bens-unit01/switchbot-complete-prj/documents/boards-shematics/pin-j20-j12.jpg

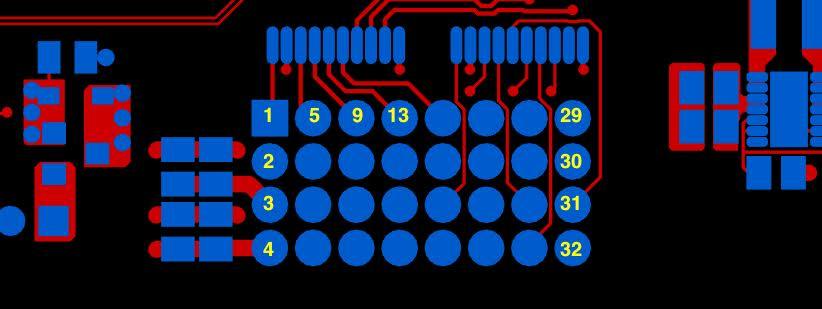
documents/boards-shematics/pin-j20-j12.jpg
