bens-unit01/switchbot-complete-prj/documents/new-features-and-suggestions.md

## New features 
```
    - Power button 
    - Microphone button
    - Pairing button
    - Support for 5-Ghz wifi 
```
## Possible network technologies 
```
 - DLNA
 - Bonjour
 - NSD (https://developer.android.com/training/connect-devices-wirelessly/nsd.html)
 - Alljoyn (https://allseenalliance.org/framework)
 - UPnP 
```
