bens-unit01/switchbot-complete-prj/microcontrollers/notes.txt

Arduino lib for NeoPixels : https://github.com/adafruit/Adafruit_NeoPixel
Product details : http://www.adafruit.com/product/1312
