bens-unit01/switchbot-complete-prj/documents/Audio/stm32_mic_interfacing_for_wowwee_13june2016.pdf

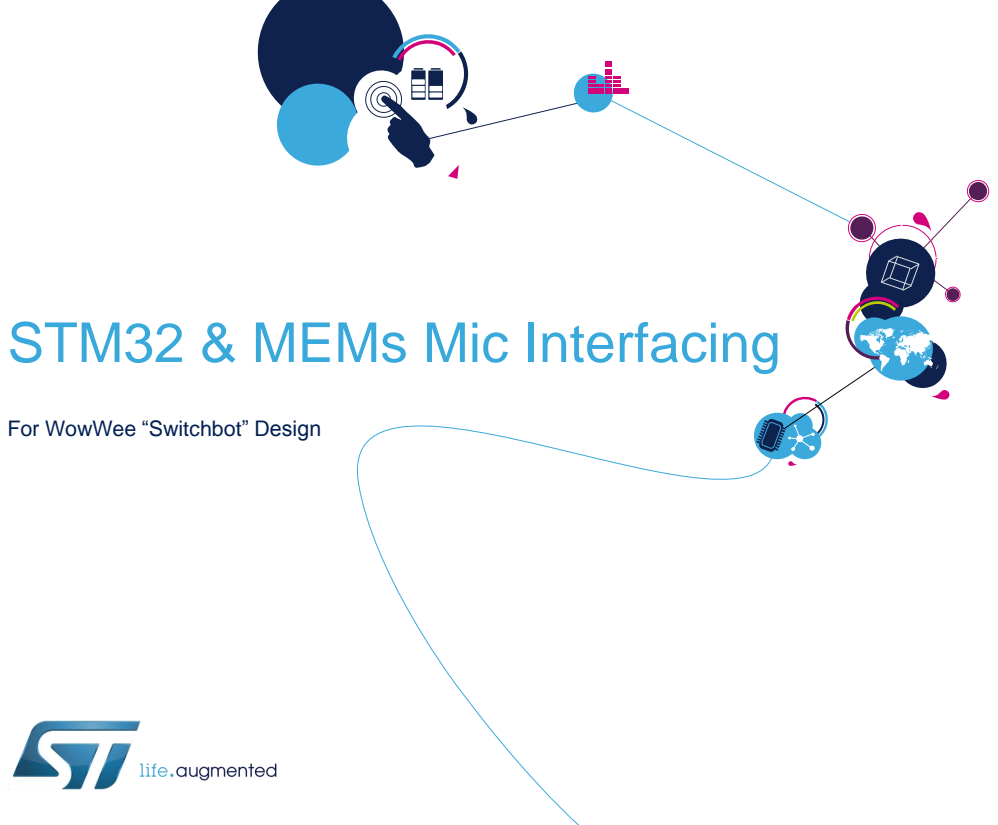
[picture p3: page 1]

STM32 & MEMs Mic Interfacing

For WowWee “Switchbot” Design

# Summary

## - This document presents recommendations for connecting ST digital MEMs microphones to an STM32F417 on WowWee’s “Switchbot” design, for the purposes of evaluating beamforming and other audio signal processing applications

## - Summary of options:

## - Option A: Single serial I2S receiver connected to 2 digital mics. Microphone PDM streams are interleaved

- Minimizes # of I2S receivers and hence required DMA channels
- Requires more board re-work + specific timers

## - Option B: Dual serial I2S receivers connected to 2 digital mics. Microphone PDM streams are separate

- Minimizes board re-work and no extra timer usage needed
- Requires additional DMA channel vs. Option A

## - Option C: Combination of option A & B to support 4 digital mics (2 serial data streams, each with 2 PDM streams interleaved)

- Requires combination of resources from Options A & B

2

# Signal/Pin Mappings

## - WowWee board -> STM32F417 I2S pin mappings

## - Choice of which I2S to use for mic vs. SOM interfacing doesn’t really matter

- For the purposes of this document we chose I2S3 (from STM32 perspective) for microphone interfacing
- May also require a timer with in/out to generate I2S clock divided by 2 (see next slides for proposed configs)
a) These signals appear to have resistor pop/no-pop options for usage as I2S or SPI. Assumed I2S usage only here.
b) Signal is routed to multiple pins via resistor options – only primary I2S usage is noted

3

WowWee | STM32F417
I2S1_CLK I2S1_DATA0 I2S1_DATA1 I2S1_WS | I2S2_CLK – PB12a Grounded I2S2_SD – PC3a I2S2_WS – PB13a
I2S2_CLK I2S2_DATA I2S2_WS | I2S3_CLK – PC10b I2S3_SD – PC12b I2S3_WS – PA15

# Timer Config – Option A/C

## - To support two mics on a single I2S, we need to use a timer to generate I2S_CLK/2 for each mic. Normally done with one STM32

timer.

## - This is not fully accounted for in the I2S signals brought out by the design, but we can make use of some of the alternate signals that already have resistor options to simplify the board rework

## - TIM2_CH1 will be used as input (taking the full speed I2S_CLK)

## - TIM3 synchronized to TIM2 through internal trigger/synchronization

## - TIM3_CH4 used to generate I2S_CLK/2 for microphones

4

# Option A - Recommended Connections 5

## STM32F417VGT6

I2S2_CLK – PB12
I2S2_SD – PC3
I2S2_WS – PB13

I2S1_CLK
I2S1_DATA1
I2S1_WS

To apps processor SOM via
level translator on schematic. Use as half-duplex channel to transmit processed audio

I2S3_CLK – PC10

I2S3_SD – PC12

I2S2_WS WS not needed,
re-purpose for
timer input

TIM2_CH1 – PA15

TIM3_CH4 – PC9

## MIC1

CLK

DOUT

LR

VDD

VSS

## MIC2

CLK

DOUT

LR

VDD

VSS

3V3

GND

# Option B - Recommended Connections 6

## STM32F417VGT6

I2S2_CLK – PB12
I2S2_SD – PC3
I2S2_WS – PB13

I2S1_CLK
I2S1_DATA1
I2S1_WS

To apps processor SOM via
level translator on schematic. Use as half-duplex channel to transmit processed audio

I2S3_CLK – PC10

I2S3_SD – PC12

I2S3_ext_SD – PC11

## MIC1

CLK

DOUT

LR

VDD

VSS

## MIC2

CLK

DOUT

LR

VDD

VSS

3V3

GND

# Option C - Recommended Connections 7

## STM32F417VGT6

I2S2_CLK – PB12
I2S2_SD – PC3
I2S2_WS – PB13

I2S1_CLK
I2S1_DATA1
I2S1_WS

To apps processor SOM via
level translator on schematic. Use as half-duplex channel to transmit processed audio

I2S3_CLK – PC10

I2S3_SD – PC12

I2S2_WS WS not needed,
re-purpose for
timer input

TIM2_CH1 – PA15

TIM3_CH4 – PC9

MIC1

CLK

DOUT

LR

VDD

VSS

3V3

GND

MIC2

CLK

DOUT

LR

VDD

VSS

MIC3

CLK

DOUT

LR

VDD

VSS

MIC4

CLK

DOUT

LR

VDD

VSS

I2S3_ext_SD – PC11

# Microphone Options

## - All of the ST digital microphones are PDM output. The two that are suggested for this application are:

8

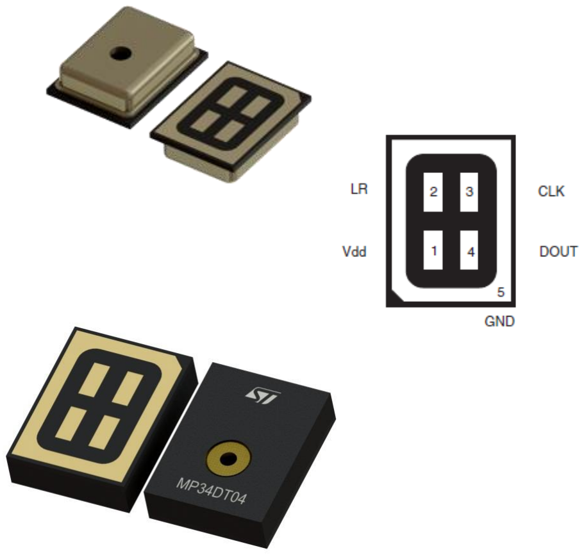
[picture p4: figure]
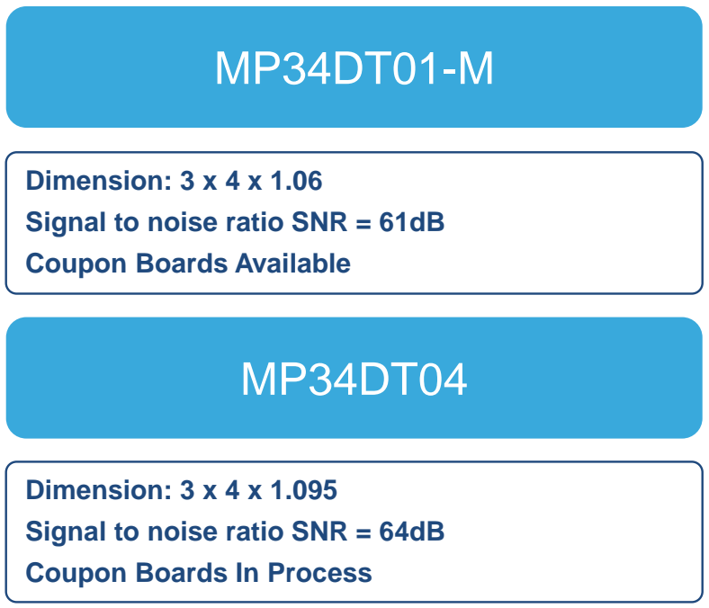
[picture p5: figure]
Dimension: 3 x 4 x 1.06; Signal to noise ratio SNR = 61dB; Coupon Boards Available; Dimension: 3 x 4 x 1.095; Signal to noise ratio SNR = 64dB; Coupon Boards In Process

## For prototyping mics – recommend using ST “coupon” boards, e.g.: http://www.st.com/content/st_com/en/products/evaluation-tools/product-

evaluation-tools/audio-ic-eval-boards/steval-mki155v3.html (http://www.st.com/content/st_com/en/products/evaluation-tools/product-evaluation-tools/audio-ic-eval-boards/steval-mki155v3.html)
