bens-unit01/switchbot-complete-prj/addons/Telepresence/TelepresenceUser/src/img/Background_DPad.png

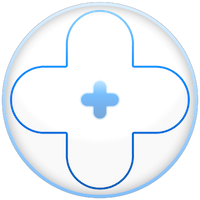
addons/Telepresence/TelepresenceUser/src/img/Background_DPad.png
