bens-unit01/switchbot-complete-prj/android/SwitchBot-class-diagram.png

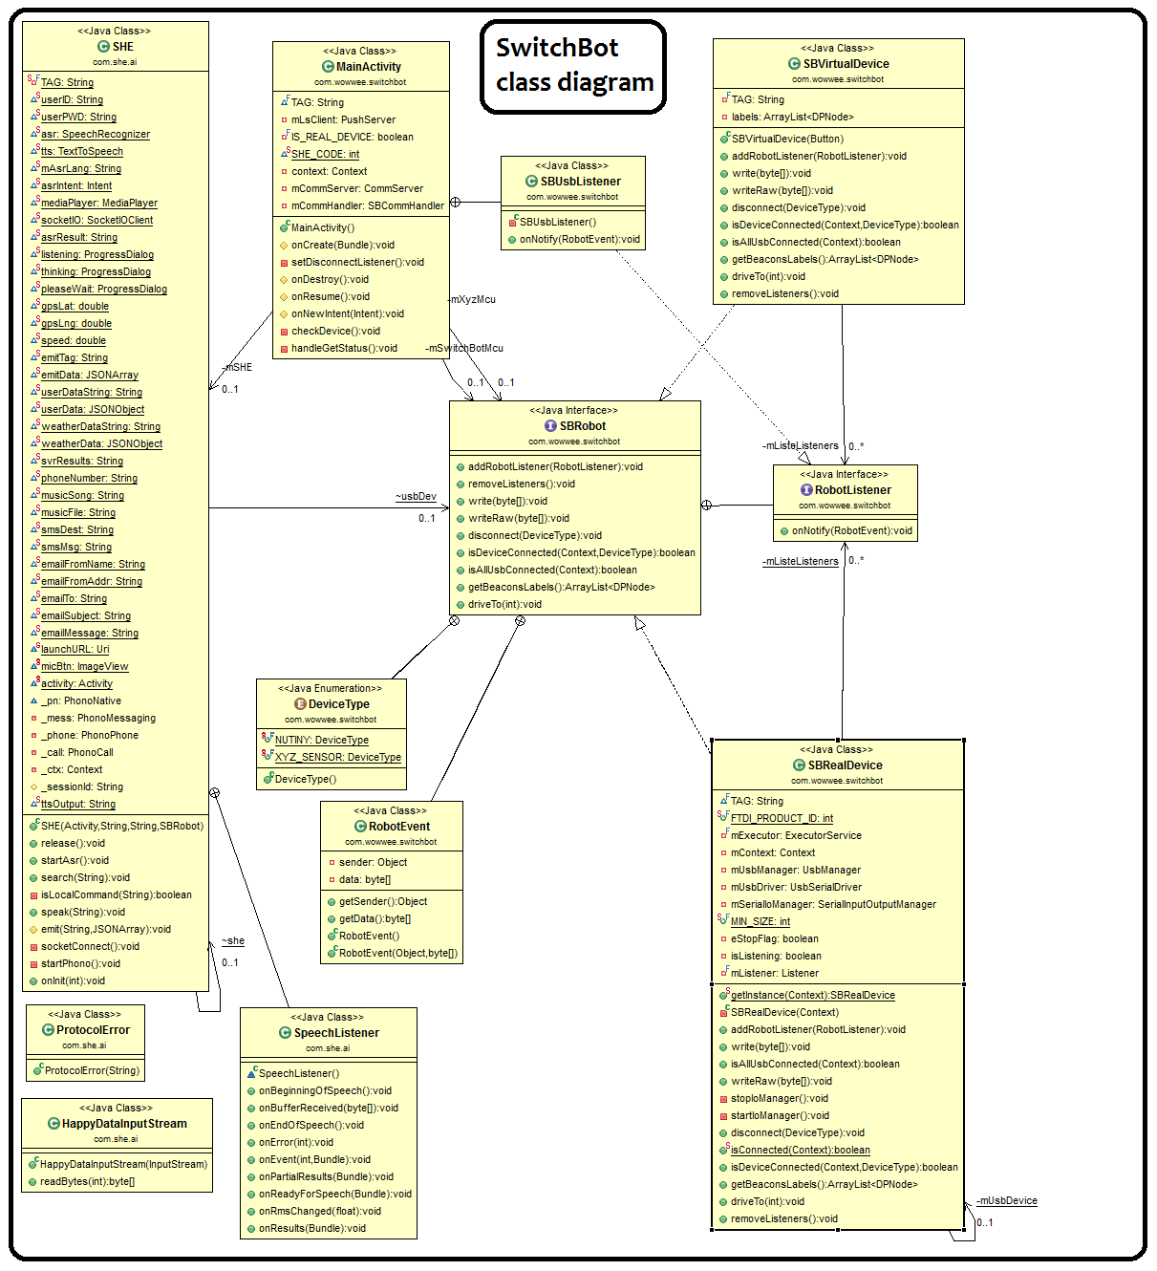
android/SwitchBot-class-diagram.png
