bens-unit01/switchbot-complete-prj/documents/boards-shematics/som-motor-power.png

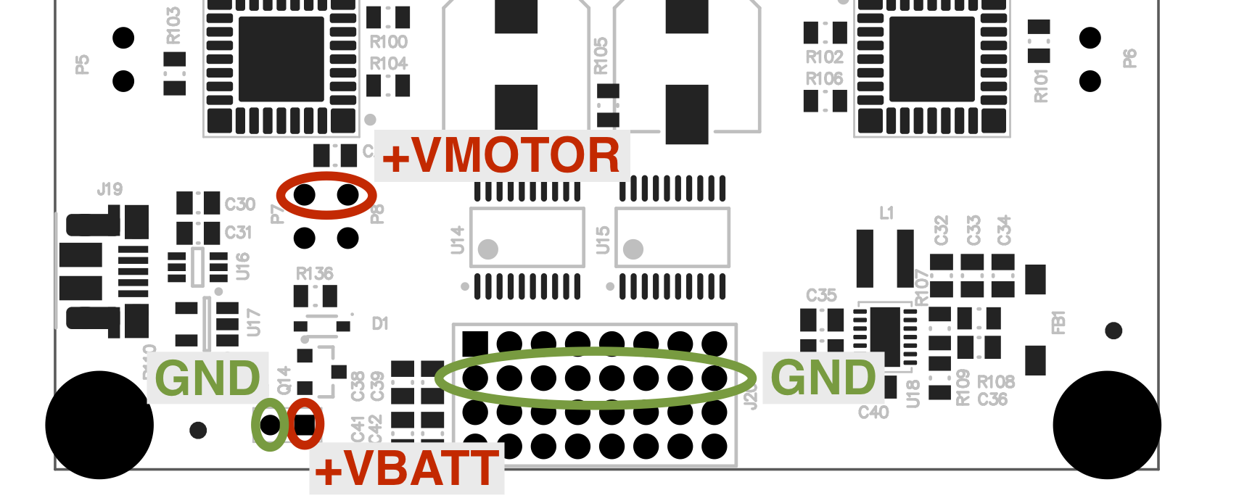
documents/boards-shematics/som-motor-power.png
