bens-unit01/switchbot-complete-prj/documents/boards-shematics/Motor Control/sommotor-BOM.xlsx

Wowwee SOM Motor Board
20160322a | Last Revision
Revision History
20160322a | Initial Release
 | Gray background are parts sourced by Andrew
 | Car-San part numbers are given in approximate order of preference
Quantity | Vendor | Mfg PN | Description | Alternatives | Notes | Digikey Part Number | Car-San Part Number | Designator
14 | Any |  | CAP 1uF 6.3V ±5% 0805 |  |  |  | 1011249LF, 1011464LF, 1011545LF, 1011030LF | C1, C39, C42, C43, C46, C48, C49, C53, C55, C60, C61, C62, C63, C65
32 | Any |  | CAP 100nF 6.3V ±10% 0805 |  |  |  | 1510364, 1010714LF, 1011250LF, 1011819LF, 1011854LF | C2, C5, C6, C7, C9, C11, C12, C13, C17, C18, C22, C24, C25, C31, C34, C38, C40, C41, C44, C45, C50, C51, C52, C54, C56, C57, C58, C59, C64, C66, C67, C69
1 | Any |  | CAP 220nF 6.3V ±20% 0805 |  |  | 490-6981-6-ND (http://www.digikey.ca/product-detail/en/murata-electronics-north-america/NFM21PC224R1C3D/490-6981-6-ND/3847194) |  | C3
2 | Any |  | CAP 2.2uF 6.3V ±20% 0805 |  |  |  | 1011462LF, 1011256LF, 1011495LF, 1011013LF | C4, C8
6 | Any |  | CAP 33nF 50V -20% to +80% 0805 |  |  | 445-2675-6-ND (http://www.digikey.ca/product-detail/en/tdk-corporation/C2012C0G1E333J125AA/445-2675-6-ND/1596682) |  | C10, C16, C19, C23, C26, C29
6 | Wurth | 865080253012 | 470 uF, 10 V, + / - 20%, Aluminum Electrolytic Capacitor |  | low ESR, high ripple | 732-8495-1-ND (http://www.digikey.ca/product-detail/en/wurth-electronics-inc/865080253012/732-8495-1-ND/5728452) |  | C14, C15, C20, C21, C27, C28
4 | Any |  | CAP 10uF 6.3V ±10% 0805 |  |  |  | 1010084LF, 1011252LF, | C30, C35, C37, C68
2 | Any |  | CAP 22uF 16V ±20% 0805 |  |  | 399-11661-6-ND (http://www.digikey.ca/scripts/DkSearch/dksus.dll?Detail&itemSeq=190086075&uq=635912567441065872) |  | C32, C33
1 | Any |  | CAP 4.7pF 10V ±0.25pF 0805 |  |  | 399-8105-6-ND (http://www.digikey.ca/scripts/DkSearch/dksus.dll?Detail&itemSeq=190086122&uq=635912569007175872) |  | C36
1 | Any |  | CAP 4.7uF 6.3V ±20% 0805 |  |  |  | 1010082LF, 1011257LF, 1510352 | C47
1 | Infineon | BAT60AE6327HTSA1 | Silicon Schottky Diode, -55 to 85 degC, SOD323 |  |  | BAT60AE6327HTSA1DKR-ND (http://www.digikey.ca/product-detail/en/infineon-technologies/BAT60AE6327HTSA1/BAT60AE6327HTSA1DKR-ND/1557958) |  | D1
1 | Murata | BLM41PG750SN1L | BLM41 |  |  | 490-4013-6-ND (http://www.digikey.ca/product-detail/en/murata-electronics-north-america/BLM41PG750SN1L/490-4013-6-ND/1826391) |  | FB1
8 | Hirose | DF13-3P-1.25DS(20) (http://www.digikey.ca/product-detail/en/hirose-electric-co-ltd/DF13-3P-1.25DS(20)/H2260-ND/241839) | 1.25mm pitch R/A TH connector, 3 pin (http://www.digikey.ca/product-detail/en/hirose-electric-co-ltd/DF13-3P-1.25DS(20)/H2260-ND/241839) |  |  | H2260-ND (http://www.digikey.ca/product-detail/en/hirose-electric-co-ltd/DF13-3P-1.25DS(20)/H2260-ND/241839) |  | J1, J2, J3, J4, J5, J6, J7, J8
4 | Hirose | DF13-2P-1.25DS(20) (http://www.digikey.ca/product-detail/en/hirose-electric-co-ltd/DF13-2P-1.25DS(20)/H2199-ND/241773) | 1.25mm pitch R/A TH connector, 2 pin (http://www.digikey.ca/product-detail/en/hirose-electric-co-ltd/DF13-3P-1.25DS(20)/H2260-ND/241839) |  |  | H2199-ND (http://www.digikey.ca/product-detail/en/hirose-electric-co-ltd/DF13-2P-1.25DS(20)/H2199-ND/241773) |  | J9, J11, J14, J15
6 | Hirose | DF13-5P-1.25DS(20) (http://www.digikey.ca/product-detail/en/hirose-electric-co-ltd/DF13-5P-1.25DS(20)/H2202-ND/241775) | 1.25mm pitch R/A TH connector, 5 pin (http://www.digikey.ca/product-detail/en/hirose-electric-co-ltd/DF13-3P-1.25DS(20)/H2260-ND/241839) |  |  | H2202-ND (http://www.digikey.ca/product-detail/en/hirose-electric-co-ltd/DF13-5P-1.25DS(20)/H2202-ND/241775) |  | J10, J12, J13, J16, J17, J18
1 | FCI | 10103594 | USB Micro connector |  |  | 609-4050-6-ND (http://www.digikey.ca/scripts/DkSearch/dksus.dll?Detail&itemSeq=190086307&uq=635912571760595872) |  | J19
1 | Samtec | SQT-108-01-F-Q | Cost-Effective Rugged Socket, Through-hole, Vertical, -55 to 125 degC, 2 mm Pitch, 32-Pin, Female, RoHS |  |  |  |  | J20
1 | JST | B2B-PH-K-S(LF)(SN) | 2mm pitch battery connector |  |  | 455-1704-ND (https://www.digikey.ca/product-detail/en/jst-sales-america-inc/B2B-PH-K-S(LF)(SN)/455-1704-ND/926611) |  | K1
1 | TDK | VLS4012ET-1R0N | 1uH 2.5A inductor |  |  | 445-6683-6-ND (http://www.digikey.ca/scripts/DkSearch/dksus.dll?Detail&itemSeq=190086726&uq=635912577969590181) |  | L1
2 | Any |  | LED RED 0402 SMD |  |  |  | 1011048LF, 4010071, 1011625LF | LED1, LED4
2 | Any |  | LED GREEN 0402 SMD |  |  |  | 1011777LF, 4010070, 4010111, 4010087 | LED2, LED3
8 | TE Connectivity | 5-103735-1 (http://www.digikey.ca/product-detail/en/te-connectivity-amp-connectors/5-103735-1/A33921-ND/1122484) | 0.100" pitch vert TH connector, 2 pin |  |  | A33921-ND (http://www.digikey.ca/product-detail/en/te-connectivity-amp-connectors/5-103735-1/A33921-ND/1122484) |  | P1, P2, P3, P4, P5, P6, P7, P8
12 | Any | MMBT3904 | SOT23 NPN Transistor |  |  | MMBT3904LT1GOSDKR-ND (http://www.digikey.ca/product-detail/en/on-semiconductor/MMBT3904LT1G/MMBT3904LT1GOSDKR-ND/1140144) |  | Q1, Q2, Q3, Q4, Q5, Q6, Q7, Q8, Q9, Q10, Q11, Q12
1 | Any | BSS84 | SOT23 P-Channel MOSFET |  |  |  | 1011865LF | Q13
1 | Diodes | DMG2305UX | SOT23 P-Channel MOSFET |  |  | DMG2305UX-7DICT-ND (http://www.digikey.ca/scripts/DkSearch/dksus.dll?Detail&itemSeq=190086903&uq=635912580803995872) |  | Q14
1 | Any |  | 56k2 0.125W 1% 0805 (2012 Metric) SMD |  |  | 541-56.2KCDKR-ND (https://www.digikey.ca/product-detail/en/vishay-dale/CRCW080556K2FKEA/541-56.2KCDKR-ND/1187460) |  | R107
8 | Any |  | 22K 0.125W 1% 0805 (2012 Metric) SMD |  |  | 541-22.0KCCT-ND (http://www.digikey.ca/product-detail/en/vishay-dale/CRCW080522K0FKEA/541-22.0KCCT-ND/1180933) |  | R1, R2, R3, R4, R5, R6, R7, R8
58 | Any |  | 10K 0.125W 1% 0805 (2012 Metric) SMD |  |  |  | 1020744LF, 1011873LF | R9, R10, R31, R32, R33, R40, R43, R44, R47, R48, R54, R55, R58, R67, R68, R75, R76, R79, R80, R83, R84, R85, R86, R87, R88, R89, R90, R91, R92, R93, R94, R95, R96, R97, R98, R99, R100, R101, R102, R103, R104, R106, R109, R110, R111, R112, R123, R124, R125, R126, R127, R128, R129, R130, R131, R132, R133, R134, R135, R136
36 | Any |  | 33R 0805 |  |  |  | 1011227LF, 1020351 | R11, R12, R13, R14, R15, R16, R17, R18, R21, R22, R23, R24, R25, R26, R27, R28, R35, R36, R37, R38, R49, R53, R56, R62, R63, R64, R65, R71, R72, R73, R74, R78, R81, R105
16 | Any |  | 3K3 0.125W 1% 0805 (2012 Metric) SMD |  |  | 541-3.30KCCT-ND (http://www.digikey.ca/product-detail/en/vishay-dale/CRCW08053K30FKEA/541-3.30KCCT-ND/1180840) |  | R19, R20, R30, R34, R39, R42, R45, R46, R51, R52, R57, R60, R61, R70, R77, R82
12 | Any |  | 220R 0.125W 1% 0805 (2012 Metric) SMD |  |  | 541-3.30KCCT-ND (http://www.digikey.ca/product-detail/en/vishay-dale/CRCW08053K30FKEA/541-3.30KCCT-ND/1180840) |  | R29, R41, R50, R59, R66, R69, R113, R116, R118, R120, R121, R122
1 | Any |  | 68K 0.125W 5% 0805 (2012 Metric) SMD |  |  | 541-68.0KCDKR-ND (http://www.digikey.ca/scripts/DkSearch/dksus.dll?Detail&itemSeq=190087162&uq=635912584185081404) |  | R108
4 | Any |  | Jumper 0805 (2012 Metric) |  |  |  | 1011223LF, 1010142LF | R114, R115, R117, R119
1 | CTS | 218-2LPSTR | 2 position SPST DIP Switch |  |  | CT3108DKR-ND (http://www.digikey.ca/product-detail/en/cts-electrocomponents/218-2LPSTR/CT3108DKR-ND/5875778) |  | S1
1 | C&K | KMR211GLFS | SPST pushbutton |  |  | 401-1426-1-ND (http://www.digikey.ca/product-detail/en/c-k-components/KMR211GLFS/401-1426-1-ND/550461) |  | SW1
1 | STMicro | STM32F417VGT6 | Cortex-M4 microcontroller |  |  | 497-11900-ND (http://www.digikey.ca/scripts/DkSearch/dksus.dll?Detail&itemSeq=190087899&uq=635912597111383905) |  | U1
1 | InvenSense | MPU-6000 | GYRO/ACCELEROMETER 6AXIS 24QFN I2C/SPI |  |  | 1428-1005-1-ND |  | U2
1 | Karin | KNRF51822 | BLE / MULTI-PROTOCOL 2.4GHz RF MODULE |  |  |  |  | U3
1 | Any | 74LVC04 | Hex Inverter |  |  | 568-2991-6-ND (http://www.digikey.ca/product-detail/en/nxp-semiconductors/74LVC04ABQ,115/568-2991-6-ND/1857604) |  | U4
3 | Any | 74LVC08 | Quad 2-Input AND Gate |  |  | 568-2993-6-ND (http://www.digikey.ca/product-detail/en/nxp-semiconductors/74LVC08ABQ,115/568-2993-6-ND/1857611) |  | U5, U6, U7
6 | Freescale | MC33926 | dual H bridge |  |  | MC33926PNBR2DKR-ND (http://www.digikey.ca/product-detail/en/freescale-semiconductor-nxp/MC33926PNBR2/MC33926PNBR2DKR-ND/3524155) |  | U8, U9, U10, U11, U12, U13
2 | Analog | ADG3300 | 8 channel level translator |  |  | ADG3300BRUZ-REEL7DKR-ND (http://www.digikey.ca/product-detail/en/analog-devices-inc/ADG3300BRUZ-REEL7/ADG3300BRUZ-REEL7DKR-ND/2091920) |  | U14, U15
1 | TI | TPD4E001DCKR | ESD protection |  |  | 296-28779-6-ND (http://www.digikey.ca/scripts/DkSearch/dksus.dll?Detail&itemSeq=190087577&uq=635912592903913200) |  | U16
1 | Microchip | MCP73811T-420I/OT | Li-Poly charge controller |  |  | MCP73811T-420I/OTDKR-ND (http://www.digikey.ca/scripts/DkSearch/dksus.dll?Detail&itemSeq=190087328&uq=635912587722095070) |  | U17
1 | TI | TPS63020 | buck/boost regulator |  |  | 296-36491-6-ND (http://www.digikey.ca/scripts/DkSearch/dksus.dll?Detail&itemSeq=190087850&uq=635912596349665872) |  | U18
1 | SiLabs | 501ABA8M00000DAG | OSC CMEMS 8.000MHZ LVCMOS SMD |  |  | 336-2873-ND (http://www.digikey.ca/product-detail/en/silicon-labs/501ABA8M00000DAG/336-2873-ND/4581983) |  | Y1
DO NOT POPULATE DESIGNATORS
J1-J18 |  |  | Hirose connectors, TH
J20 |  |  | Samtec connector, TH
K1 |  |  | JST connector, TH
P1-P8 |  |  | TE Connectivity connectors, TH
R11, R12, R13, R14, R15, R16, R17, R18 |  |  | Steers detectors to BLE
R19, R42, R51, R60 |  |  | steers emitters to BLE
R115, R117 |  |  | for alternate CPU
R62, R64, R71, R74 |  |  | connects SOM I2S1 interface to STM32
R35, R36, R37, R38, R56 |  |  | connects SOM I2S2 interface to STM32
