bens-unit01/switchbot-complete-prj/documents/boards-shematics/SOM/sombreakout-bom.xlsx

Quantity | Digikey | Price | Extended | Ten |  | Designator | Comment | Footprint | LibRef
16 | 587-2396-1-ND | 0.4 | 6.4 | 64 |  | C1, C2, C3, C4, C7, C8, C15, C25, C35, C38, C39, C50, C52, C53, C75, C81 | CAP 10uF 6.3V 0805(2012) | CAPC0805(2012)100_L | CMP-1036-04917-1, CMP-1036-04917-1, CMP-1036-04917-1, CMP-1036-04917-1, CMP-1036-04917-1, CMP-1036-04917-1, CMP-1036-04917-1, CMP-1036-04917-1, CMP-1036-04917-1, CMP-1036-04920-1, CMP-1036-04920-1, CMP-1036-04917-1, CMP-1036-04920-1, CMP-1036-04920-1, CMP-1036-04917-1, CMP-1036-04920-1
4 | 445-8203-1-ND | 0.78 | 3.12 | 31.2 |  | C5, C59, C60, C63 | CAP 1uF 6.3V 0805(2012) | CAPC0805(2012)100_L | CMP-1036-04730-1
1 | 399-1170-1-ND | 0.15 | 0.15 | 1.5 |  | C6 | CAP 100nF 6.3V 0805(2012) | CAPC0805(2012)100_N | CMP-1036-04391-1
12 | 445-8199-1-ND | 0.55 | 6.6 | 66 |  | C9, C11, C17, C20, C22, C24, C28, C34, C44, C49, C69, C72 |  | CAPC0805(2012)100_L | CMP-1036-04520-1, CMP-1036-04520-1, CMP-1036-04411-1, CMP-1036-04411-1, CMP-1036-04411-1, CMP-1036-04411-1, CMP-1036-04391-1, CMP-1036-04917-1, CMP-1036-04391-1, CMP-1036-04917-1, CMP-1036-04411-1, CMP-1036-04411-1
1 | 1276-2974-1-ND | 0.3 | 0.3 | 3 |  | C10 | CAP 4.7uF 6.3V 0805(2012) | CAPC0805(2012)100_L | CMP-1036-04879-1
10 | 445-6797-1-ND | 1.15 | 11.5 | 115 |  | C12, C21, C26, C30, C41, C42, C43, C48, C54, C66 | CAP 22uF 16V 0805(2012) | CAPC0805(2012)145_L | CMP-1036-04946-1
14 | 490-1673-1-ND | 0.15 | 2.1 | 21 |  | C13, C18, C19, C23, C27, C40, C47, C64, C65, C67, C68, C70, C71, C73 | CAP 100nF 25V 0805(2012) | CAPC0805(2012)100_L | CMP-1036-04411-1
21 | 399-1170-1-ND | 0.15 | 3.15 | 31.5 |  | C14, C16, C29, C33, C36, C37, C45, C51, C55, C57, C58, C61, C62, C74, C76, C77, C78, C79, C80, C82, C83 | CAP 100nF 6.3V 0805(2012) | CAPC0805(2012)100_L | CMP-1036-04391-1
2 | 445-6797-1-ND | 1.15 | 2.3 | 23 |  | C31, C32 | CAP 22uF 4V 0805(2012) | CAPC0805(2012)100_L | CMP-1036-04937-1
2 | 1276-1832-1-ND | 0.15 | 0.3 | 3 |  | C46, C56 | CAP 4.7pF 10V 0805(2012) | CAPC0805(2012)100_L | CMP-1036-00526-1
1 | MMBD914LT1GOSCT-ND | 0.18 | 0.18 | 1.8 |  | D1 | MMBD914LT1G | ONSC-SOT-23-3-318-08_V | CMP-1054-00123-1
2 | 497-3381-1-ND | 0.66 | 1.32 | 13.2 |  | D2, D3 | BAT20 | SOD323 | BAT20-SOD323
3 | 490-4013-1-ND | 0.48 | 1.44 | 14.4 |  | FB1, FB2, FB3 | BLM41PG750SN1L | MURA-BLM41-B35-CHIP-2_V2 | CMP-0686-00749-2
2 | WM9775CT-ND | 4.08 | 8.16 | 81.6 |  | J1, J2 | 5025983393 | J_MOLEX_50259833 | 5025983393
4 | H2199-ND | 0.61 | 2.44 | 24.4 |  | J3, J4, J5, J7 | DF13-2P-1.25DS(20) | HRS_DF13-2P-1.25DS(20) | CON_HRS_DF13-2P-1.25DS(20)
1 | 609-4050-1-ND | 1.08 | 1.08 | 10.8 |  | J6 | MICRO-USB | USB_MICRO_B_SMT | MICRO-USB
4 | H2201-ND | 0.76 | 3.04 | 30.4 |  | J8, J9, J10, J11 | DF13-4P-1.25DS(20) | HRS_DF13-4P-1.25DS(20) | CON_HRS_DF13-4P-1.25DS(20)
1 | SQT-108-01-L-Q | ?? | 0 | 0 | samtec | J12 | SQT-108-01-L-Q | SMTC-SQT-108-01-X-Q | CMP-1021-00092-1
1 | 455-1704-ND | 0.25 | 0.25 | 2.5 |  | K1 | JMPR2-2MM | JMPR2-2MM | JMPR2-2MM
4 | 732-2952-1-ND | 1.37 | 5.48 | 54.8 |  | L1, L2, L3, L4 | 1uH | SMD 0805_A | CMP-1392-00033-1
2 | 732-5396-1-ND | 1.37 | 2.74 | 27.4 |  | L5, L9 | 3.3uH | SMD 0805_A | CMP-1392-00033-1
1 | 445-6683-1-ND | 1.37 | 1.37 | 13.7 |  | L6 | SHIELDED_INDUCTOR | COILCRAFT_XFL4020 | SHIELDED_INDUCTOR
2 | 445-16727-1-ND | 1.49 | 2.98 | 29.8 |  | L7, L8 | XFL4020-TBD | COILCRAFT_XFL4020 | SHIELDED_INDUCTOR
7 | VLMG1500-GS08CT-ND | 0.78 | 5.46 | 54.6 |  | LED1, LED3, LED4, LED5, LED6, LED7, LED8 | VLMG1500-GS08 | LEDC0402(1005)_N-GRN | LED_0402_VLMG1500-GS08
1 | VLMS1500-GS08CT-ND | 0.78 | 0.78 | 7.8 |  | LED2 | VLMS1500-GS08 | LEDC0402(1005)_N-RED | LED_0402_VLMS1500-GS08
2 | NTJD4158CT1GOSCT-ND | 0.63 | 1.26 | 12.6 |  | Q1, Q2 | NTJD4158CT2G | ONSC-SC70-6-419B-02_W_V | CMP-1058-00639-1
1 | BSS84LT1GOSCT-ND | 0.51 | 0.51 | 5.1 |  | Q3 | BSS84LT1G | ONSC-SOT-23-3-318-08_V | CMP-1058-00762-1
7 | MF-MSMF050-2CT-ND | 0.33 | 2.31 | 23.1 |  | R1, R2, R13, R100, R101, R103, R104 | MF-MSMF050 | BOUR-MF-MSMF050-2_V | CMP-0280-00002-2
10 | 541-33.0CCT-ND | 0.142 | 1.42 | 14.2 |  | R3, R6, R7, R8, R9, R10, R11, R12, R48, R65 | 33R 1% 0805(2012) | RESC0805(2012)_L | CMP-1013-00341-1
6 | 541-4.70KCCT-ND | 0.142 | 0.852 | 8.52 |  | R4, R5, R14, R15, R19, R20 | 4K7 1% 0805(2012) | RESC0805(2012)_L | CMP-1013-00586-1
33 | 541-10.0KCCT-ND | 0.142 | 4.686 | 46.86 |  | R16, R17, R18, R21, R22, R23, R24, R25, R26, R27, R31, R32, R38, R41, R43, R49, R50, R54, R58, R60, R70, R73, R74, R79, R82, R87, R91, R92, R93, R94, R95, R96, R99 |  | RESC0805(2012)_L | CMP-1013-00623-1, CMP-1013-00623-1, CMP-1013-00623-1, CMP-1013-00623-1, CMP-1013-00623-1, CMP-1013-00623-1, CMP-1013-00623-1, CMP-1013-00623-1, CMP-1013-00623-1, CMP-1013-00623-1, CMP-1013-00623-1, CMP-1013-00623-1, CMP-1013-00623-1, CMP-1013-00623-1, CMP-1013-00623-1, CMP-1013-00623-1, CMP-1013-00623-1, CMP-1013-00341-1, CMP-1013-00341-1, CMP-1013-00623-1, CMP-1013-00623-1, CMP-1013-00623-1, CMP-1013-00623-1, CMP-1013-00645-1, CMP-1013-00623-1, CMP-1013-00645-1, CMP-1013-00623-1, CMP-1013-00623-1, CMP-1013-00623-1, CMP-1013-00623-1, CMP-1013-00623-1, CMP-1013-00623-1, CMP-1013-00341-1
13 | 541-100KCCT-ND | 0.142 | 1.846 | 18.46 |  | R28, R29, R30, R33, R34, R35, R55, R67, R68, R69, R71, R72, R90 | 100k | RESC0805(2012)_L | CMP-1013-00623-1
20 | 541-10.0KCCT-ND | 0.142 | 2.84 | 28.4 |  | R36, R37, R39, R40, R42, R44, R45, R46, R47, R51, R52, R53, R57, R59, R66, R83, R84, R85, R89, R98 | 10K 1% 0805(2012) | RESC0805(2012)_L | CMP-1013-00623-1
1 | 541-47.0KCCT-ND | 0.142 | 0.142 | 1.42 |  | R56 | 47K 1% 0805(2012) | RESC0805(2012)_L | CMP-1013-00699-1
6 | 541-20.0KCCT-ND | 0.142 | 0.852 | 8.52 |  | R61, R62, R64, R75, R76, R81 | 20K 1% 0805(2012) | RESC0805(2012)_N | CMP-1013-00655-1
2 | 541-68.0KCCT-ND | 0.142 | 0.284 | 2.84 |  | R63, R77 | 68k | RESC0805(2012)_N | CMP-1013-00655-1
2 | 541-16.2KCCT-ND | 0.142 | 0.284 | 2.84 |  | R78, R86 | 16K2 1% 0805(2012) | RESC0805(2012)_L | CMP-1013-00645-1
2 | 541-68.0KCCT-ND | 0.142 | 0.284 | 2.84 |  | R80, R88 | 68K 5% 0805(2012) | RESC0805(2012)_L | CMP-1013-00118-1
1 | 541-10.0KCCT-ND | 0.142 | 0.142 | 1.42 |  | R97 | 10k | RESC0805(2012)_L | CMP-1013-00623-1
1 | 541-12.0KCCT-ND | 0.142 | 0.142 | 1.42 |  | R102 | 12k | RESC0805(2012)_L | CMP-1013-00623-1
2 | CKN10506CT-ND | 0.65 | 1.3 | 13 |  | S1, S2 | ButtonTACT_3x4x2_180 | ButtonTACT_3x4x2_180 | ButtonTACT_3x4x2_180
1 | CT2182LPST-ND | 1.58 | 1.58 | 15.8 |  | S3 | SW-DIP4-SMD | SO4SW | SW-DIP4-SMD
1 | 401-1426-1-ND | 0.81 | 0.81 | 8.1 |  | S4 | KMR211GLFS | KMR2 | SW_KMR211G LFS
1 | A101492CT-ND | 3.1 | 3.1 | 31 |  | SD1 | SD_Card_TF | SD_Card_TF | SD_Card_TF
1 | 296-42064-1-ND | 1.56 | 1.56 | 15.6 |  | U1 | TCA9543A | SO14 | TCA9543A
5 | EMI4182MTTAG | 0.5029 | 2.5145 | 25.145 | verical | U2, U3, U4, U5, U6 | EMI4182MTTAG | ONSC-WDFN-10-511BM-01_V | CMP-1066-00059-1
1 | 568-9919-1-ND | 1.75 | 1.75 | 17.5 |  | U7 | PCA9555A | SSOP24 | PCA9555SSOP24
1 | 497-13902-1-ND | 7.35 | 7.35 | 73.5 |  | U8 | LSM9DS0TR | STM-LGA-24_V | CMP-1273-00002-1
1 | MCP73811T-420I/OTCT-ND | 0.51 | 0.51 | 5.1 |  | U9 | MCP73811T-420I/OT | SOT-23-OT5_M | CMP-0133-00139-1
1 | TDA7491LP13TR | 3.4 | 3.4 | 34 | verical | U10 | TDA7491LP | POWERSSO-36 | TDA7491LP
5 | 296-28779-1-ND | 0.66 | 3.3 | 33 |  | U11, U18, U19, U20, U21 | TPD4E001DCKR | DCK0006A_M | CMP-0326-00066-2
2 | 296-37680-1-ND | 2.46 | 4.92 | 49.2 |  | U12, U16 | TPS61086 | SON50P300X300X100-11T175X250N | TPS61086
1 | USB2514BI-AEZG | 5.97 | 5.97 | 59.7 | verical | U13 | USB2514AEZG | QFN36 | USB2514AEZG
1 | 296-15901-1-ND | 4.29 | 4.29 | 42.9 |  | U14 | TPS62044DRCRG4 | DRC10-2400X1650TP | CMP-0323-00557-1
2 | 296-36491-1-ND | 4.76 | 9.52 | 95.2 |  | U15, U17 | TPS63020 | VSON14 | TPS63020
1 | 336-2873-ND | 1.57 | 1.57 | 15.7 |  | Y1 | 8MHz | OSC_DFN165P250X90-4N | OSC_MEMS_8.000MHZ
 |  |  | 143.9385 | 1439.385
