bens-unit01/switchbot-complete-prj/documents/boards-shematics/Required%20Hardware%20changes%20on%20Wowwee%20Carrier%20Board.xlsx

# | Change | Reason
1 | Remove R40 | Pin-135 of SoM has pre-defined function of Key-pad sensing so during boot-up it should be floating. After Boot-up, this pin can be used as GPIO.
2 | Remove U11 | ESD is creating issue in USB Interface (It may be board specific or chip is damaged or chip is causing issue)
3 | Pull-up resistor of 1k or 10k (with 1.8V) on SD_DETECT# pin (pin-137 of SoM) | If this pin is floating, it gives error in logs. Processor requires this pin to be pull-up to 1.8V
4 | Remove U9 and provide VBATT from J12 | To use Charging IC, It is required to connect Battery on VBATT (we have not validated this chip)
5 | Remove R22 | This pin is used to boot processor from USB. This pin should not be used for other function
6 | Remove R65 | Pin-25 of SoM is used for switching USB Lines to Host port. If this pin is high, USB device will not work
