bens-unit01/switchbot-complete-prj/documents/boards-shematics/Motor Control/sommotor-schematic-20160404.pdf

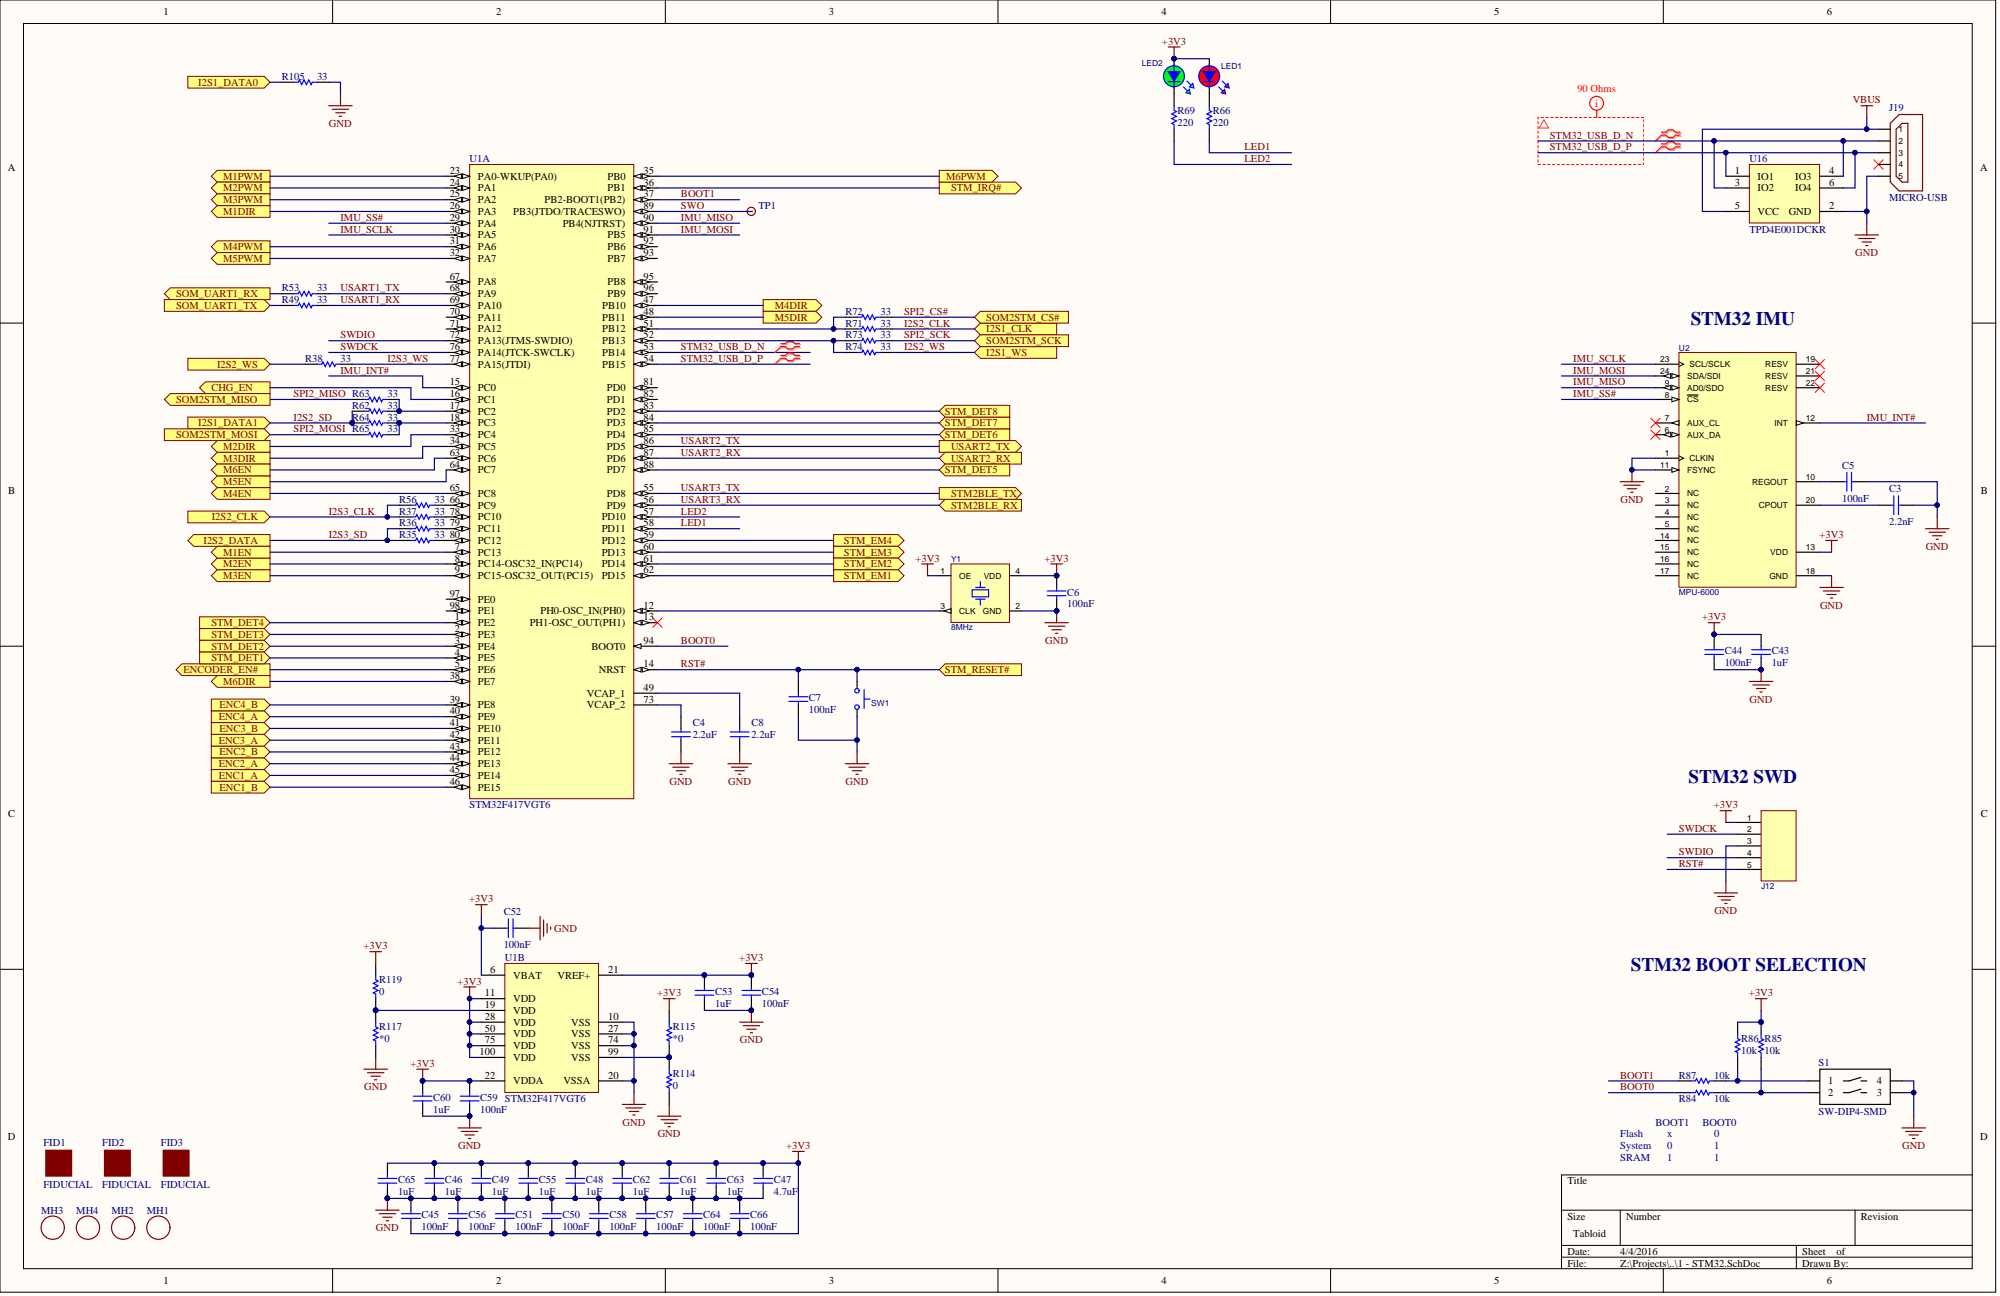
[picture p26: page 1]

PC15-OSC32_OUT(PC15) 9 | OE 1 GND

PE1 98 | 2 CLK 3

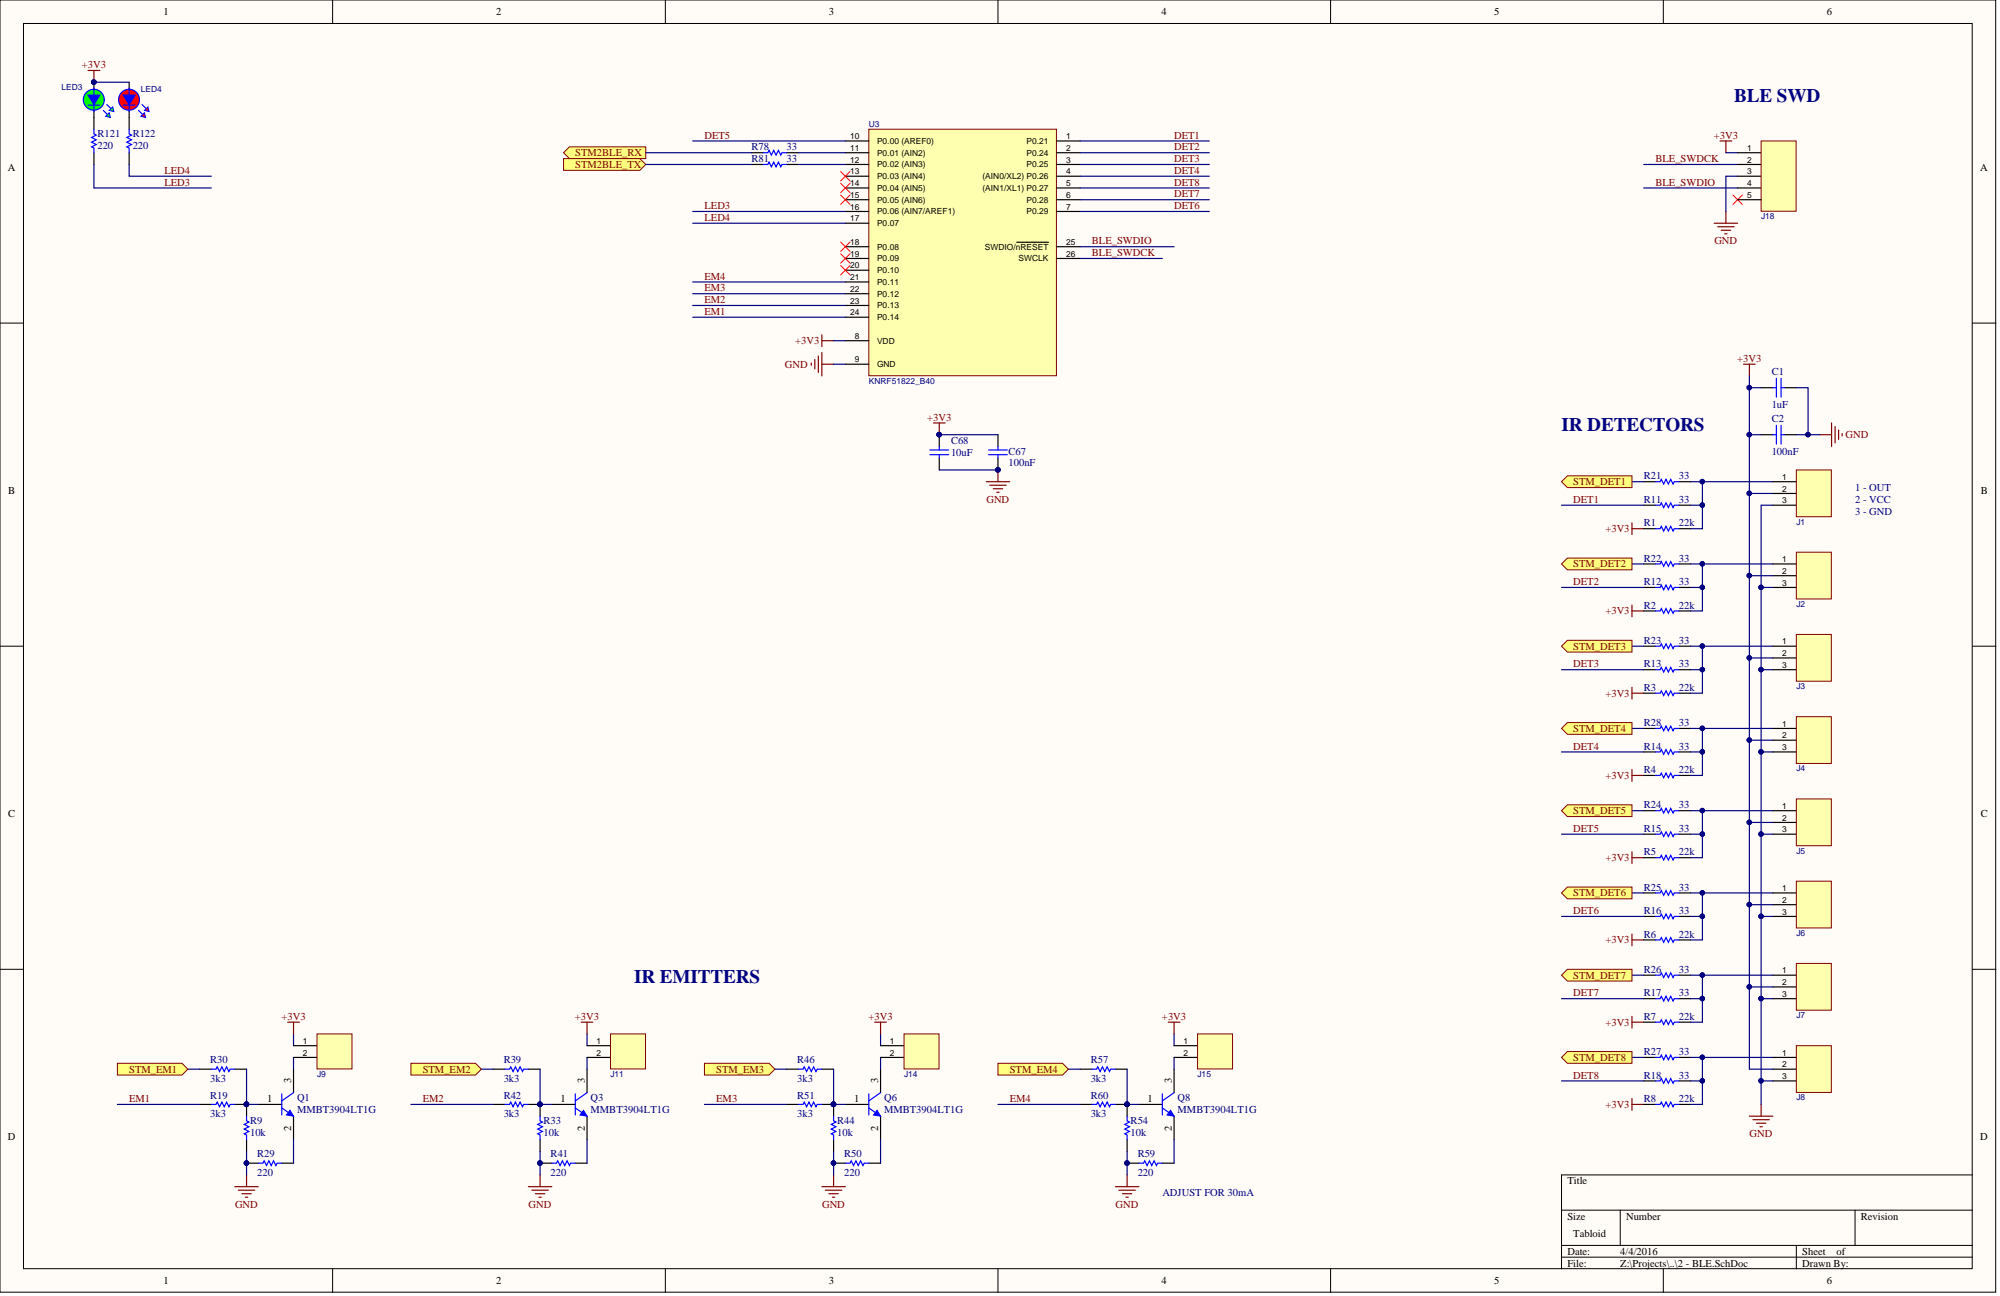
[picture p27: page 2]

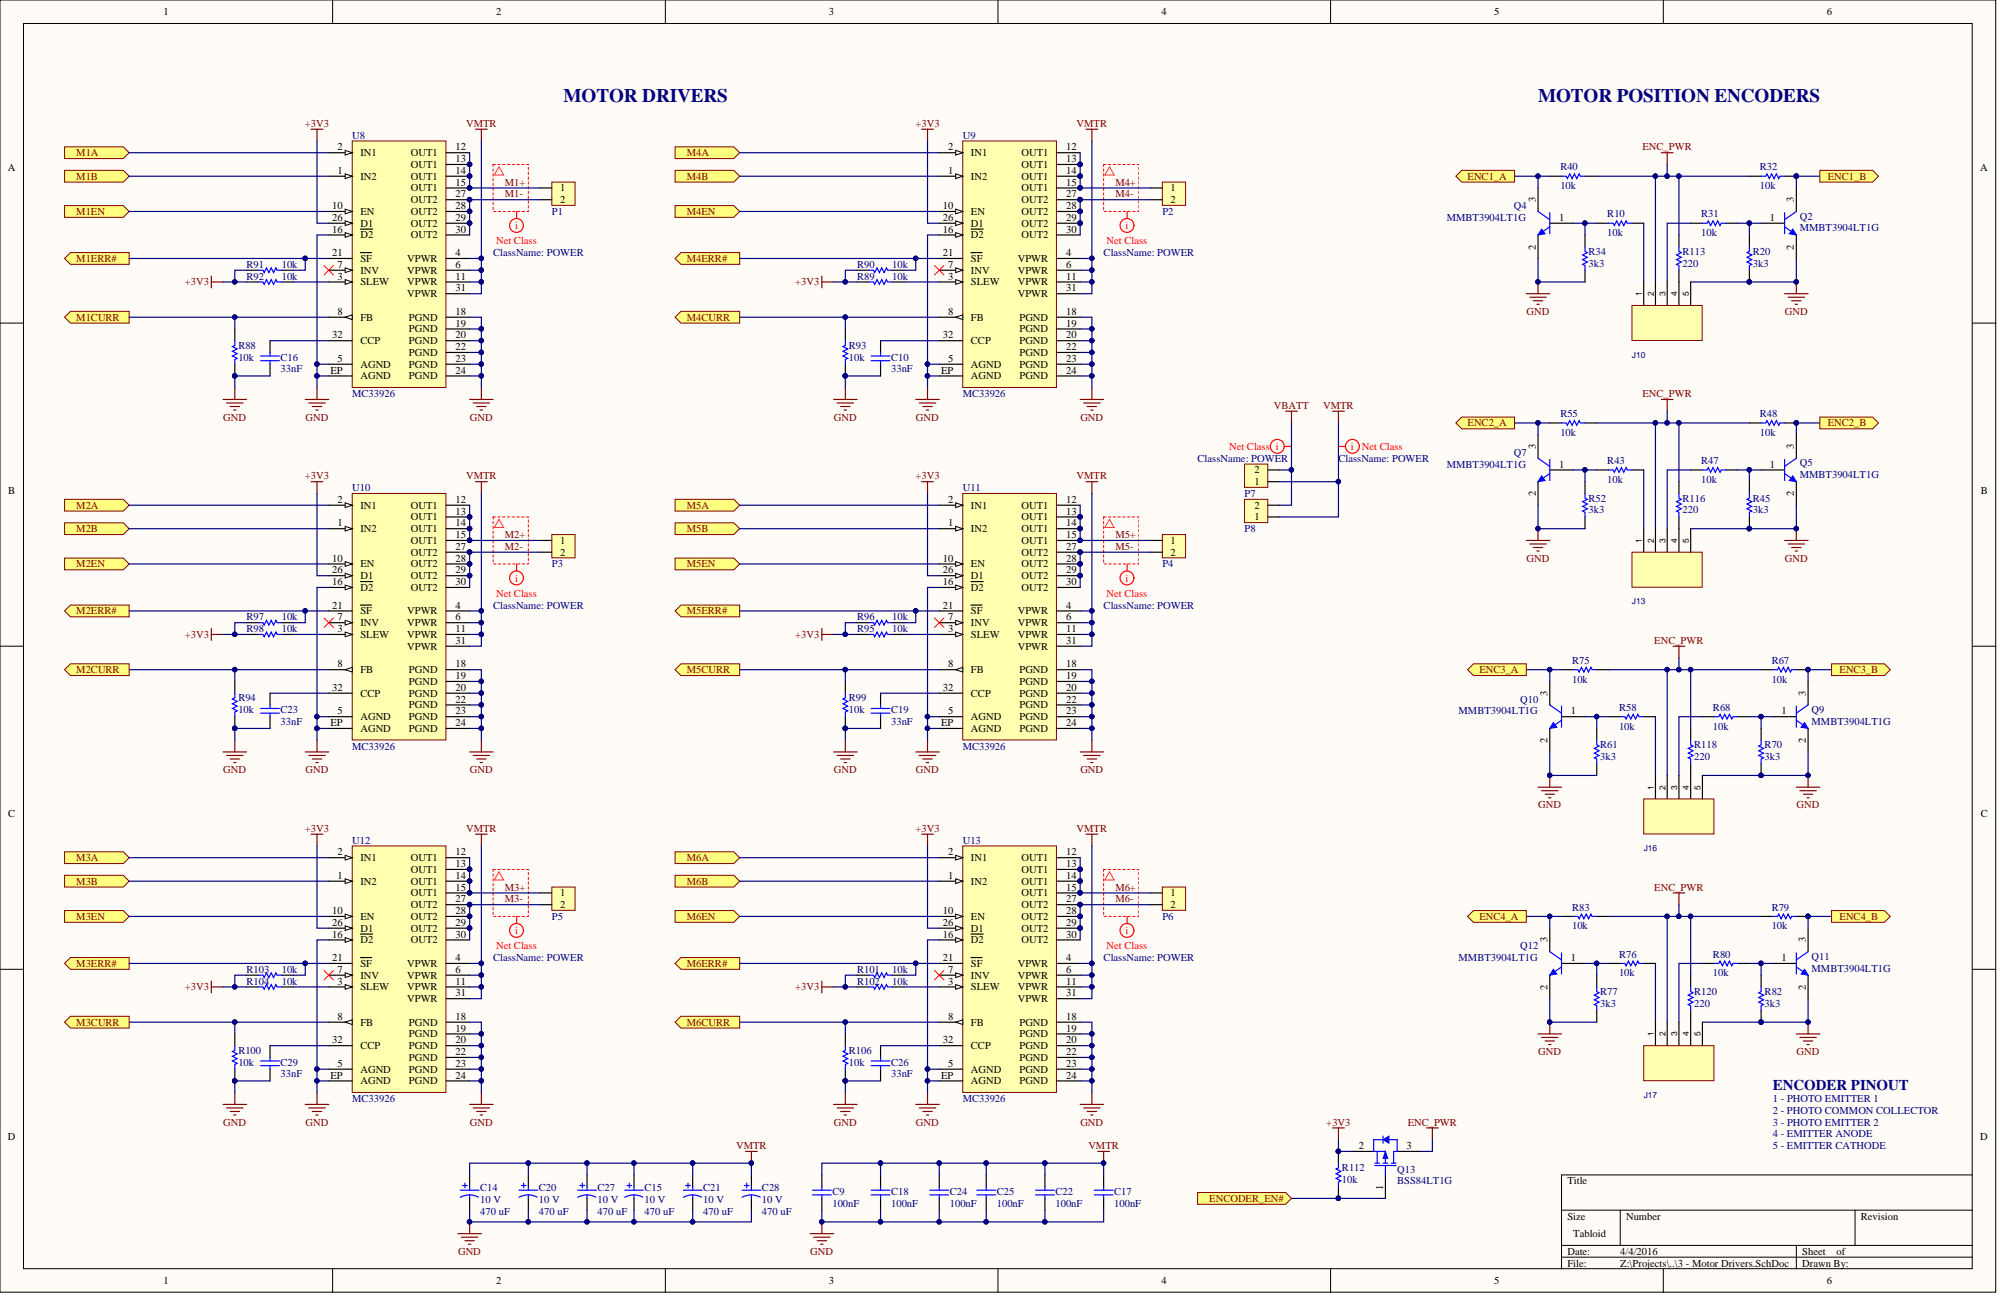
[picture p28: page 3]

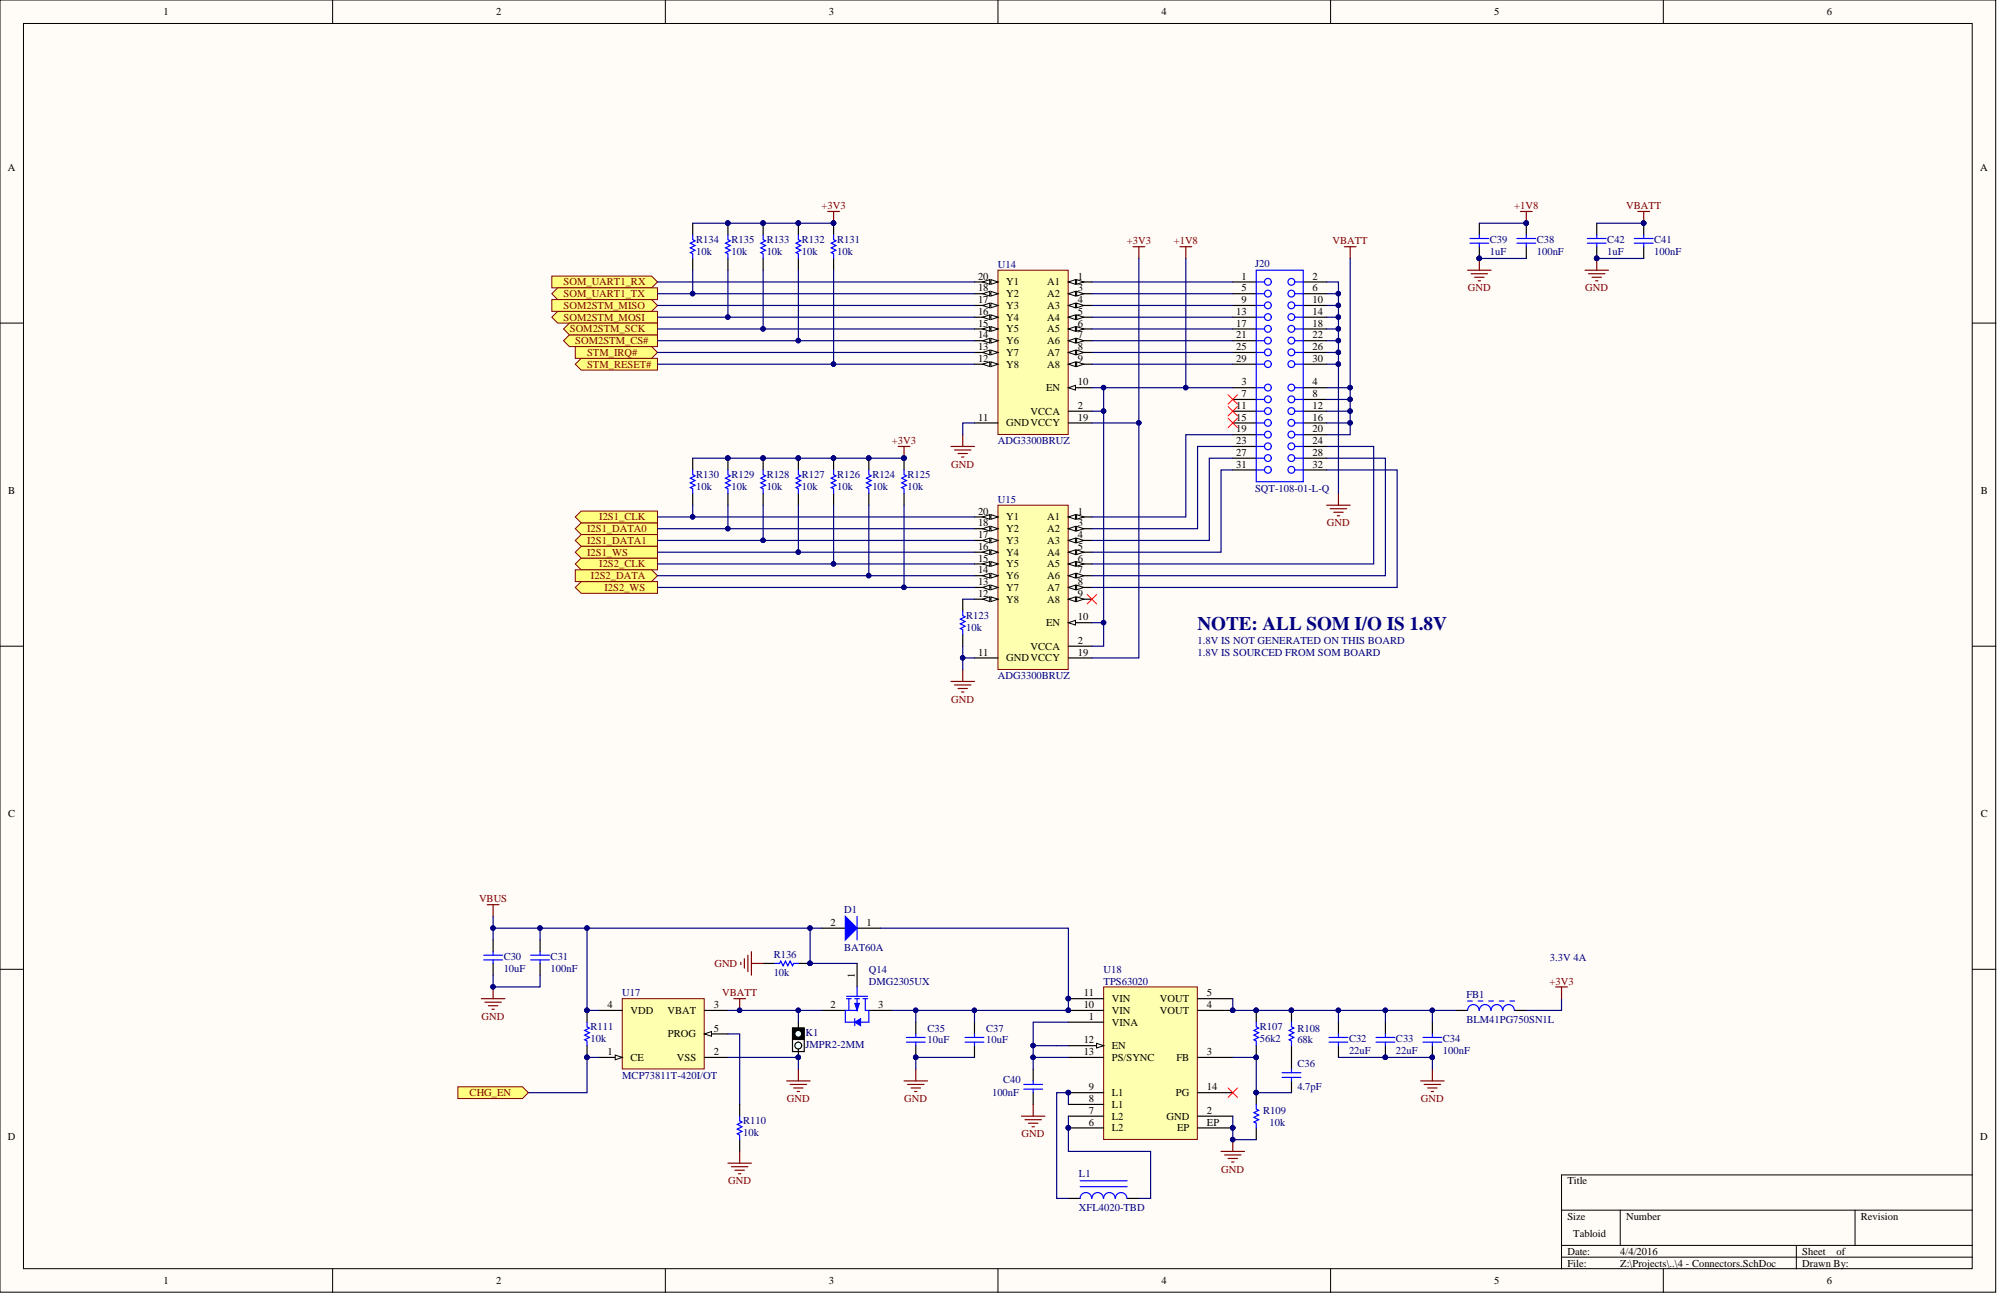
[picture p29: page 4]

23 | 24
27 | 28
31 | 32

NOTE: ALL SOM I/O IS 1.8V

1.8V IS NOT GENERATED ON THIS BOARD
1.8V IS SOURCED FROM SOM BOARD

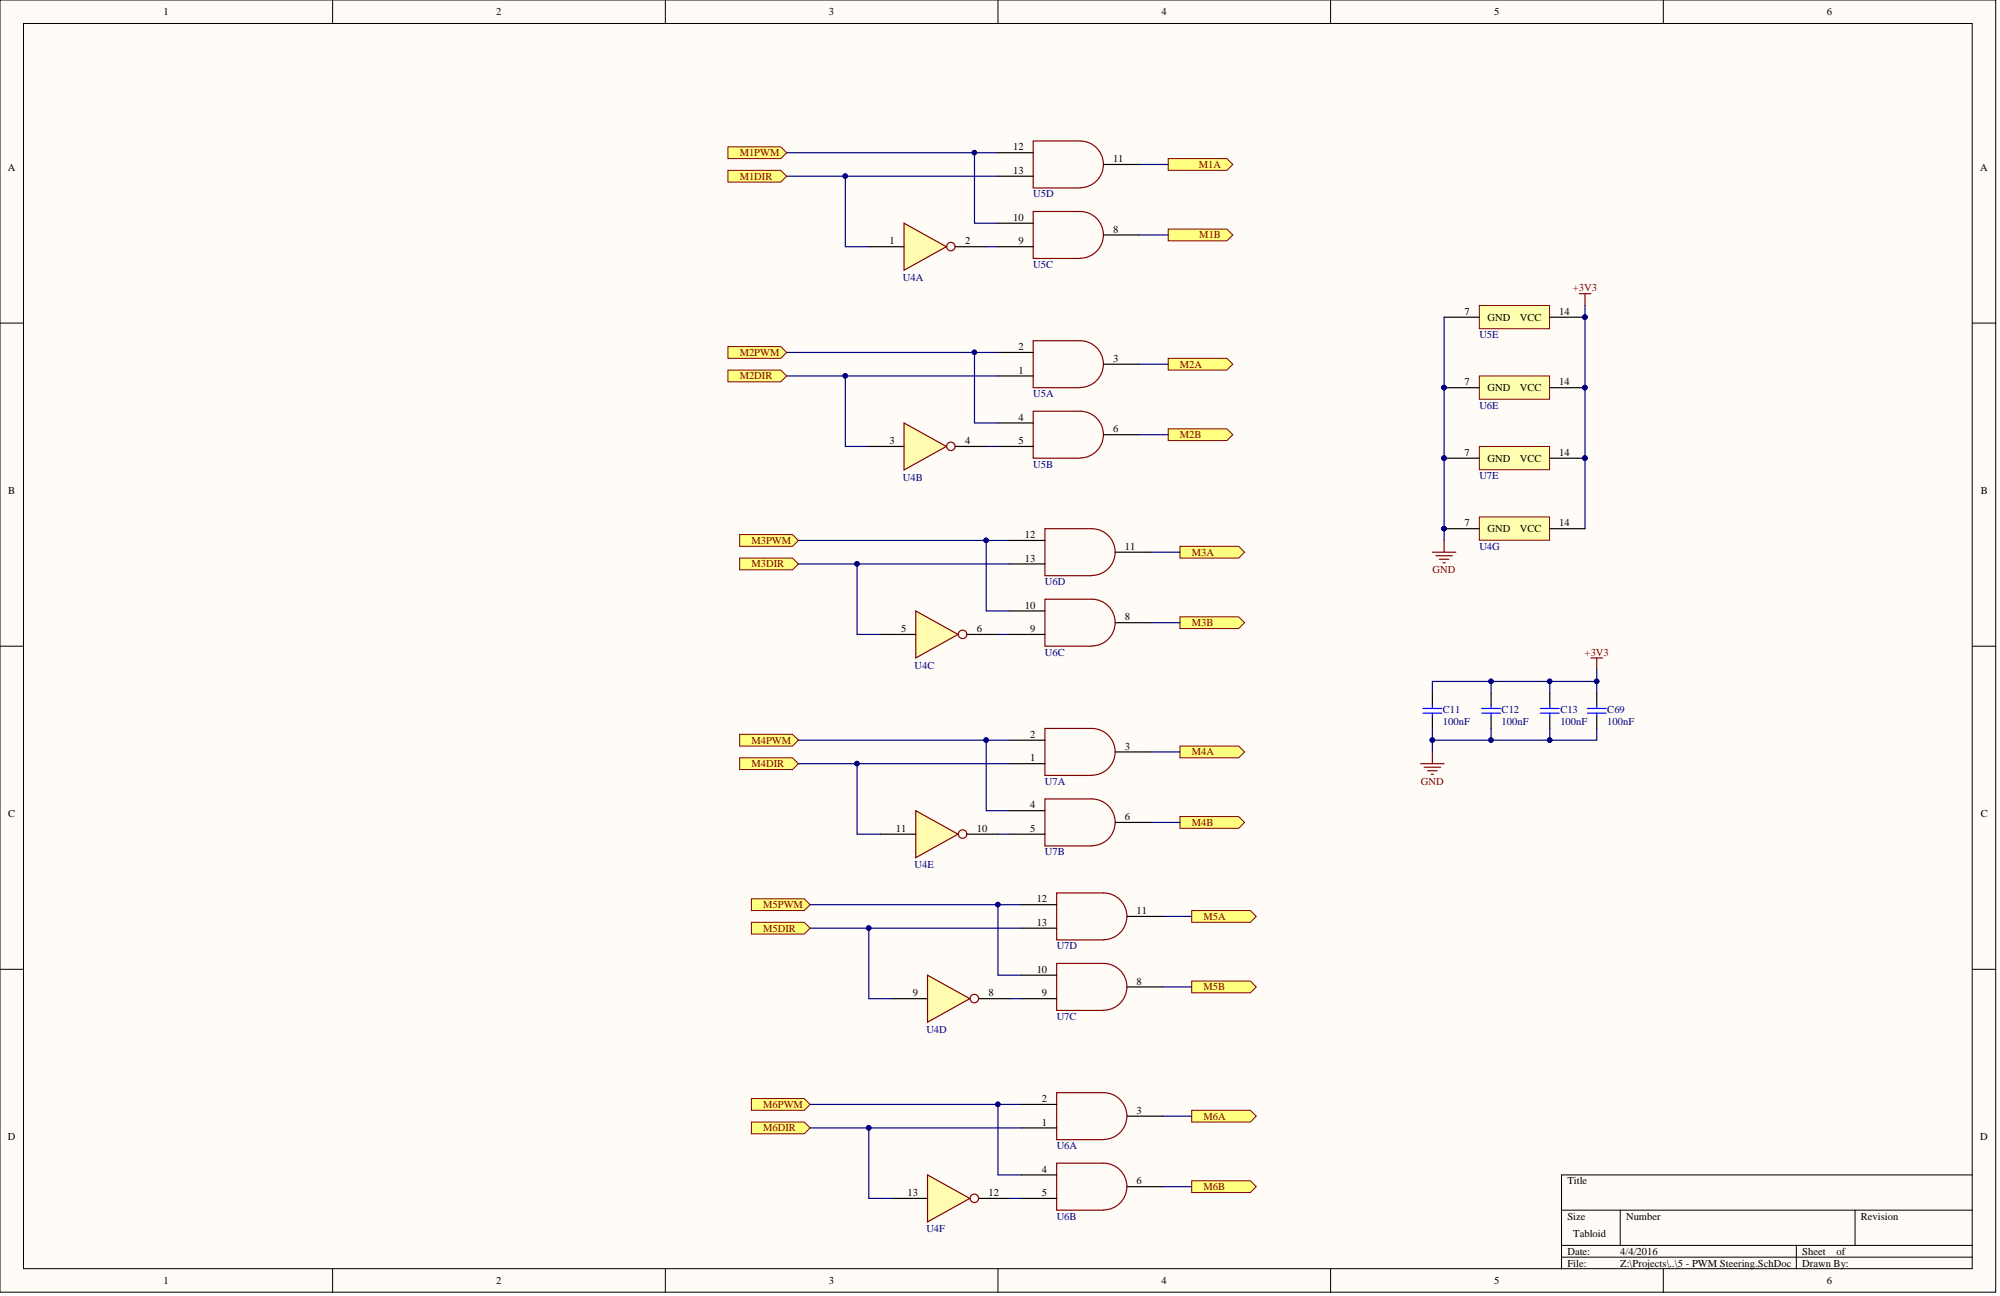
[picture p30: page 5]
