bens-unit01/switchbot-complete-prj/documents/kudo rev2 block diagram 20160921b.pdf

A

B

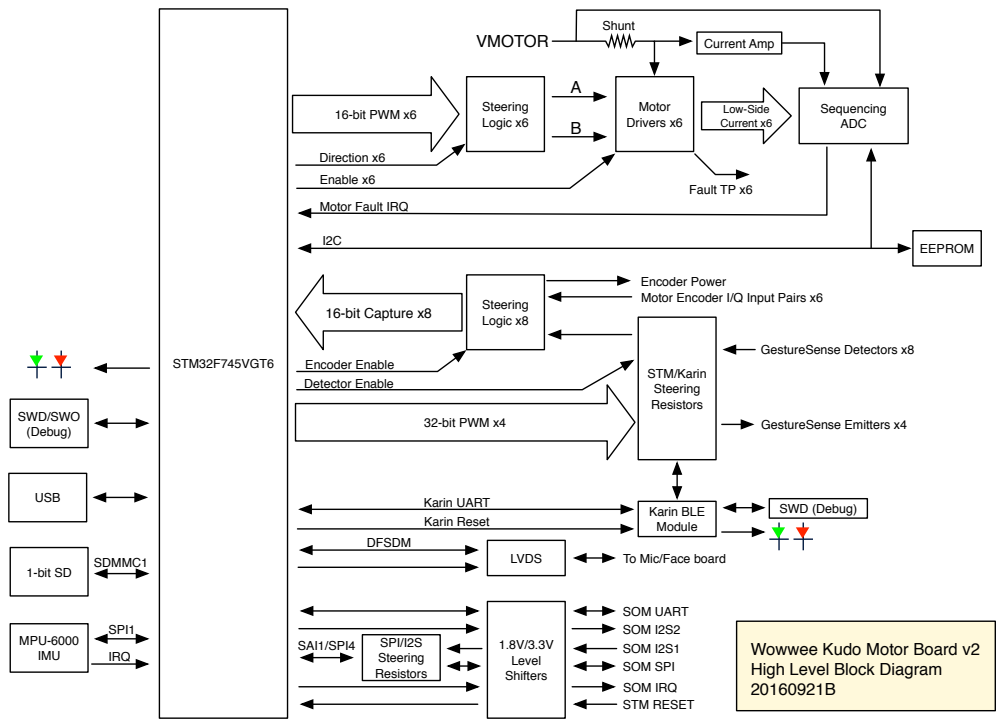
[picture p31: page 1]
STM32F745VGT6; 16-bit PWM x6; Steering; Logic x6; Direction x6; Motor Drivers x6; Enable x6; Fault TP x6; Low-Side Current x6; Sequencing ADC; VMOTOR; Current Amp; Shunt; EEPROM I2C; Encoder Enable; STM/Karin Steering Resistors; GestureSense Detectors x8; 32-bit PWM x4; GestureSense Emitters x4; SPI/I2S Steering; Resistors; SOM SPI; SAI1/SPI4; SOM I2S1; SOM IRQ; SOM I2S2; SOM UART; Detector Enable; MPU-6000 IMU; SPI1; IRQ; STM RESET; 1-bit SD; SDMMC1; USB; SWD/SWO (Debug); Karin UART; LVDS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

Motor Fault IRQ

Encoder Power
Motor Encoder I/Q Input Pairs x6

Logic x8 16-bit Capture x8

To Mic/Face board

Wowwee Kudo Motor Board v2
High Level Block Diagram

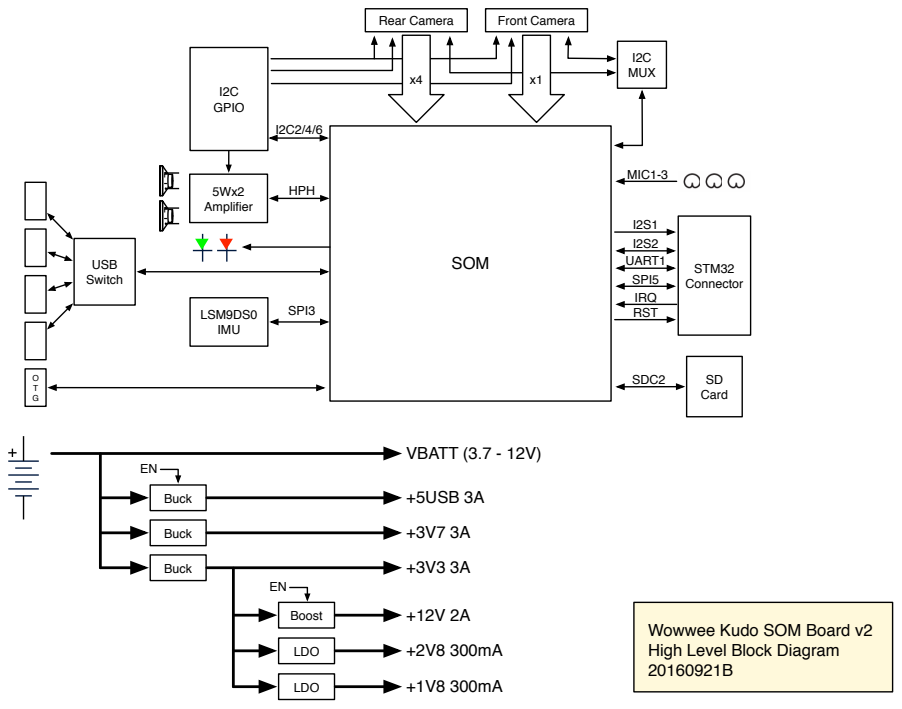
[picture p32: page 2]
Rear Camera; Front Camera; MUX x4; I2C GPIO; USB; SOM; Switch; LSM9DS0 IMU; SPI3; 5Wx2 Amplifier; HPH; I2S2 UART1 SPI5 IRQ RST; STM32 Connector; SD Card; SDC2; MIC1-3; VBATT (3.7 - 12V); Buck; +5USB 3A; Boost; LDO

Wowwee Kudo SOM Board v2
High Level Block Diagram

## VBUS

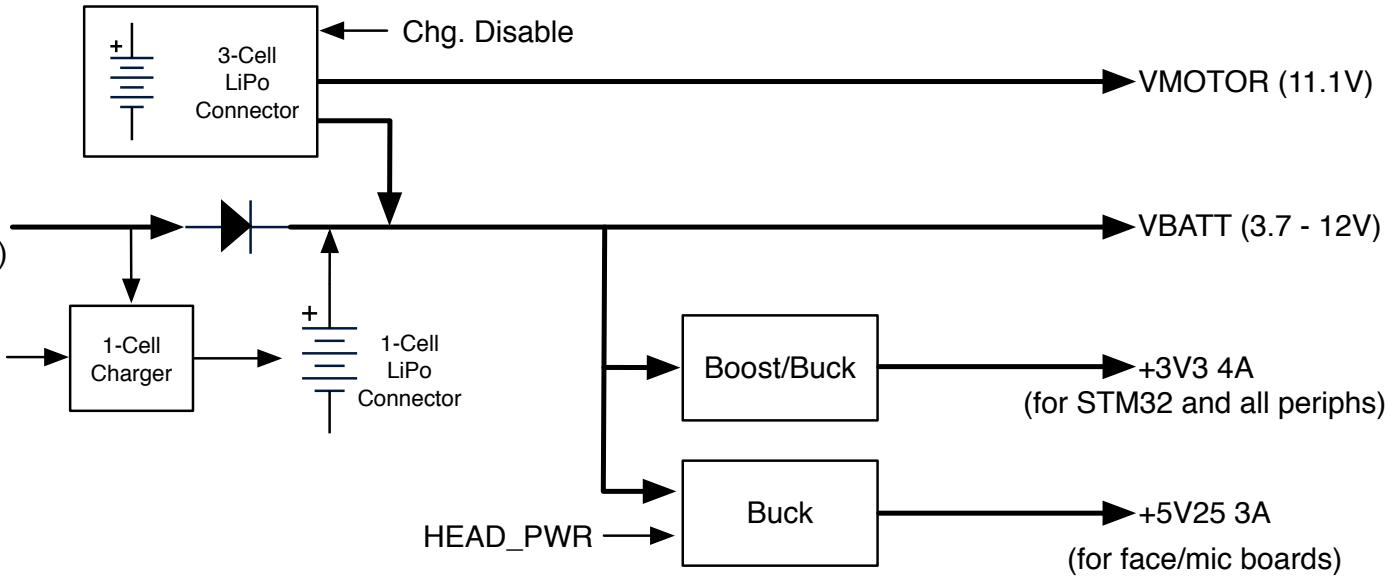
[picture p33: figure]
1-Cell LiPo Connector; 1-Cell Charger; VMOTOR (11.1V); VBATT (3.7 - 12V); Chg. Disable; Buck; Boost/Buck; (for face/mic boards); (for STM32 and all periphs); HEAD_PWR; 3-Cell LiPo Connector

## (from USB)

## Chg. Disable

## Wowwee Kudo Motor Board v2 Power Distribution

20160921A

## 1-cell is for future-proofing/development, not required for Kudo 3-cell is charged with external charge board
