bens-unit01/switchbot-complete-prj/documents/RevAir32_schem_RevA_20151026.pdf

# POWER SUPPLY

# INPUT STAGE

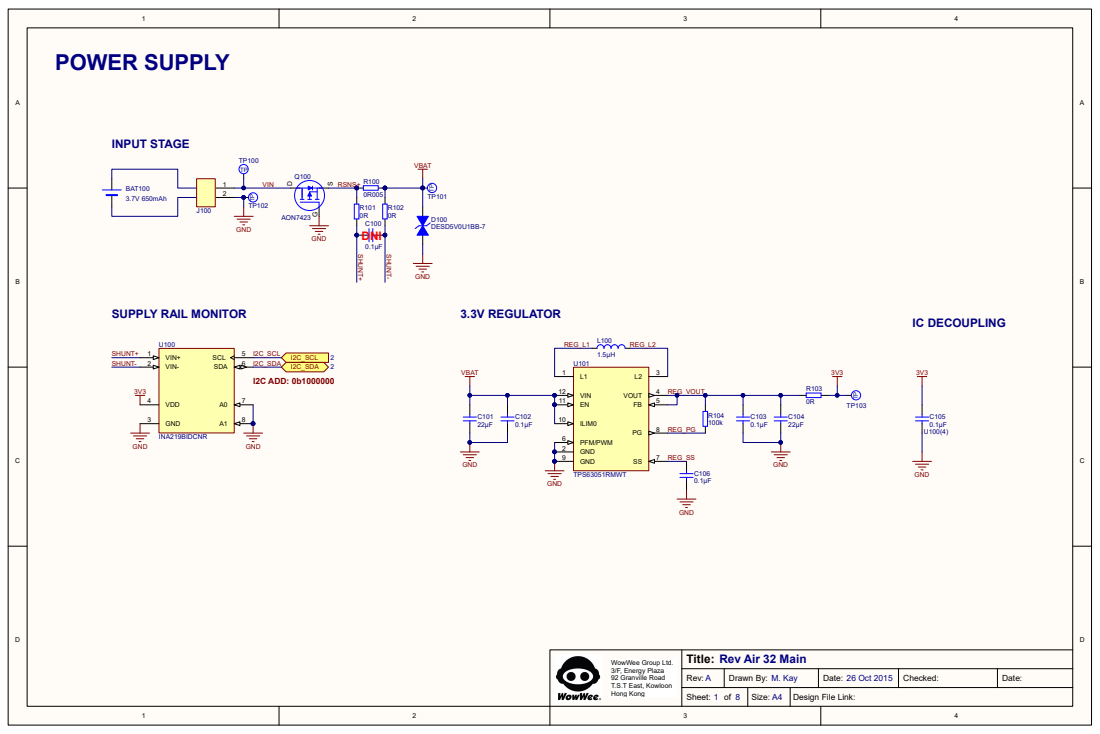
[picture p34: page 1]

# MCU

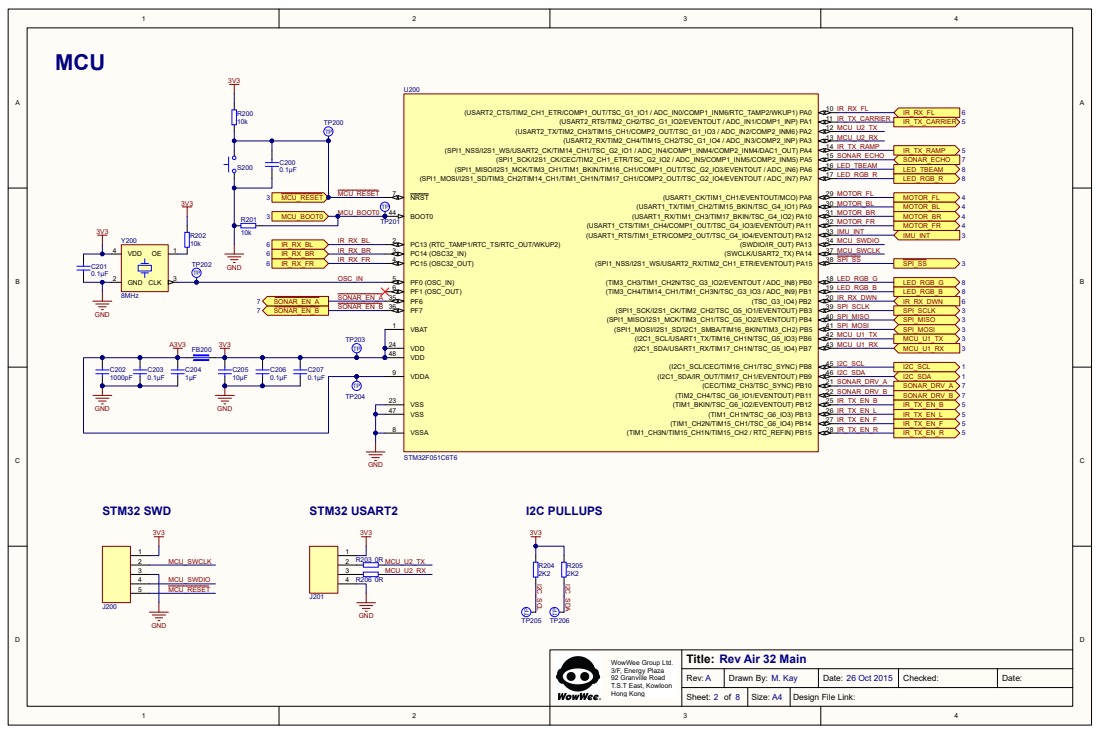
[picture p35: page 2]

BLUETOOTH | INERTIAL MEASUREMENT UNIT

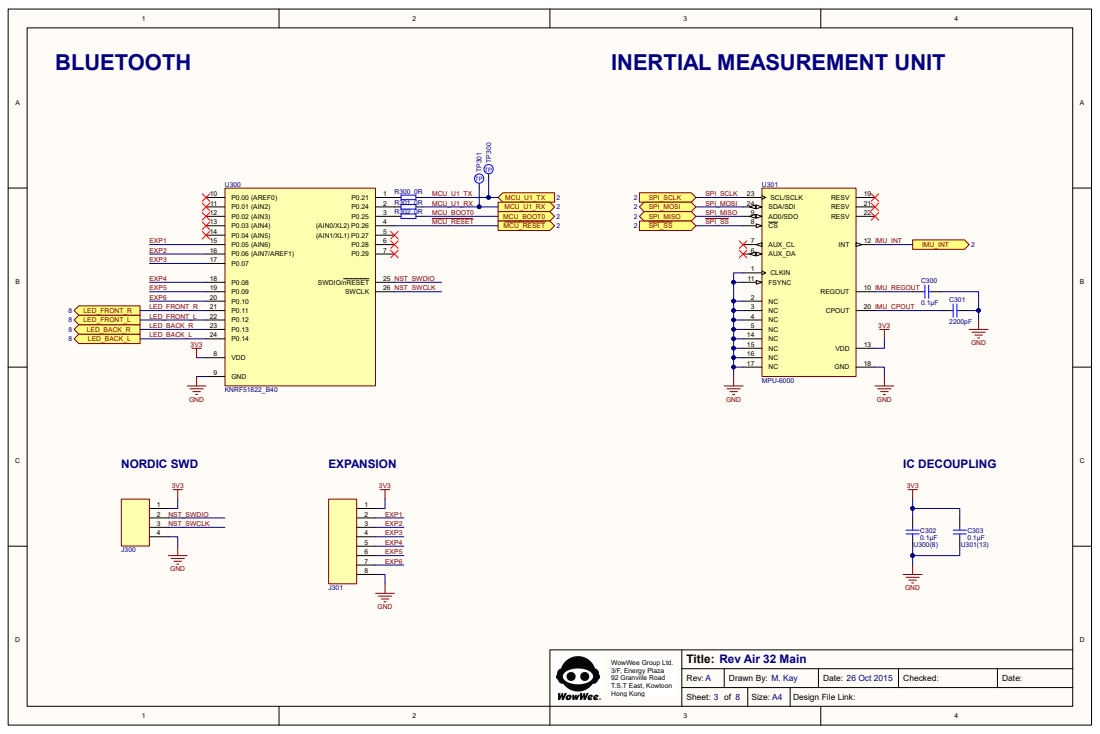
[picture p36: page 3]

# MOTORS

FRONT LEFT | FRONT RIGHT

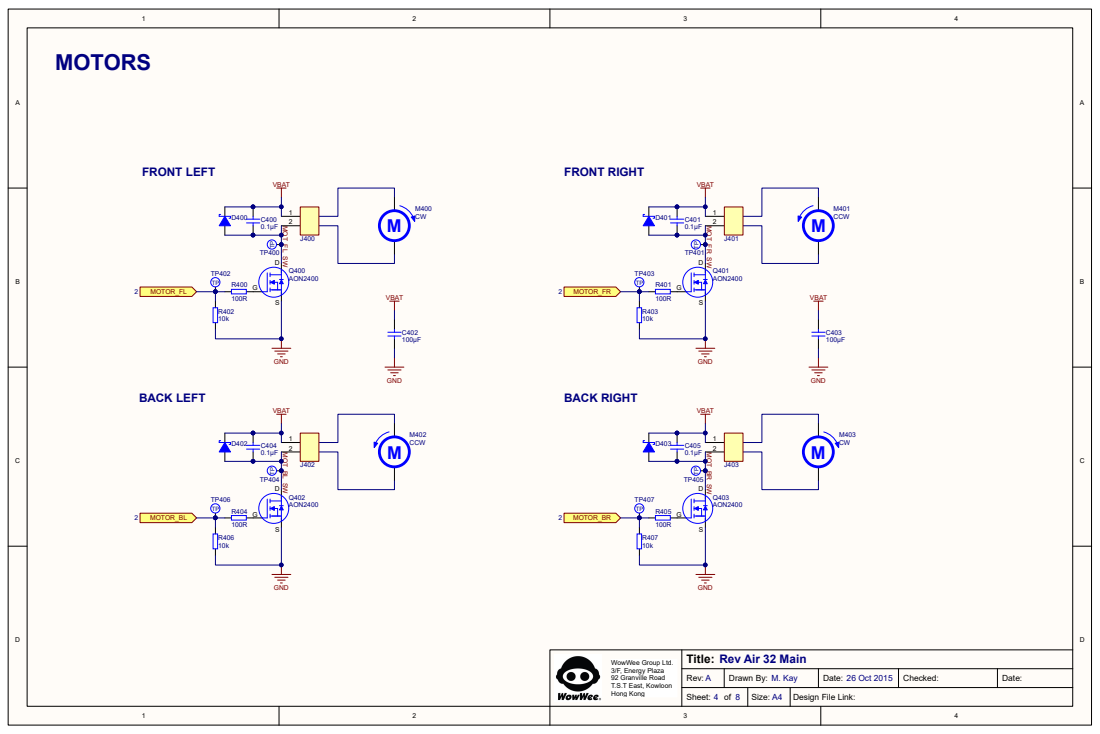
[picture p37: page 4]

# IR TRANSMIT

FRONT TX | LEFT TX

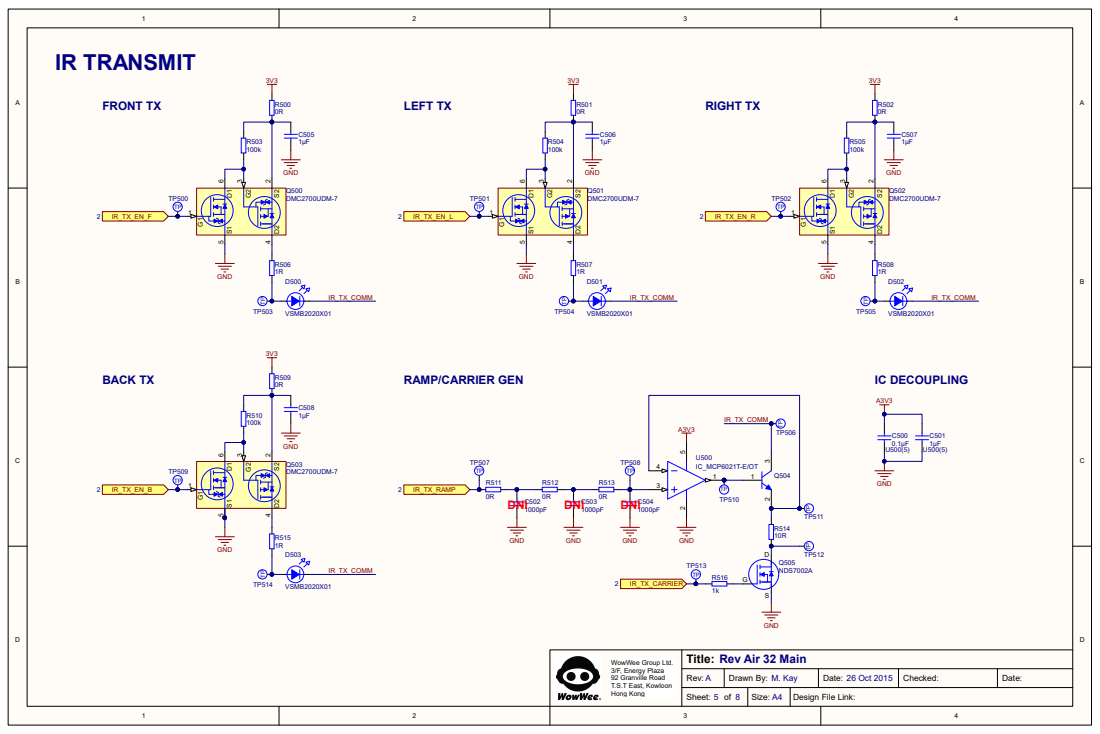
[picture p38: page 5]

# IR RECEIVE

FRONT LEFT | FRONT RIGHT

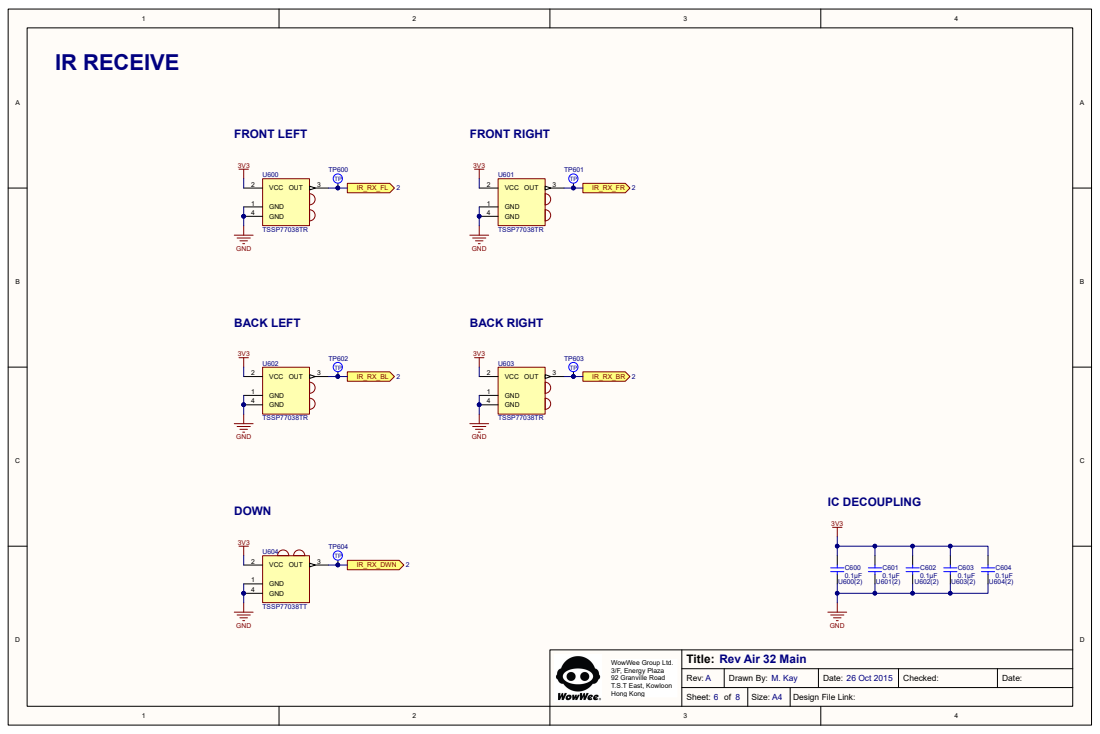
[picture p39: page 6]

# SONAR

# DRIVE STAGE

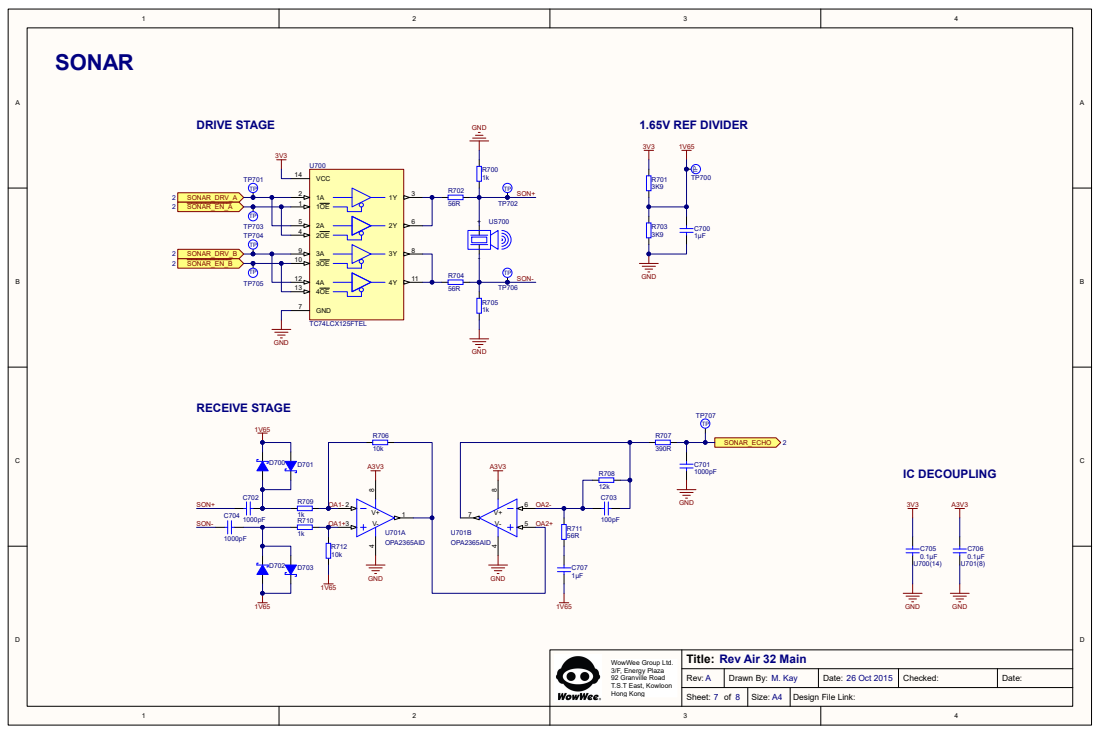
[picture p40: page 7]

# LEDS

# TOP RGB

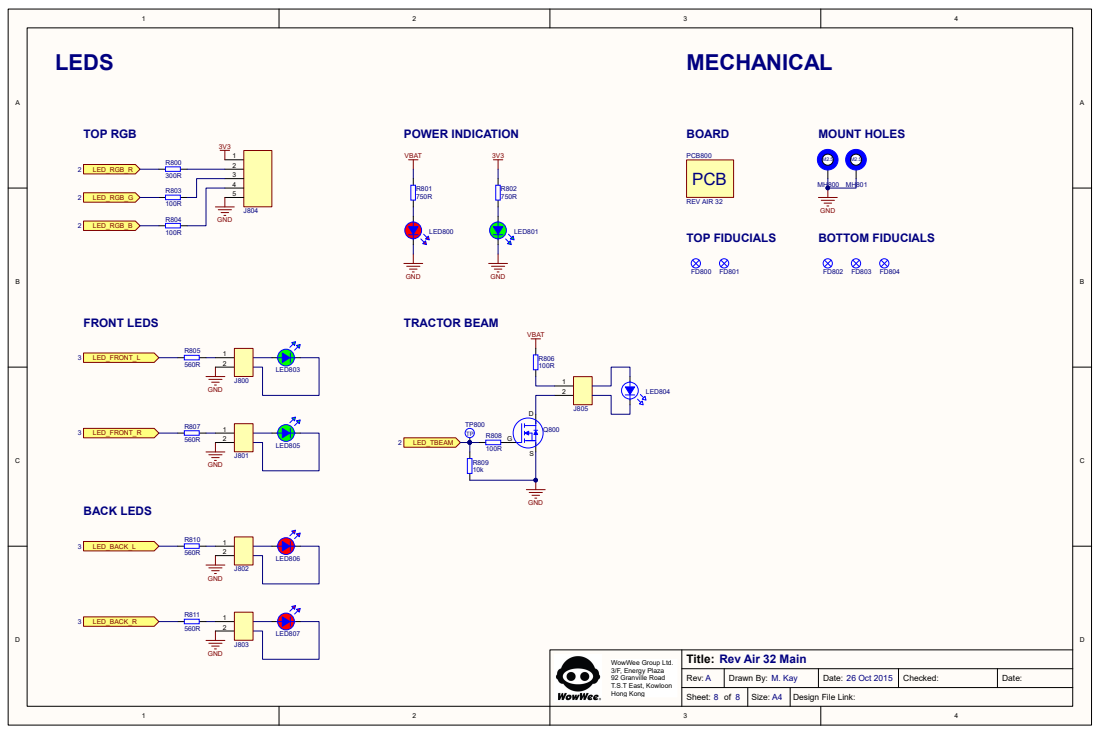
[picture p41: page 8]
