bens-unit01/switchbot-complete-prj/documents/Sch_main.pdf

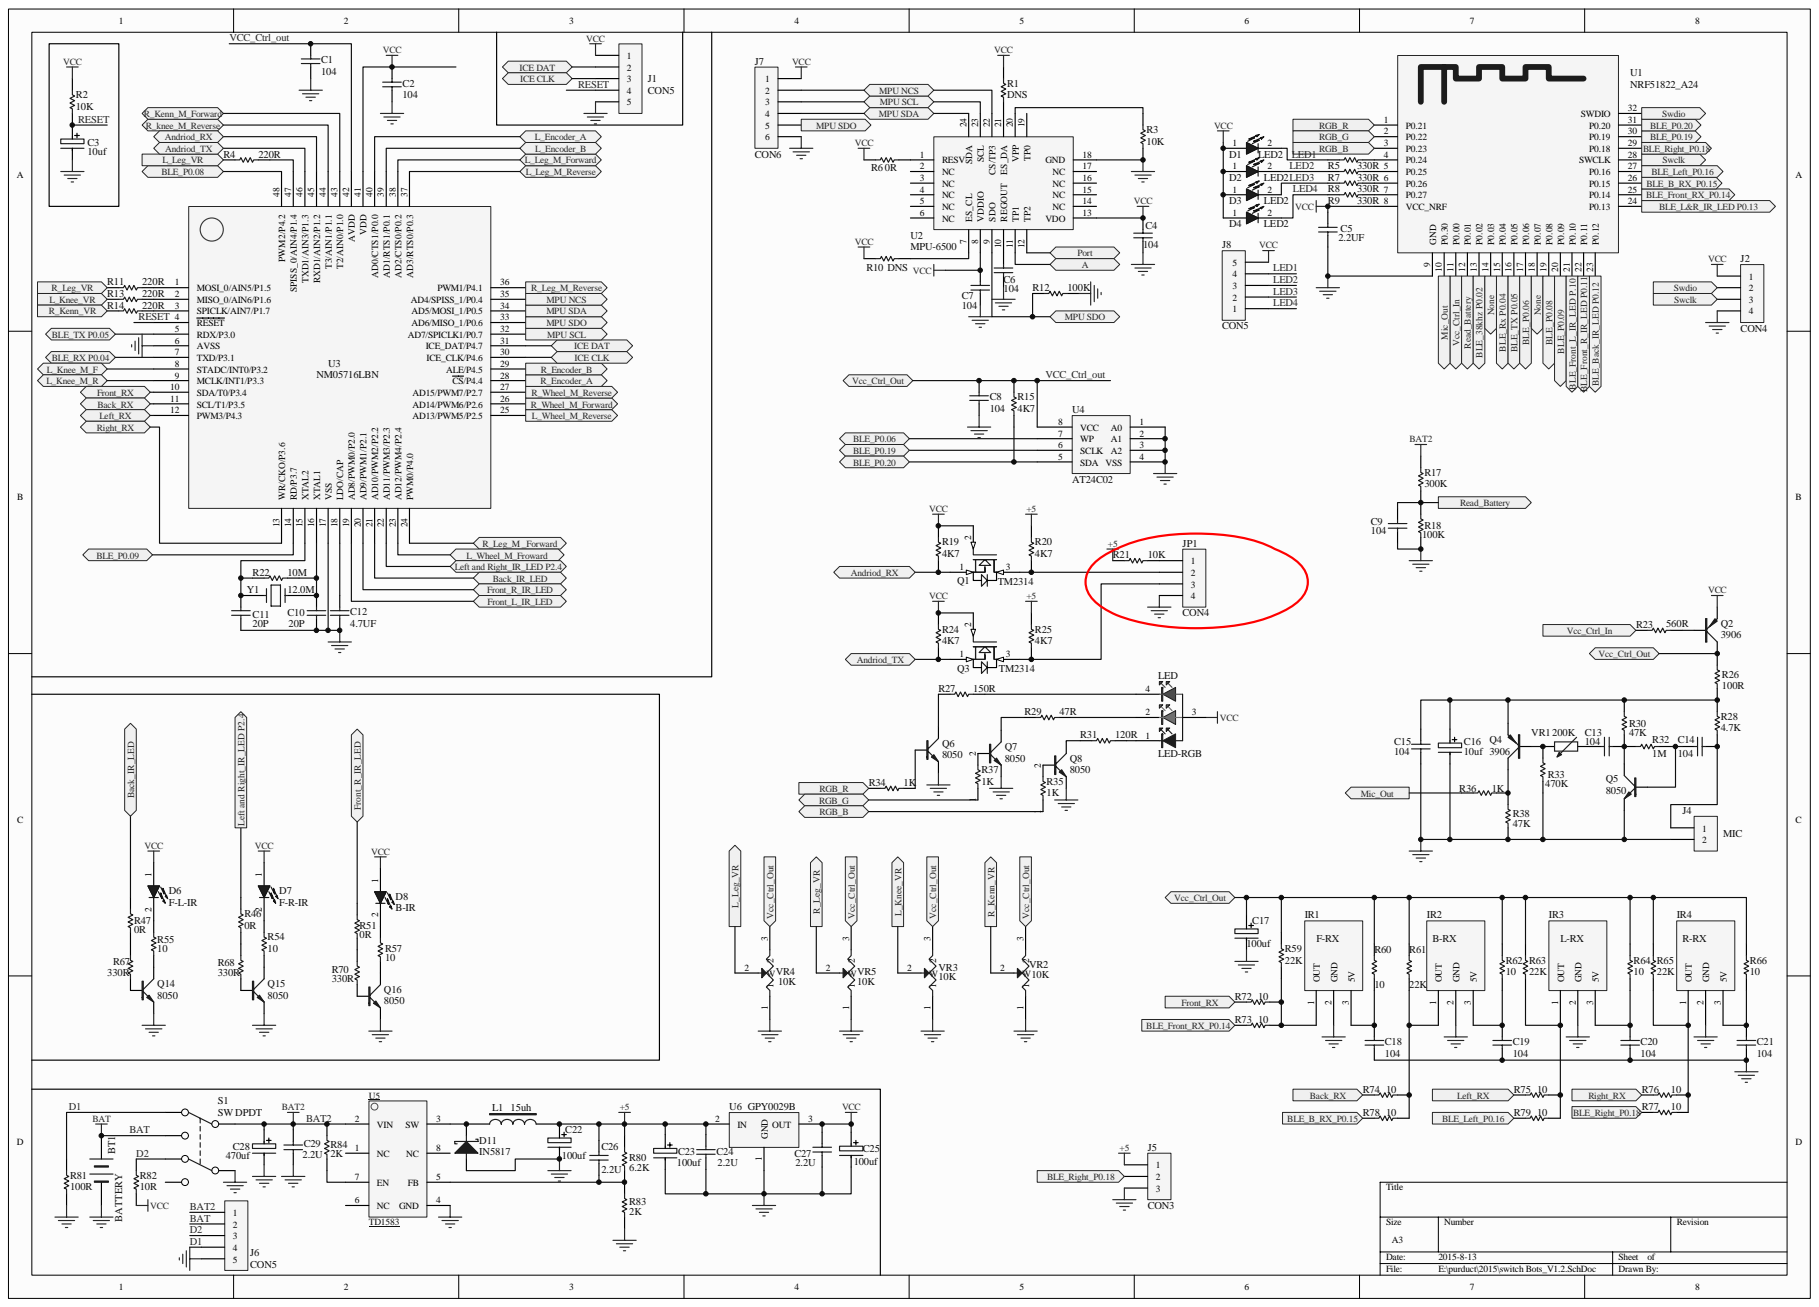
[picture p42: page 1]

TP2 12 VDO 13 NC 14 NC 15 NC 16 NC 17 GND 18 TP0 19 VPP 20 ES_DA 21 CS/TP3 22 SCL 23 SDA 24 U2 MPU-6500

Title

Size A3 | Number | | Revision

Date: 2015-8-13 | | Sheet of
File: E:\purduct\2015\switch Bots_V1.2.SchDoc | | Drawn By:

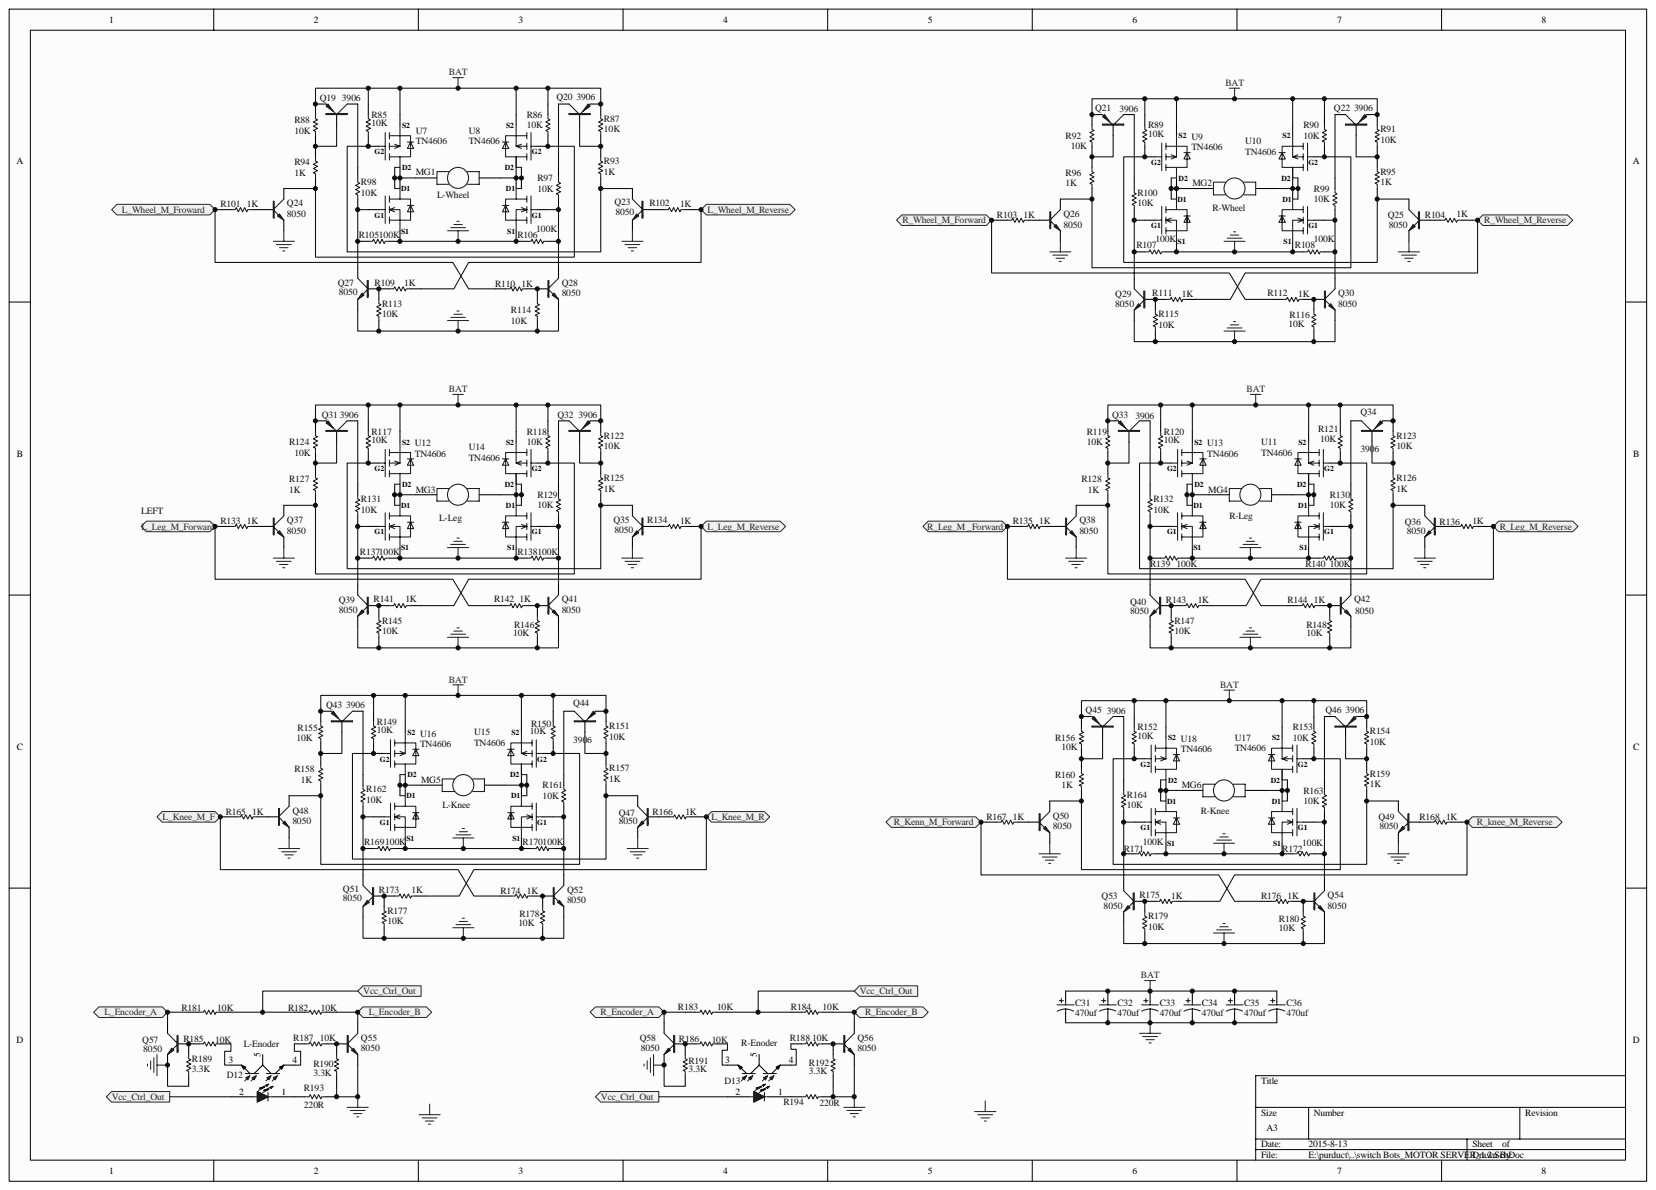
[picture p43: page 2]

Title

Size A3 | Number | | Revision

Date: 2015-8-13 | | Sheet of
File: E:\purduct\..\switch Bots_MOTOR SERVER_1.2.SchDoc Drawn By:
