bens-unit01/switchbot-complete-prj/documents/Switch_Bot_5_07_2015-01.pdf

The Left&Right is robot's L&R.

NM05716

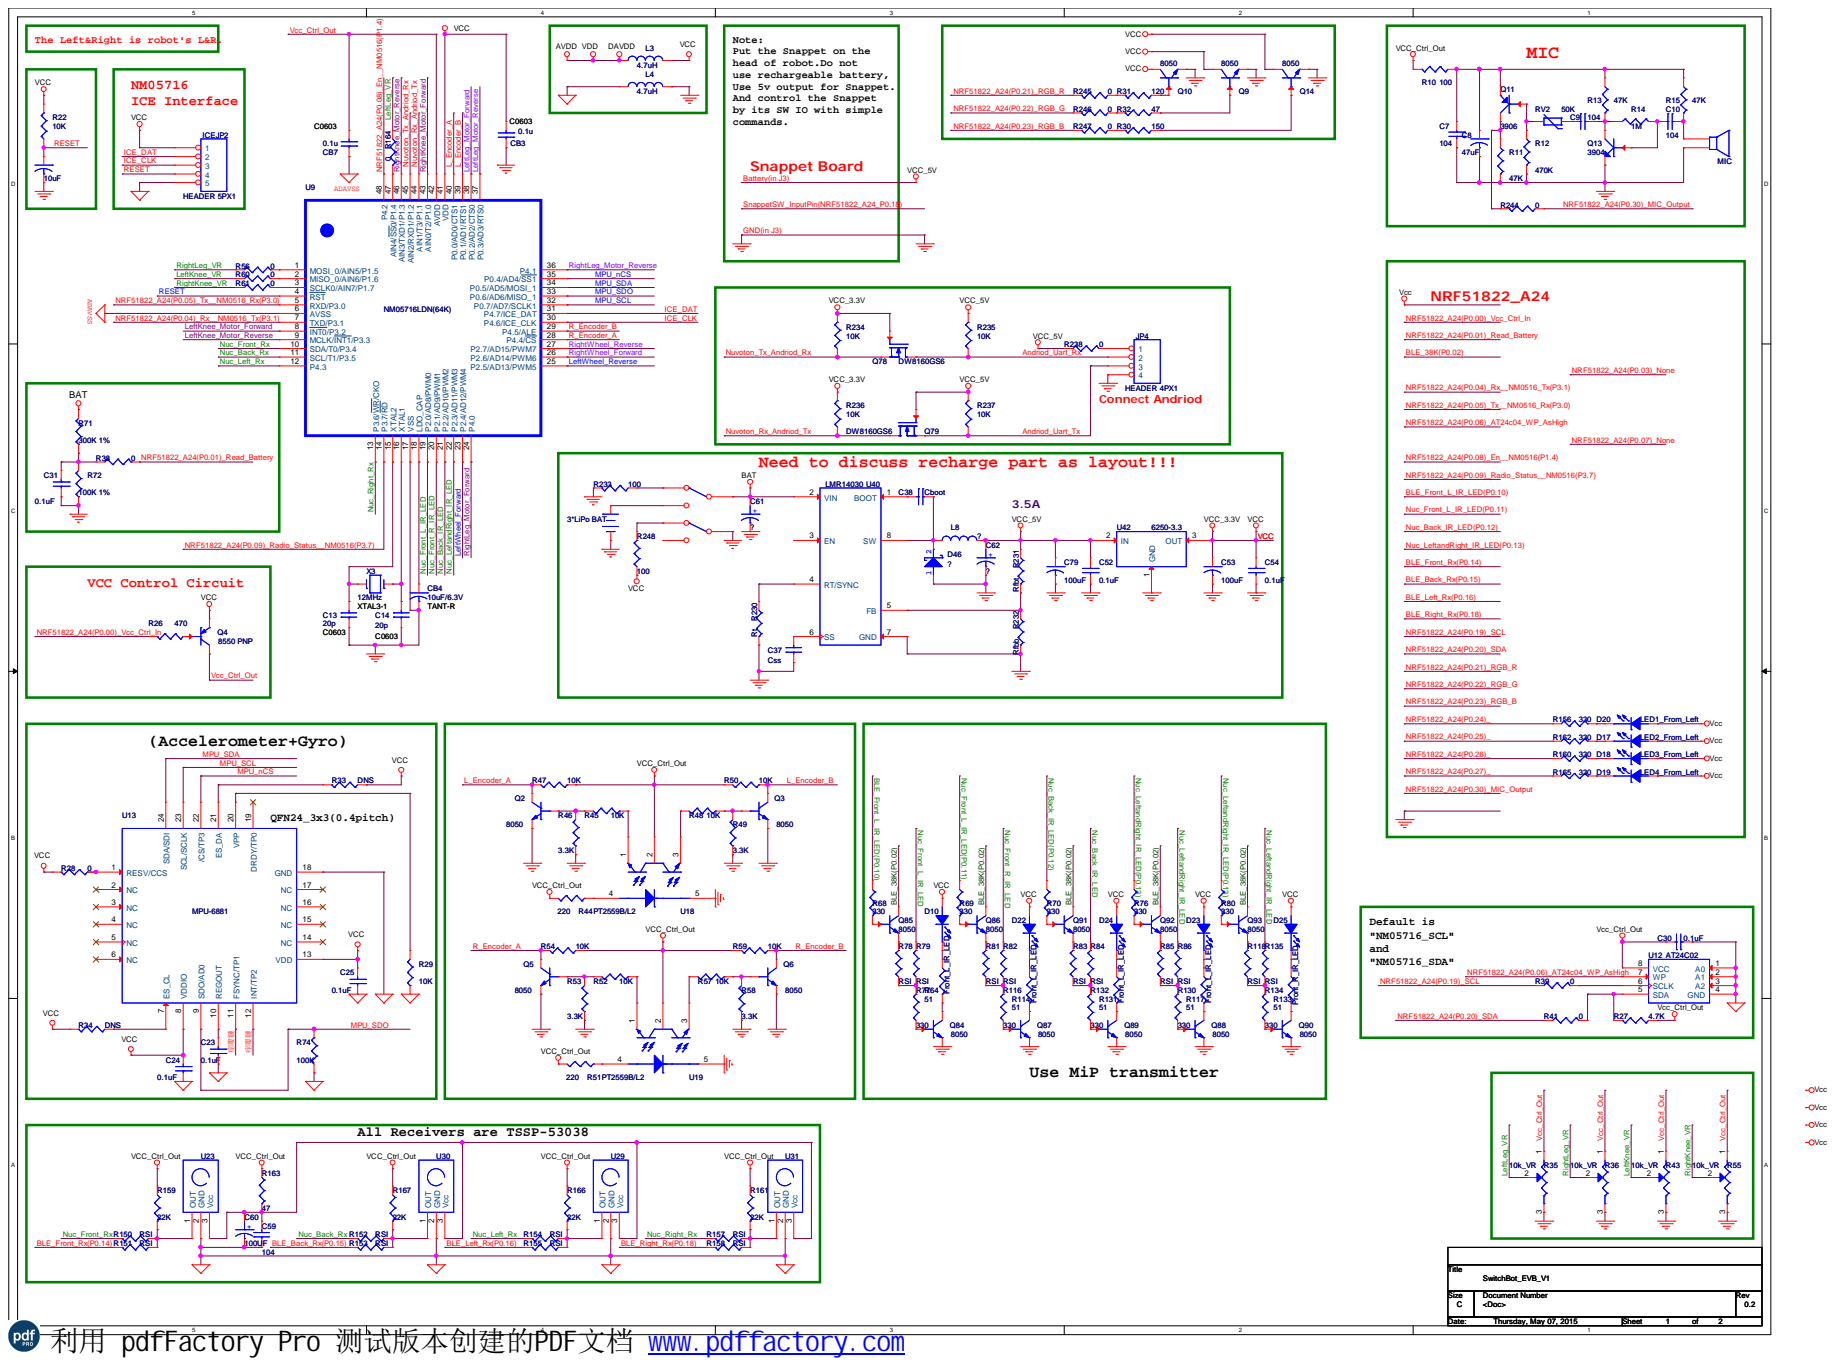
[picture p44: page 1]

Note:
Put the Snappet on the
head of robot.Do not
use rechargeable battery,
Use 5v output for Snappet.
And control the Snappet

by its SW IO with simple
commands.

Nuvoton_Rx_Andriod_Tx
Need to discuss recharge part as layout!!!

All Receivers are TSSP-53038

利用 pdfFactory Pro 测试版本创建的PDF文档 www.pdffactory.com

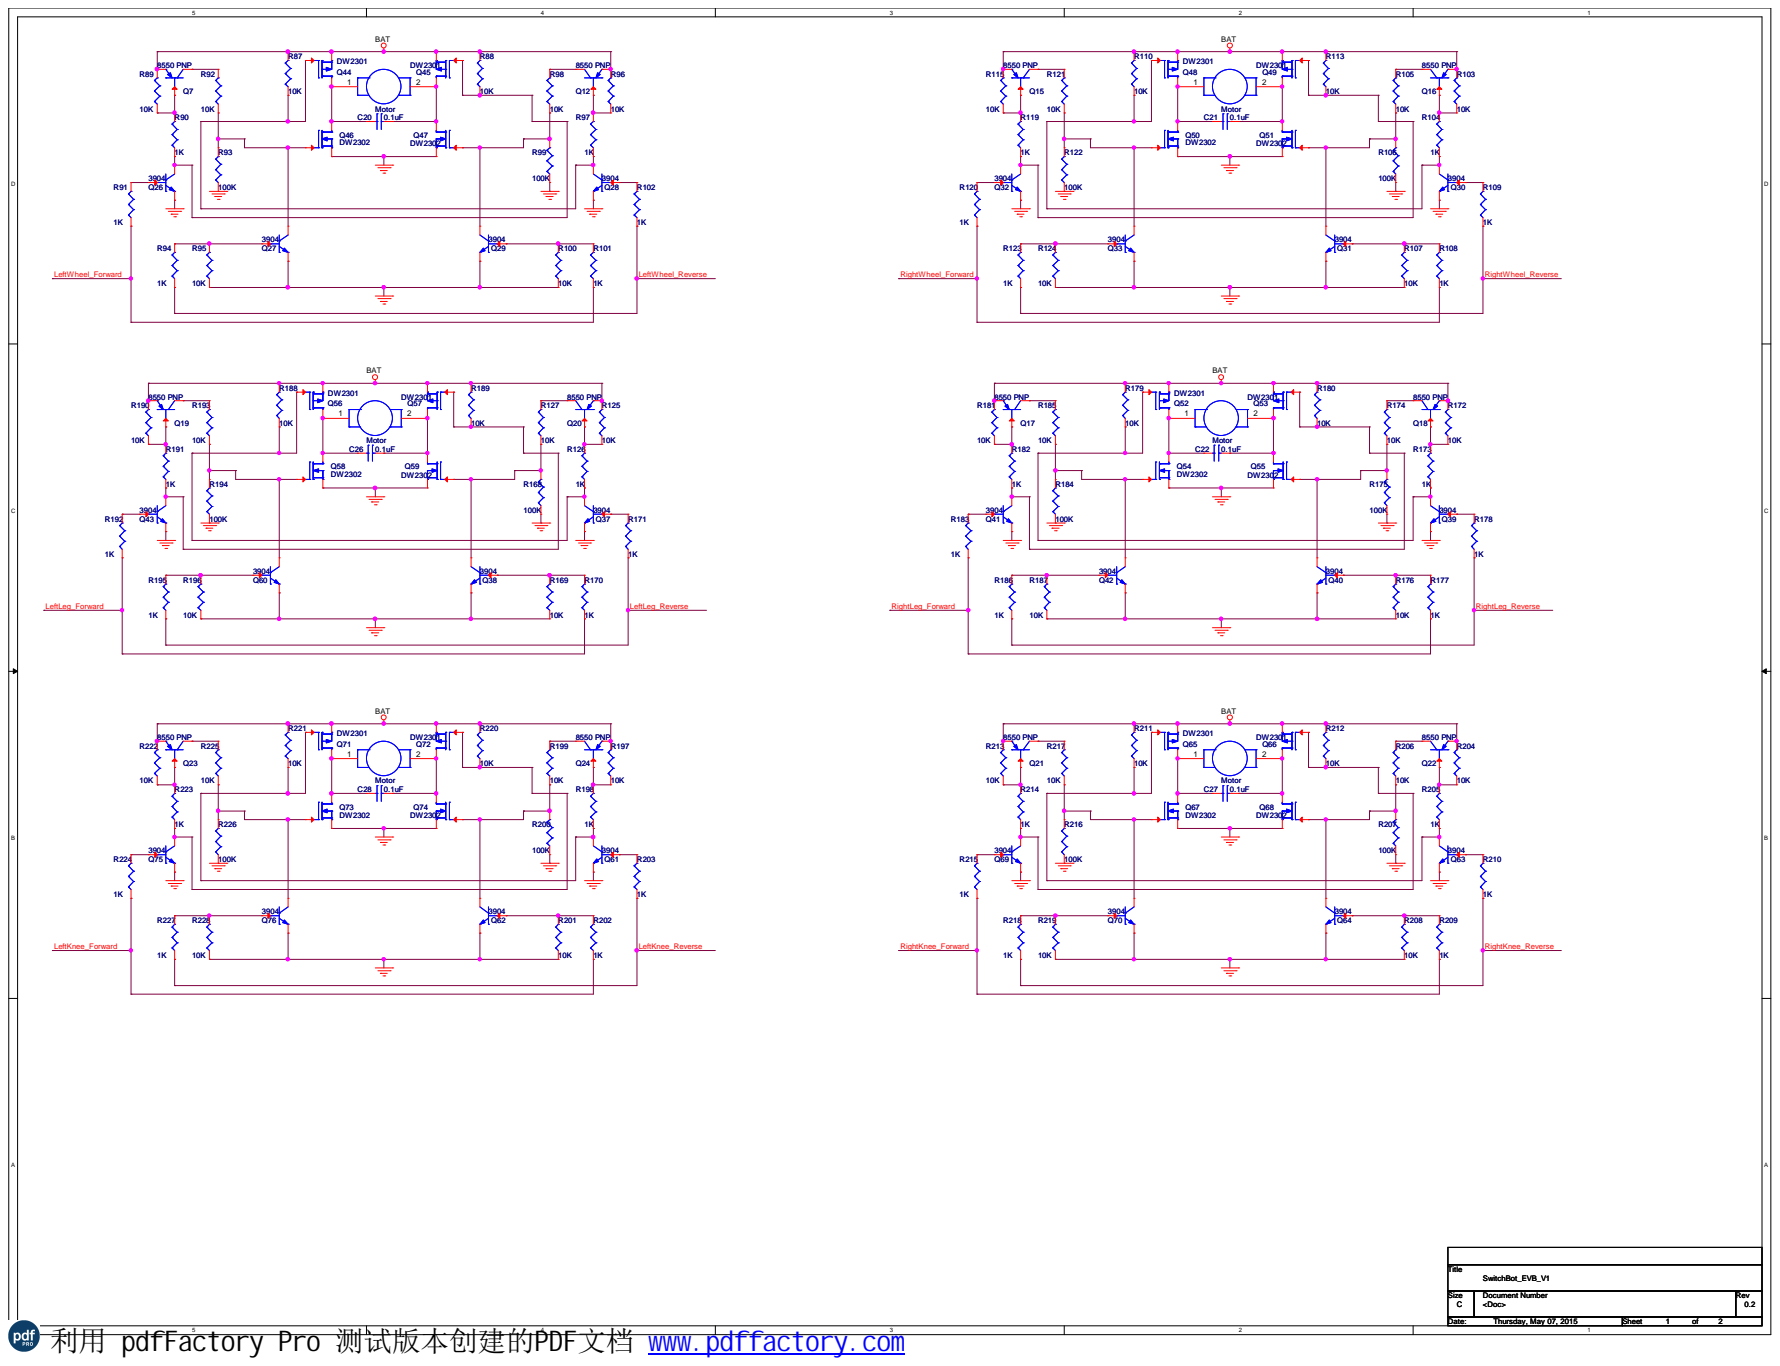
[picture p45: page 2]

利用 pdfFactory Pro 测试版本创建的PDF文档 www.pdffactory.com
