bens-unit01/switchbot-complete-prj/documents/wow06-10611bf-20151118a.pdf

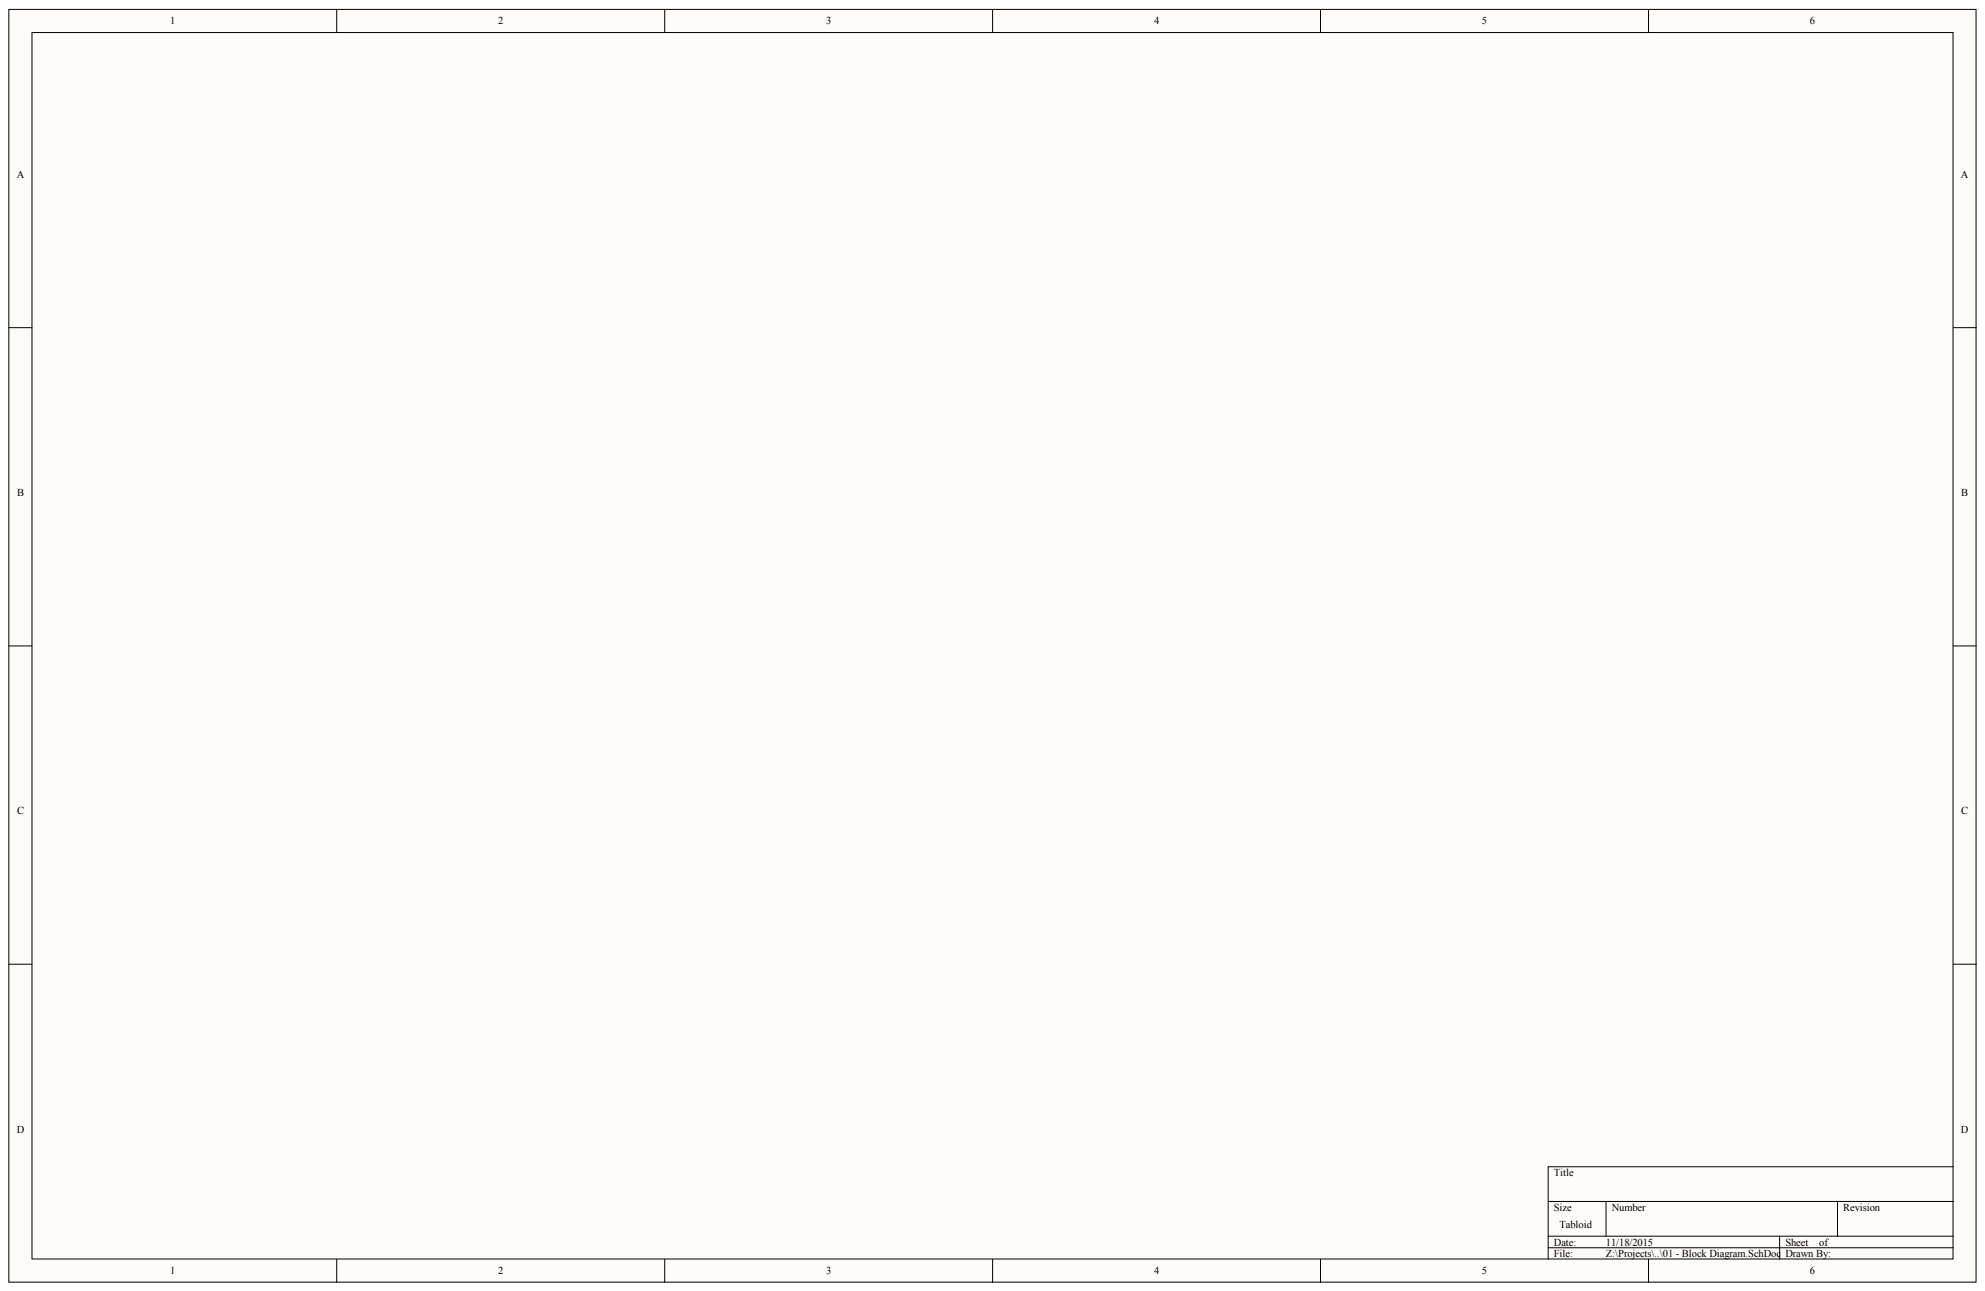
[picture p48: page 1]

Size Tabloid | Number | Revision

Date: 11/18/2015 | Sheet of
File: Z:\Projects\..\01 - Block Diagram.SchDoc | Drawn By:

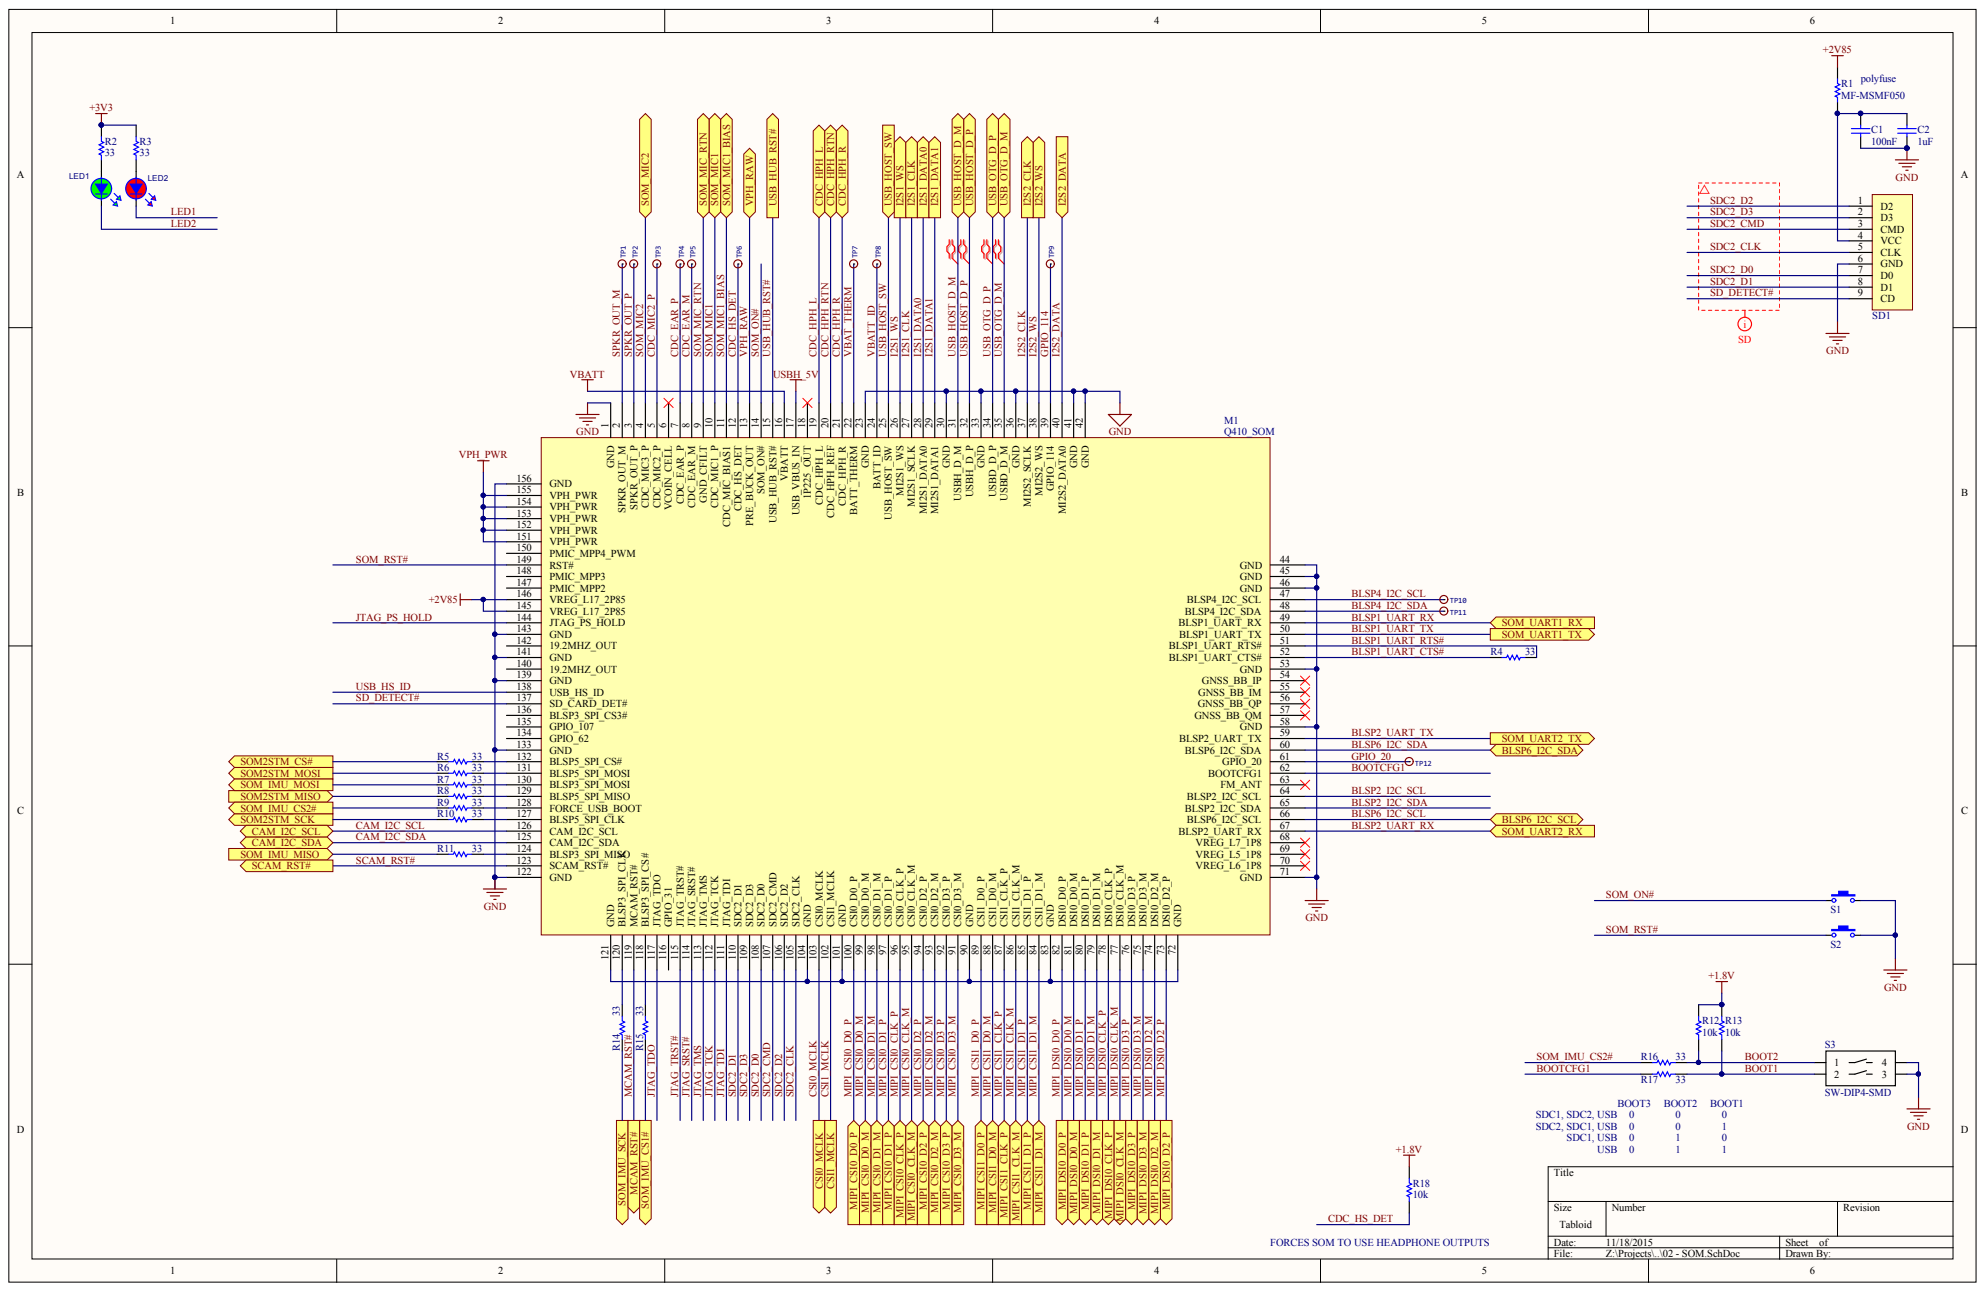
[picture p49: page 2]

BLSP1_UART_CTS# R4 33

BLSP2_UART_TX BLSP6_I2C_SDA

GND 72 DSI0_D2_P 73 DSI0_D2_M 74 DSI0_D3_M 75 DSI0_D3_P 76 DSI0_CLK_M 77 DSI0_CLK_P 78 DSI0_D1_M 79 DSI0_D1_P 80 DSI0_D0_M 81 DSI0_D0_P 82 GND 83 CSI1_D1_M 84 CSI1_D1_P 85 CSI1_CLK_M 86 CSI1_CLK_P 87 CSI1_D0_M 88 CSI1_D0_P 89 GND 90 CSI0_D3_M 91 CSI0_D3_P 92 CSI0_D2_M 93 CSI0_D2_P 94 CSI0_CLK_M 95 CSI0_CLK_P 96 CSI0_D1_P 97 CSI0_D1_M 98 CSI0_D0_M 99 CSI0_D0_P 100 GND 101 CSI1_MCLK 102 CSI0_MCLK 103 GND 104 SDC2_CLK 105 SDC2_D2 106 SDC2_CMD 107 SDC2_D0 108 SDC2_D3 109 SDC2_D1 110 JTAG_TDI 111 JTAG_TCK 112 JTAG_TMS 113 JTAG_SRST# 114 JTAG_TRST# 115 GPIO_31 116 JTAG_TDO 117 BLSP3_SPI_CS# 118 MCAM_RST# 119 BLSP3_SPI_CLK 120 GND 121

Size Tabloid | Number | Revision

FORCES SOM TO USE HEADPHONE OUTPUTS

Date: 11/18/2015 | Sheet of
File: Z:\Projects\..\02 - SOM.SchDoc | Drawn By:

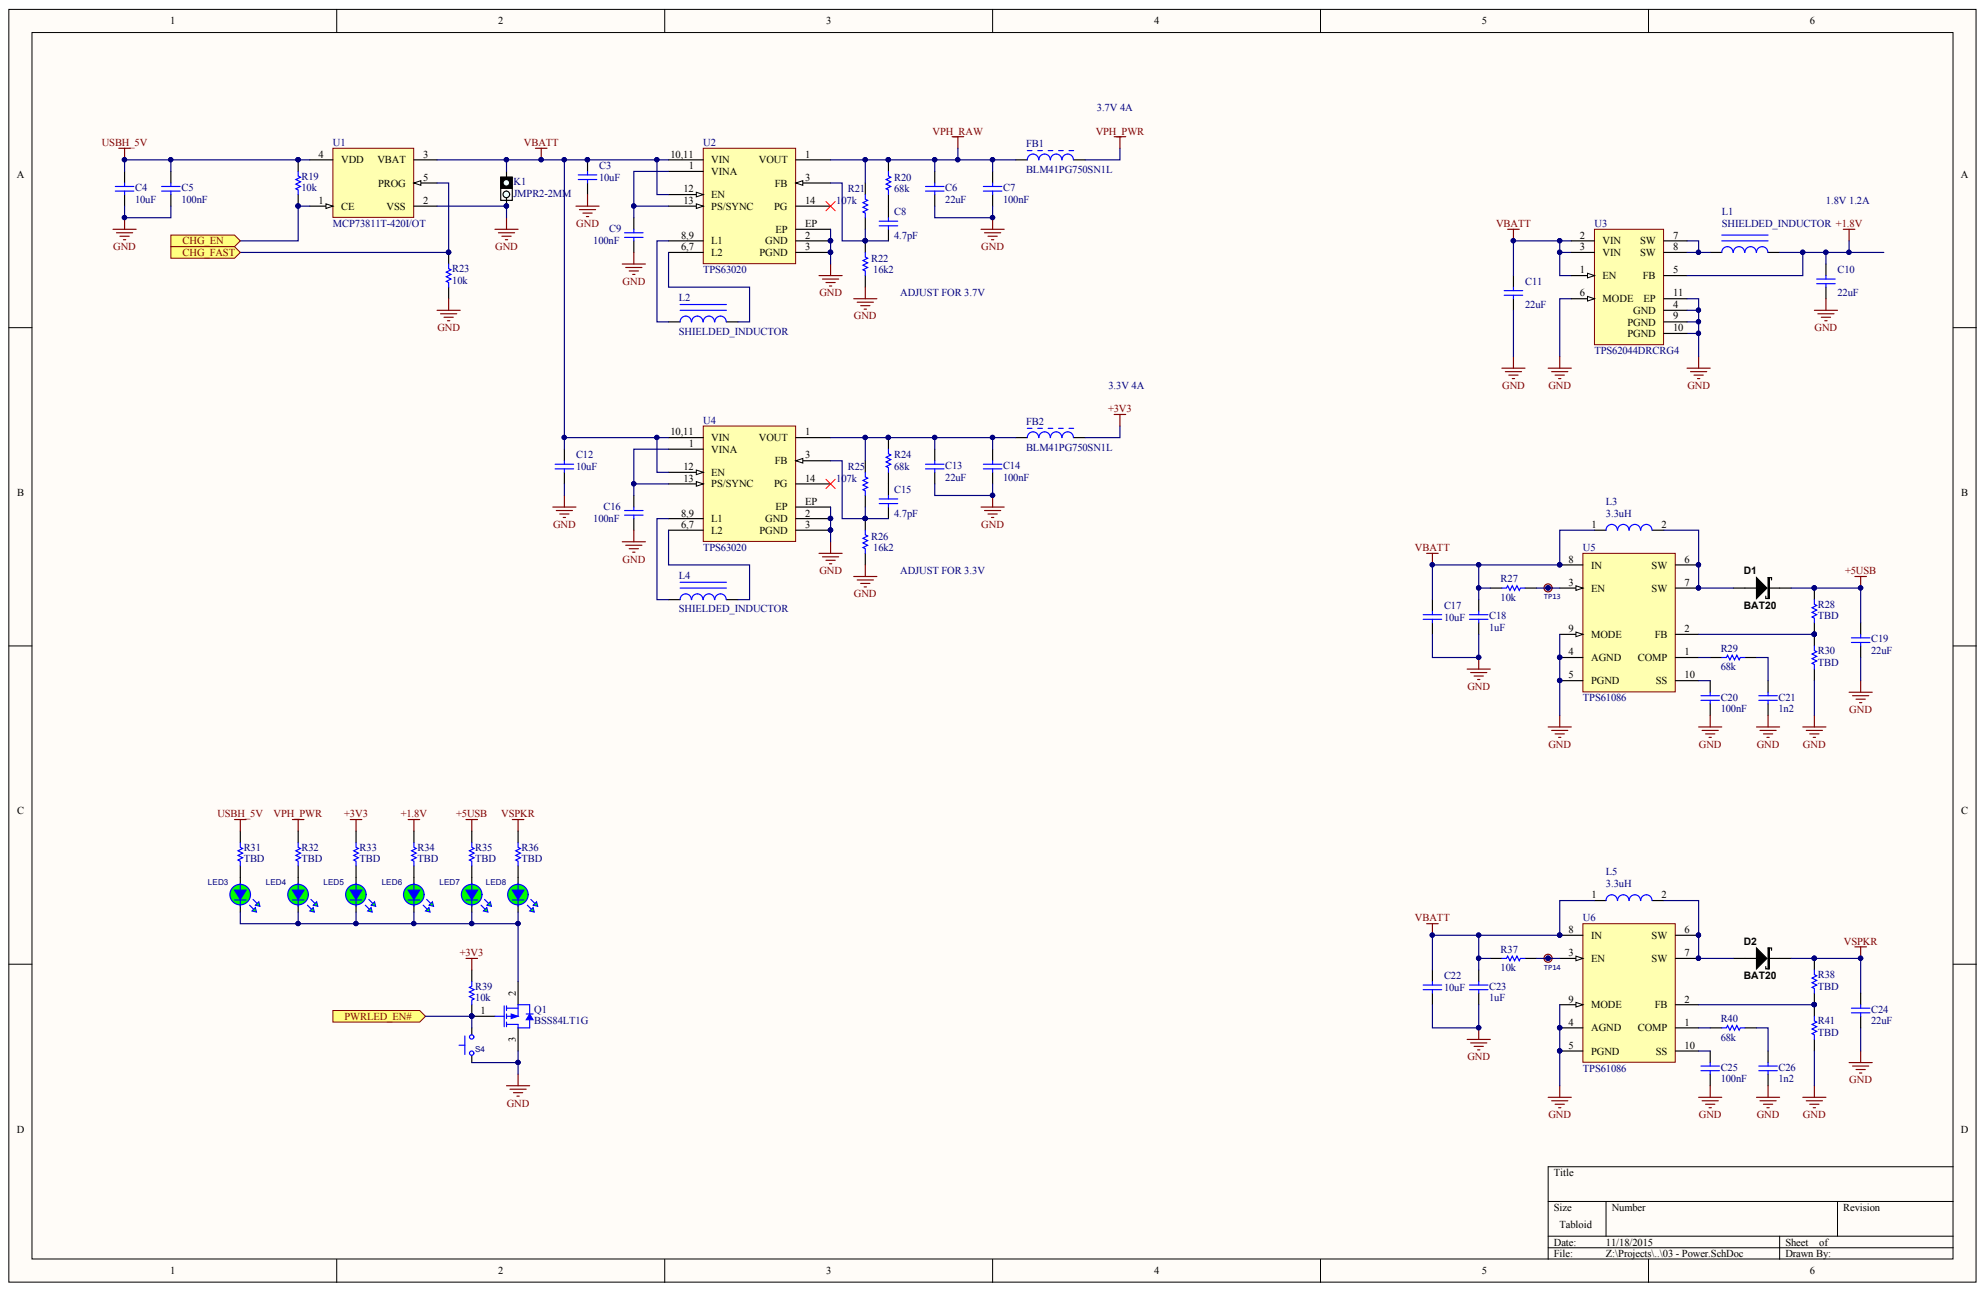
[picture p50: page 3]

1 0

T abloid | e r | Re visio n

Date : 1 1/1 8/2 0 1 5 | S h e et o f
File : Z:\P r oje cts\..\0 3 - P owe r.S c hDo c | Dr awn By :

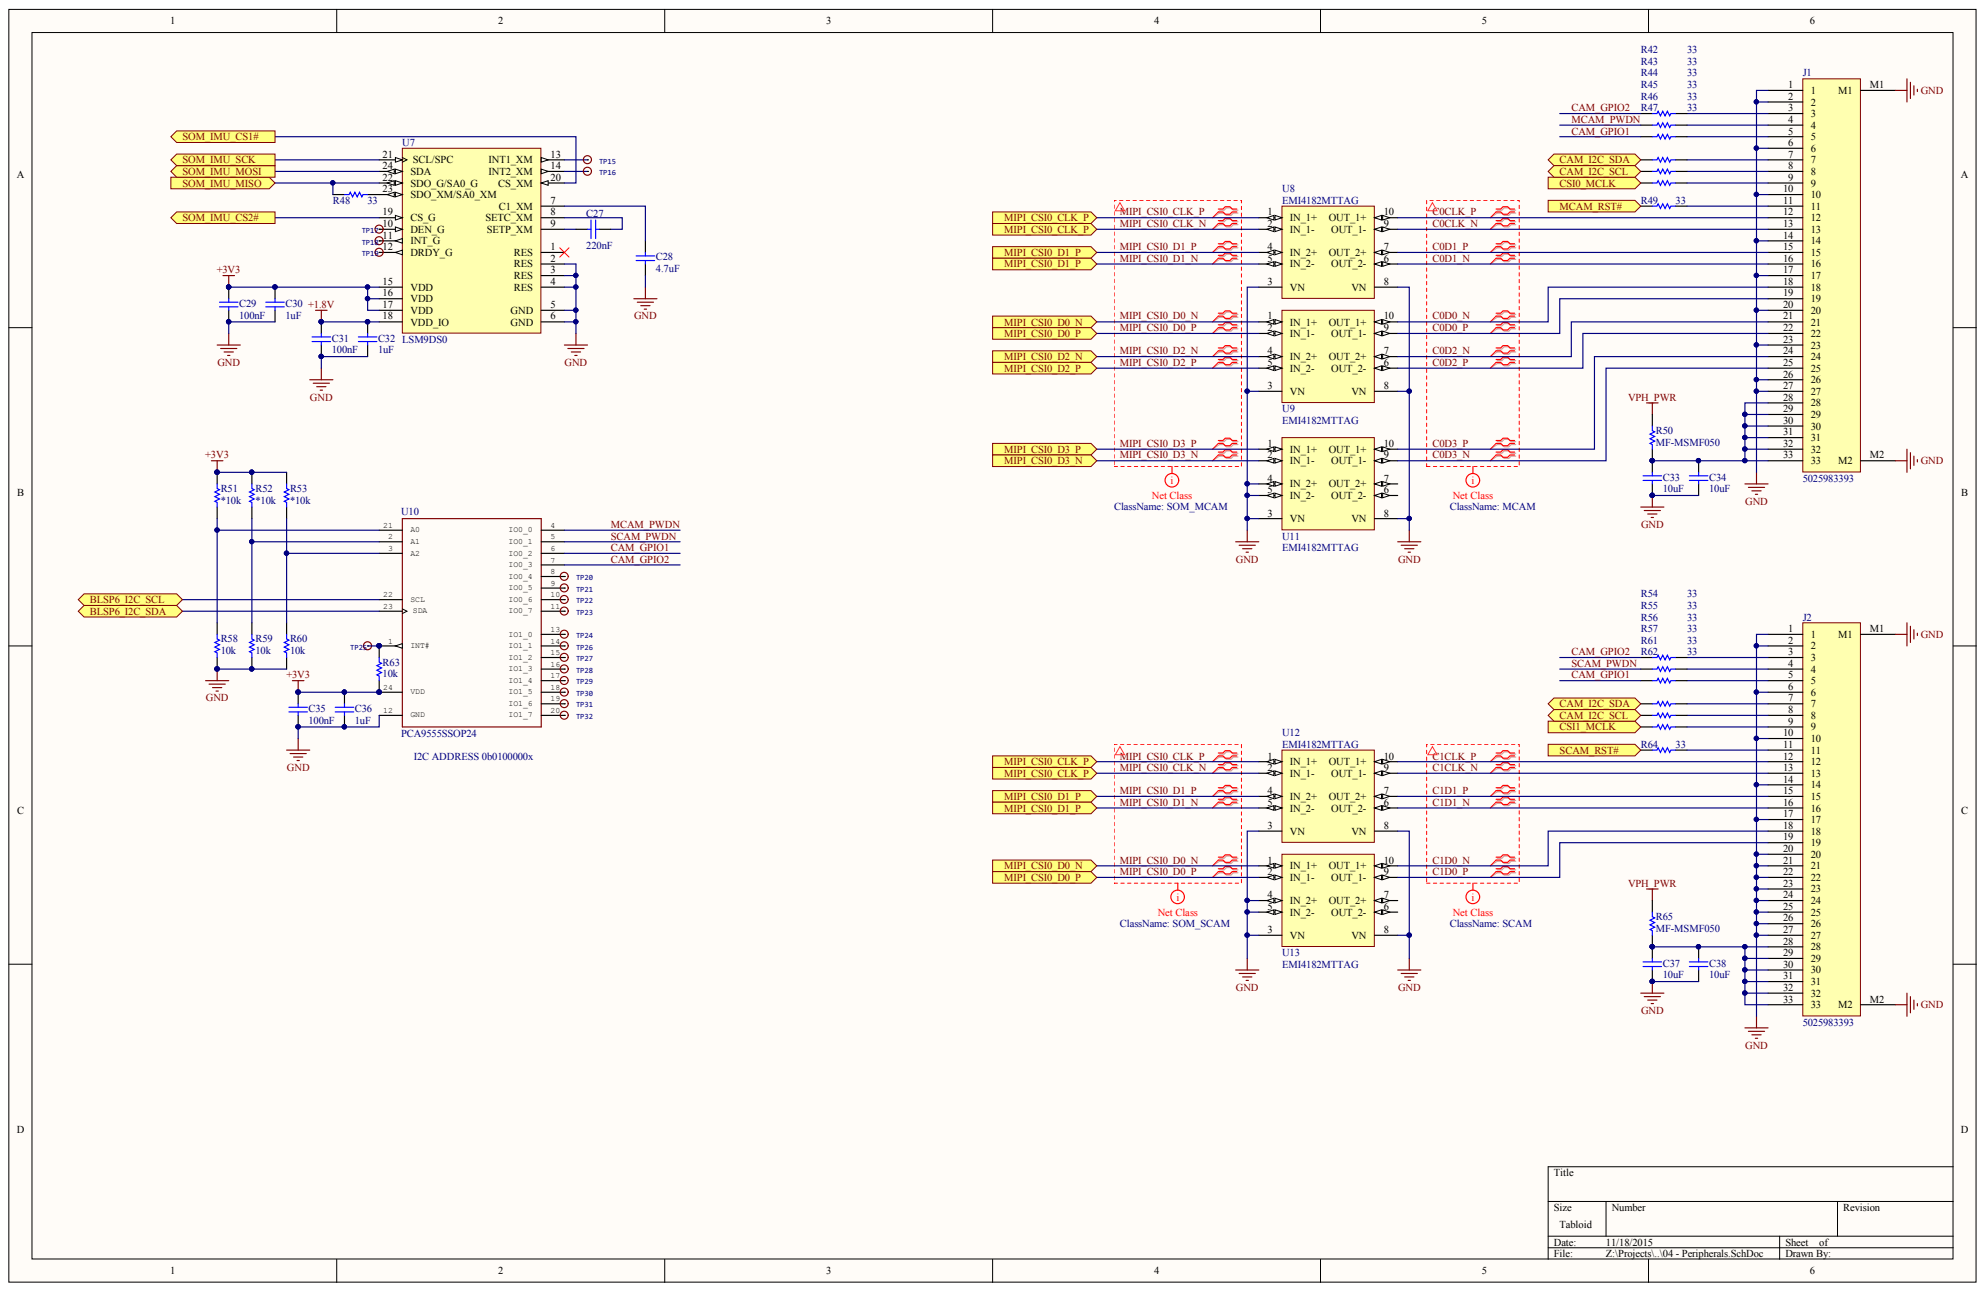
[picture p51: page 4]

2 3 | U7 LSM9DS SDO_G/SA0 _ G CS _XM SDO_XM/SA0 _XM C1 _XM CS _ G S E TC_XM S E T P _XM INT _ G DRDY_ G RE S RE S RE S VDD RE S VDD VDD GND VDD_ I O GND | 9 DEN_G

2 4 | | 1 4
2 2 | | 2 0

6 OUT_2+ 7 | C0D2 _N | | 2 3

8 | C0D3 _P | VPH_PWR | 2 6

2 7
2 8

3 0
3 1

6 OUT_2+ 7

C1CLK_N | 1 3

6 OUT_2+ 7 | C1D1 _P | 1 4

6 OUT_2+ 7 | | VPH_PWR R6 5 MF -MSMF 0 5 0 | 2 3

2 9
3 2
3 3

T abloid | e r | Re visio n

Date : 1 1/1 8/2 0 1 5 | S h e et o f
File : Z:\P r oje cts\..\0 4 - P e rip h e r als.S c hDo c | Dr awn By :

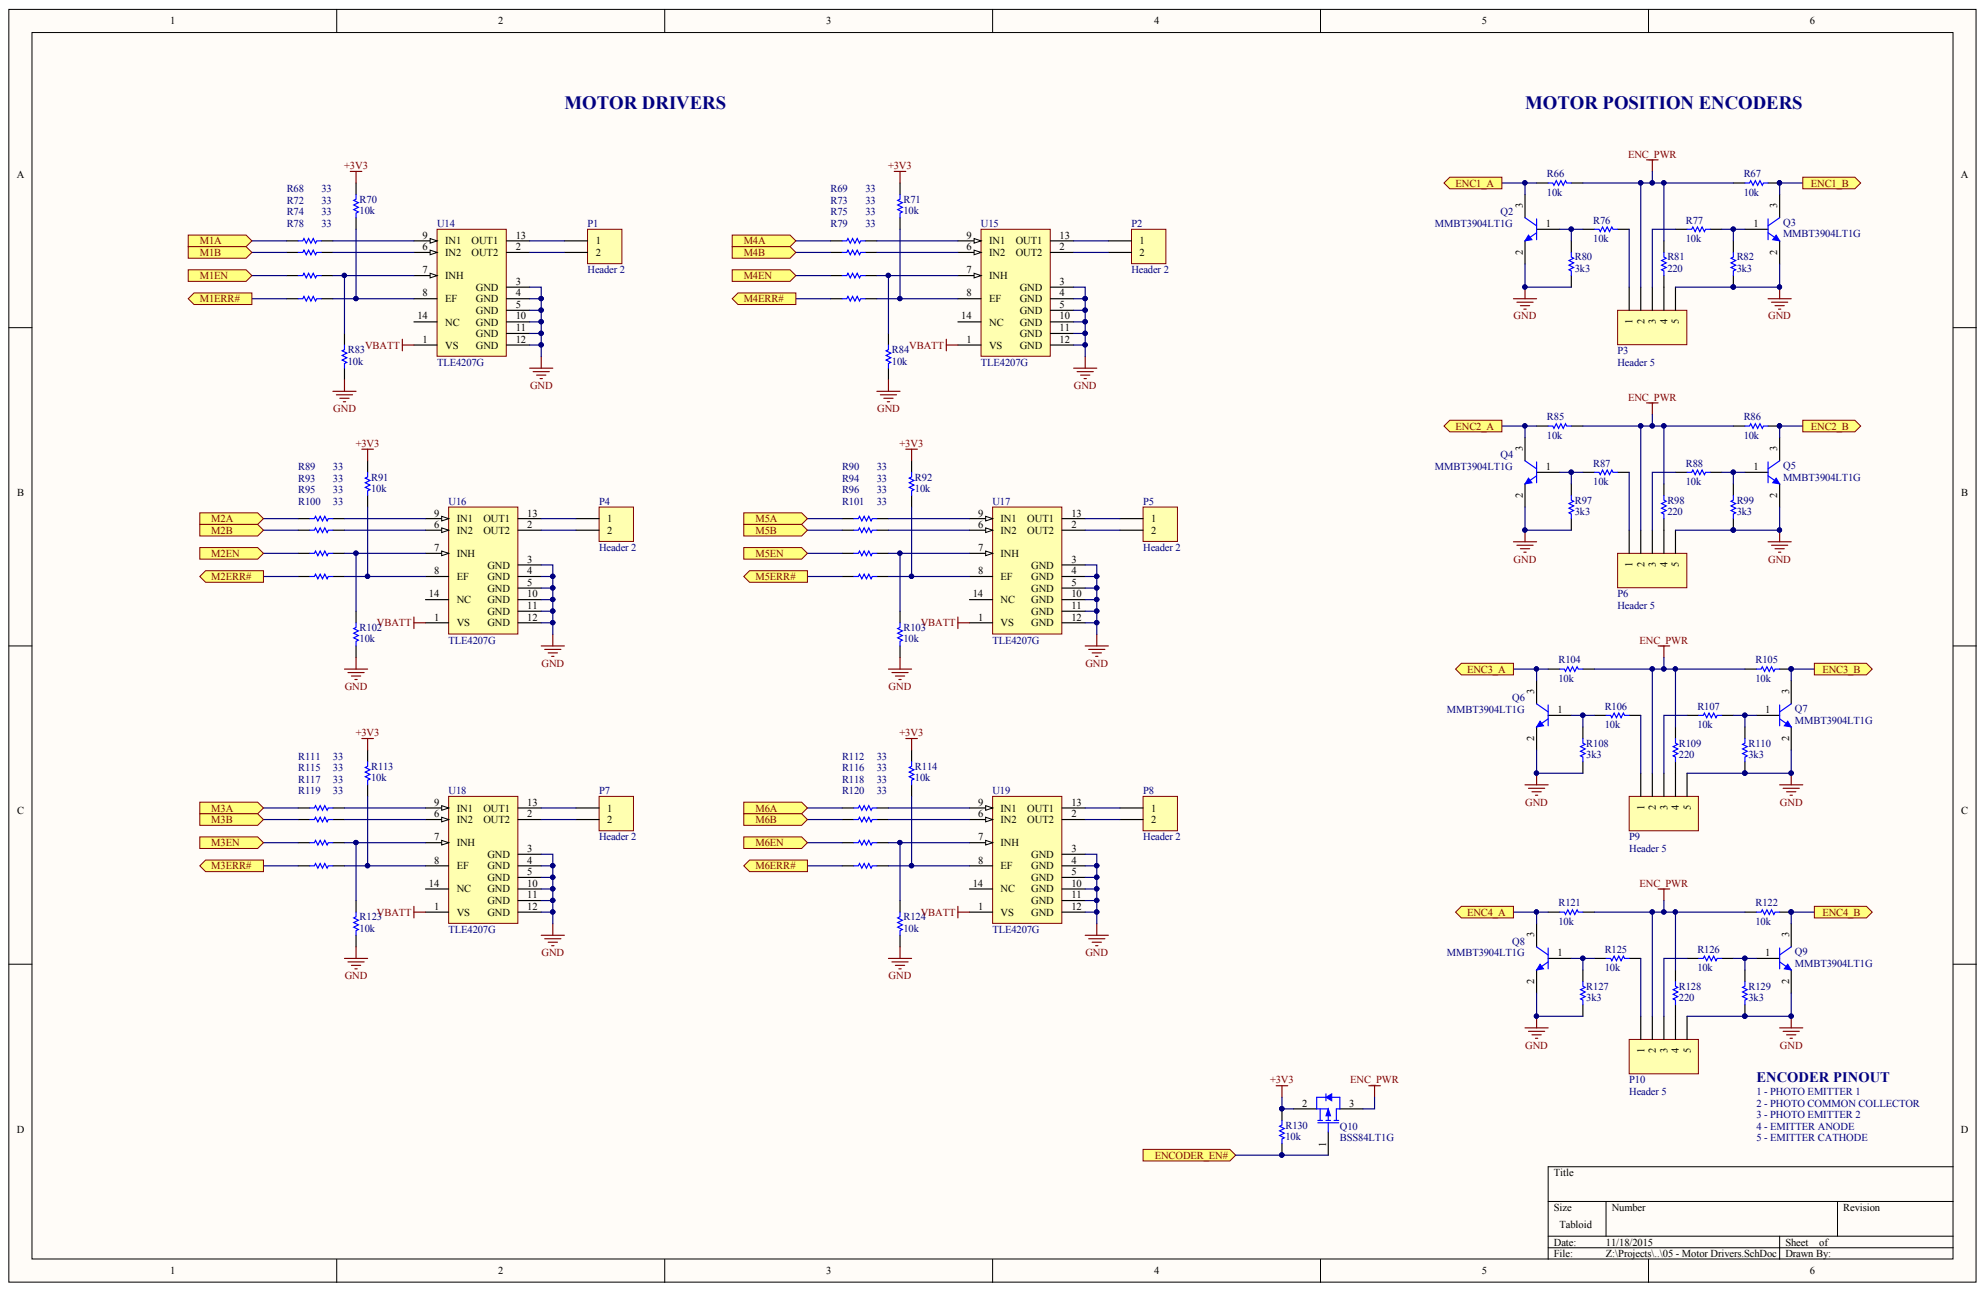
[picture p52: page 5]

INH 7

ENCODER PINOUT 1 - PHOTO EMITTER 1

Size Tabloid | Number | Revision

Date: 11/18/2015 | Sheet of
File: Z:\Projects\..\05 - Motor Drivers.SchDoc | Drawn By:

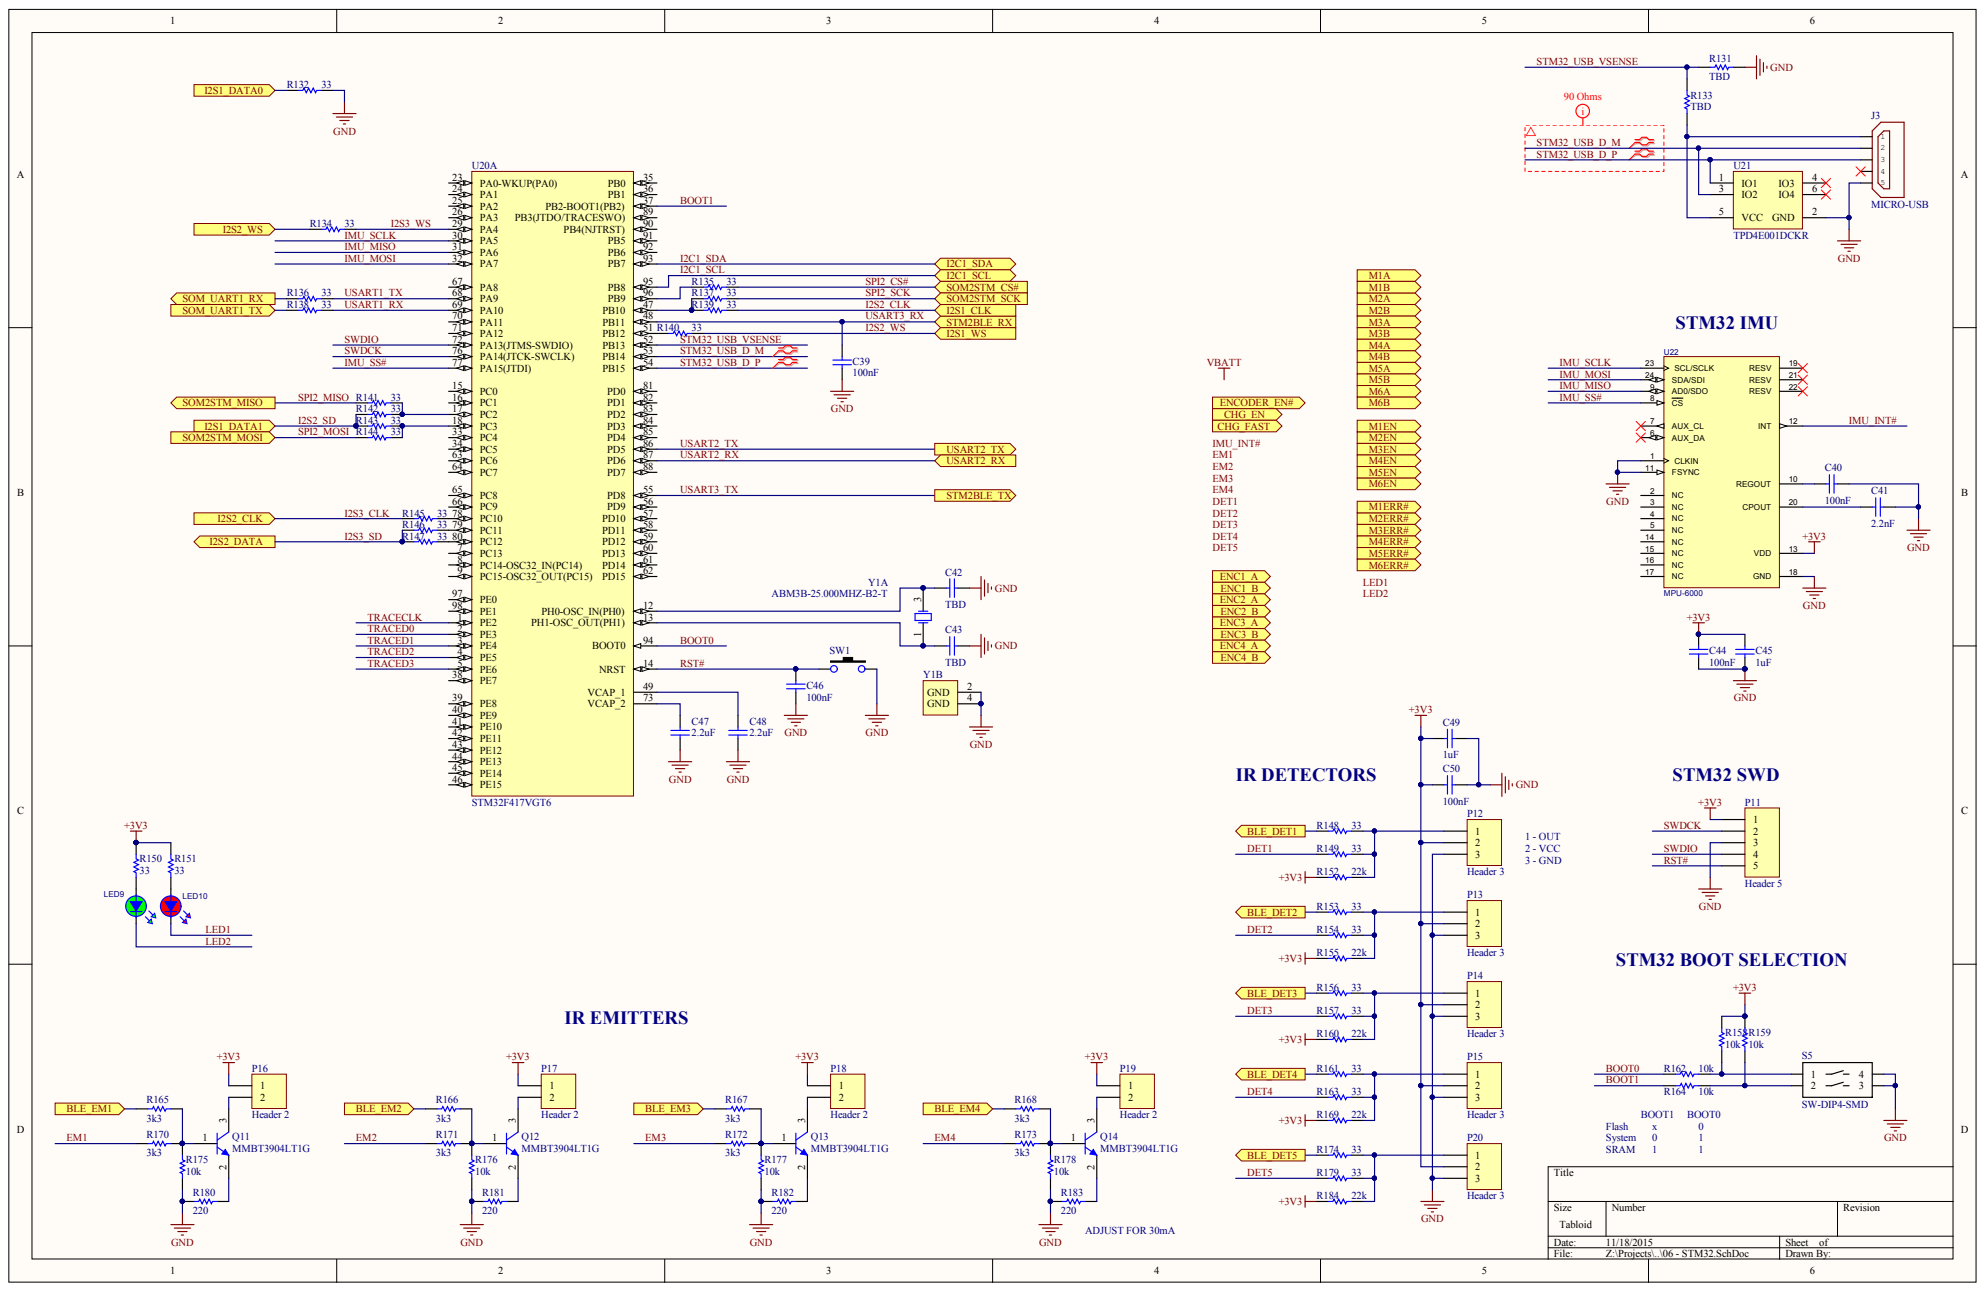
[picture p53: page 6]

STM32_USB_D_P

PA9 68 PA10 69 PA11 70 | | | USART3_RX

PA12 71 | R140 33 | I2S2_WS
PA13(JTMS-SWDIO) 72 | STM32_USB_VSENSE

Size Tabloid | Number | Revision

Date: 11/18/2015 | Sheet of
File: Z:\Projects\..\06 - STM32.SchDoc | Drawn By:

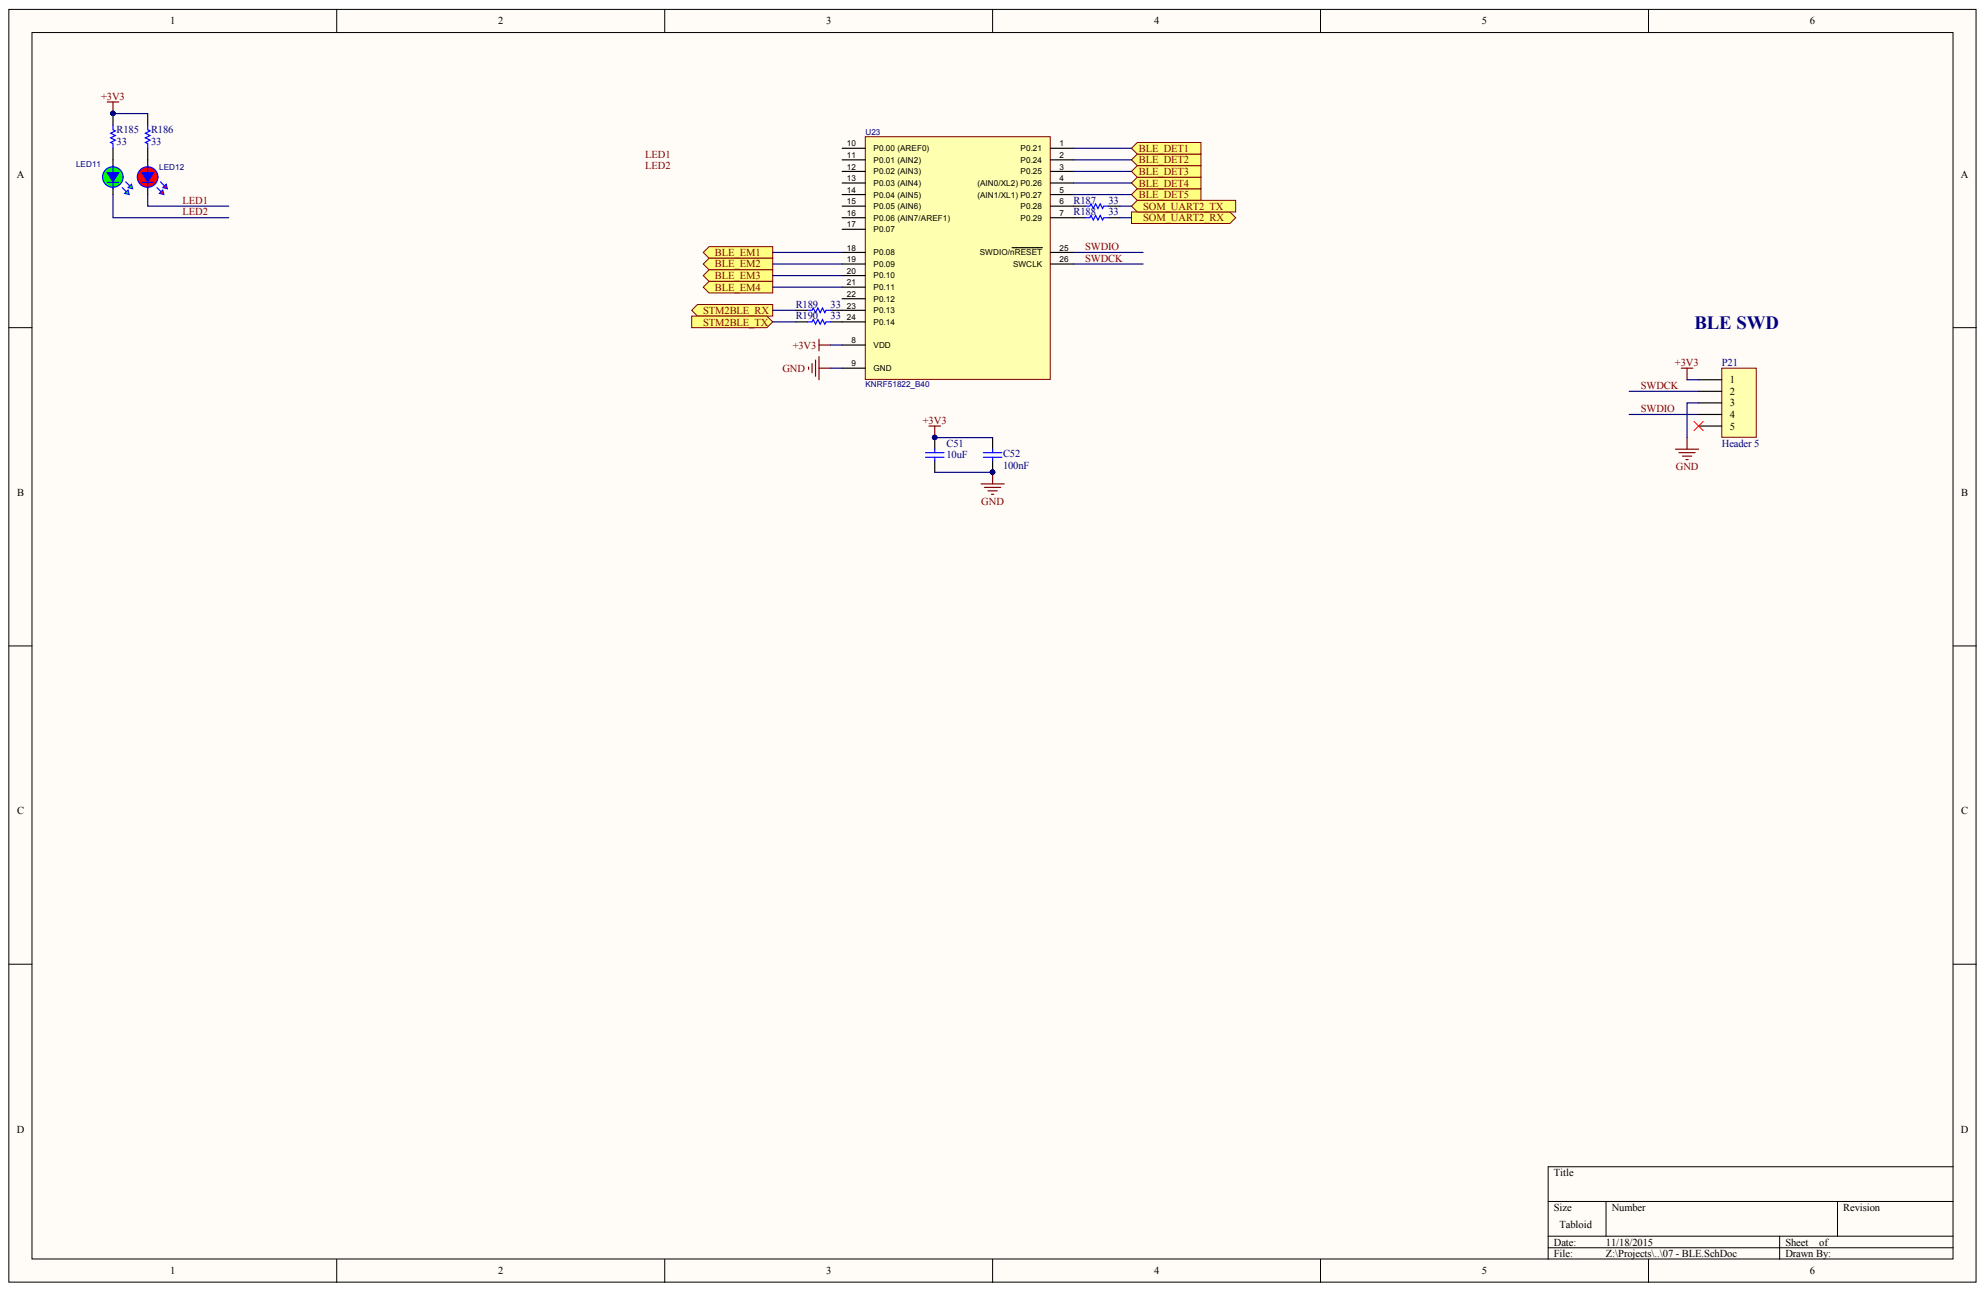
[picture p54: page 7]

T abloid | e r | Re visio n

Date : 1 1/1 8/2 0 1 5 | S h e et o f
File : Z:\P r oje cts\..\0 7 - BL E.S c hDo c | Dr awn By :

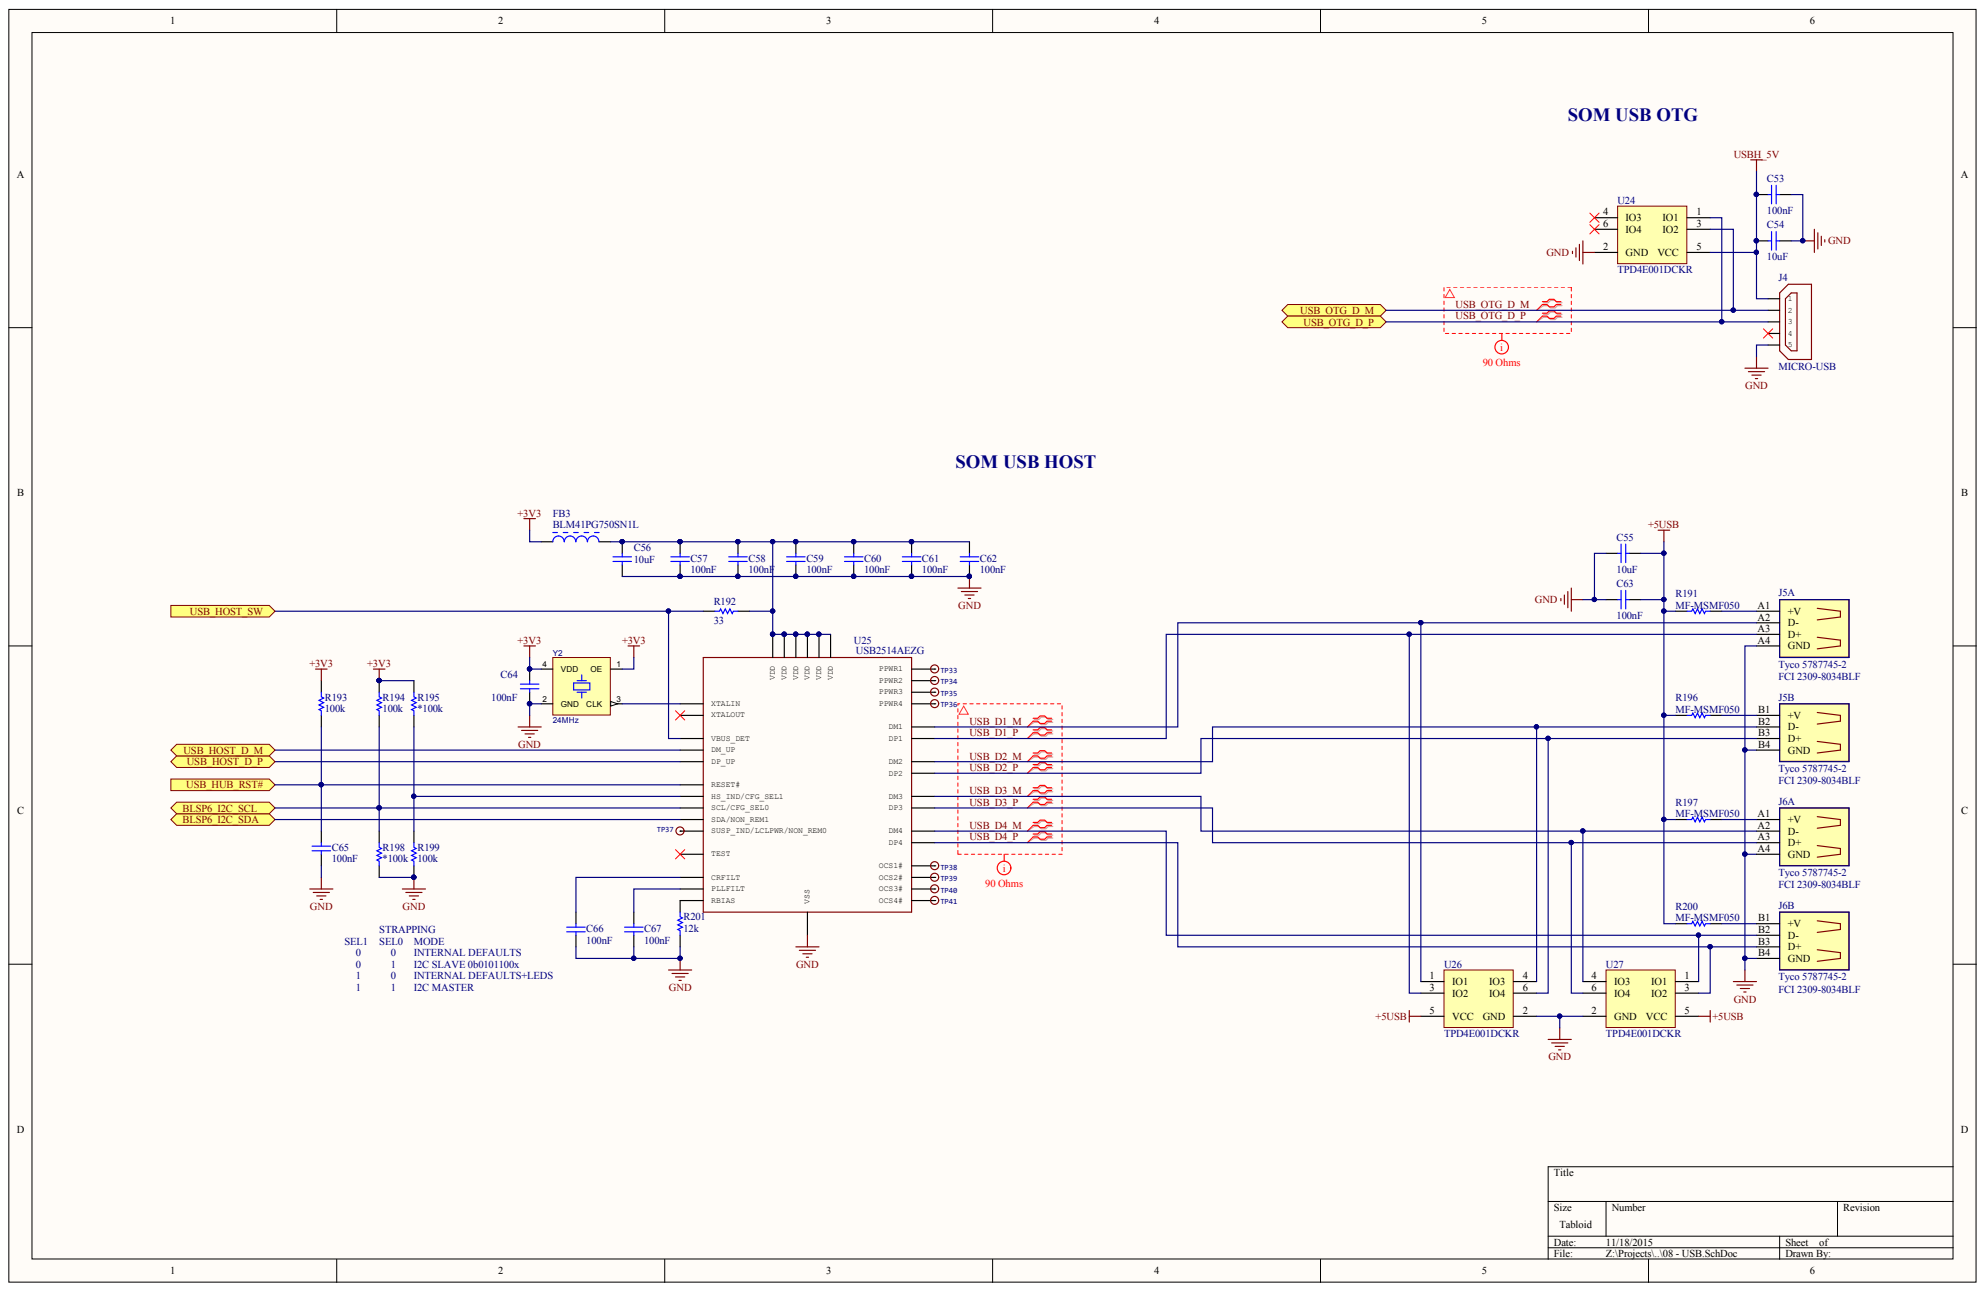
[picture p55: page 8]

D+ A3
GND A4

USB_D3_M
USB_D3_P

Size Tabloid | Number | Revision

Date: 11/18/2015 | Sheet of
File: Z:\Projects\..\08 - USB.SchDoc | Drawn By:

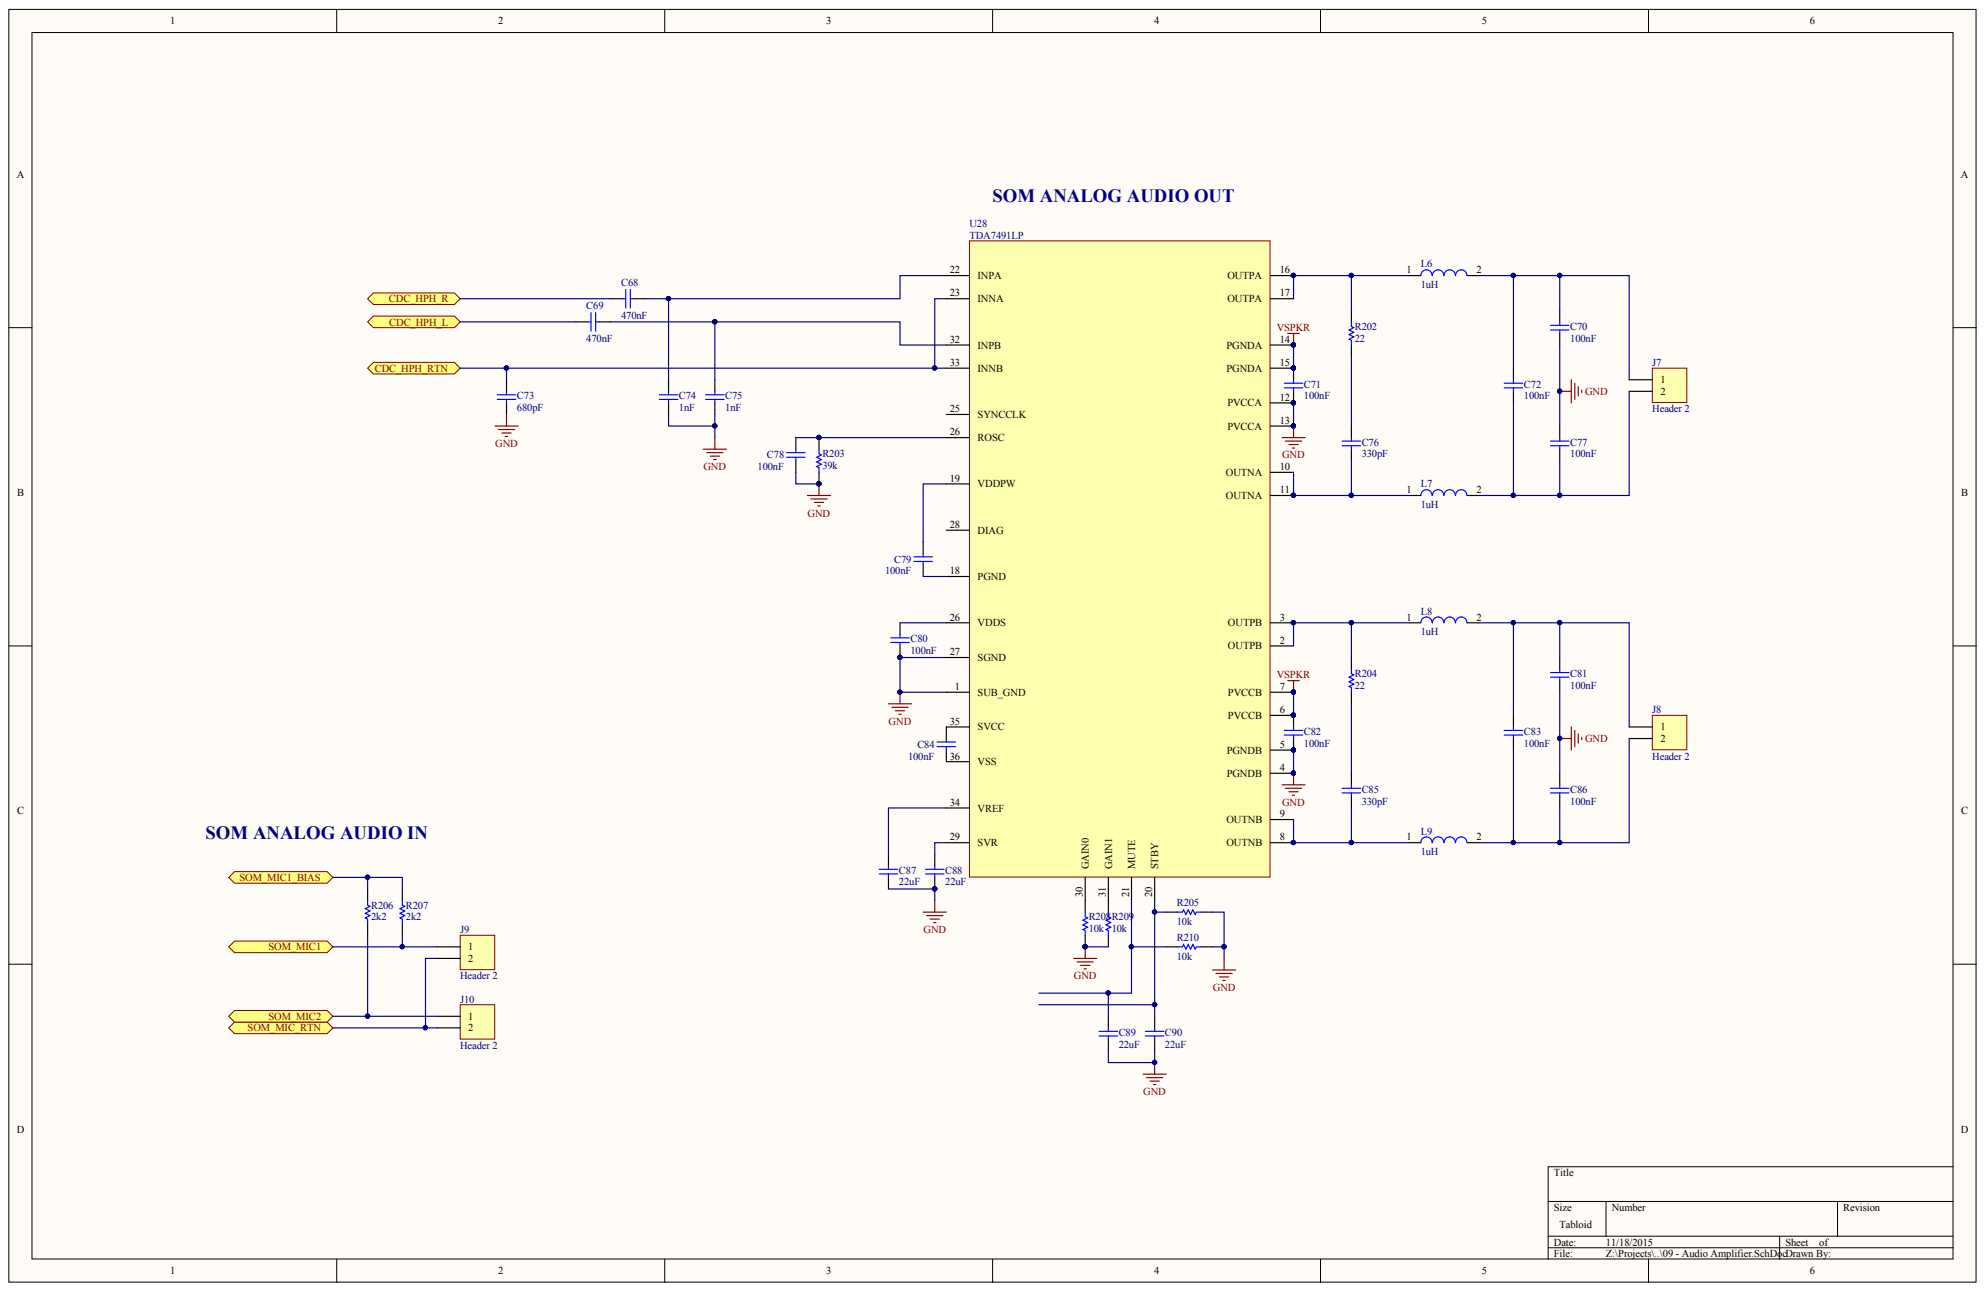
[picture p56: page 9]

SOM ANALOG AUDIO OUT

SOM ANALOG AUDIO IN

T abloid | e r | Re visio n

Date : 1 1/1 8/2 0 1 5 | S h e et o f
File : Z:\P r oje cts\..\0 9 - Au dio Amplifie r.S c hDo | cDr awn By :
