bens-unit01/switchbot-complete-prj/documents/boards-shematics/Motor Control/sommotor-assembly-20160404.pdf

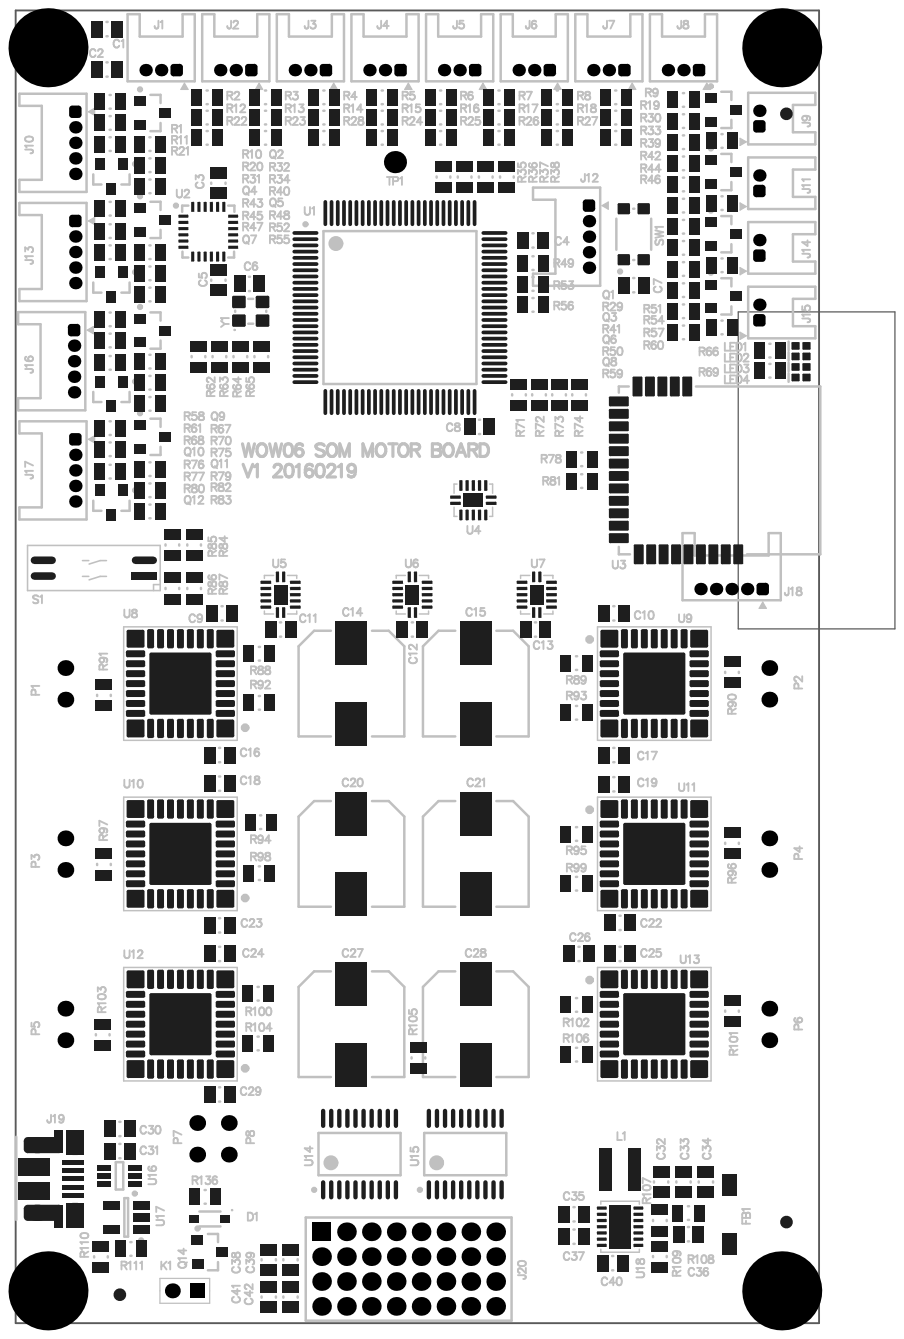
[picture p57: page 1]

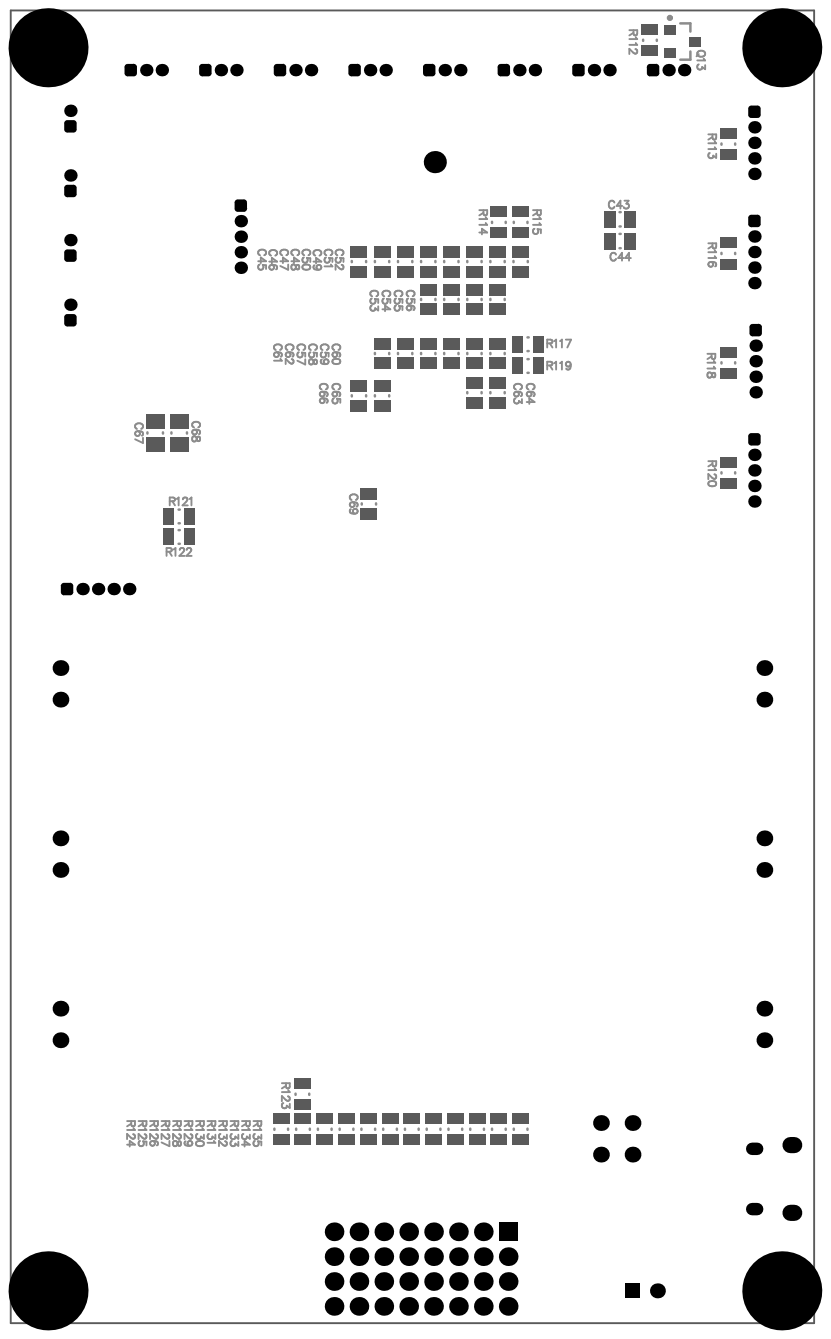
[picture p58: page 2]
