bens-unit01/switchbot-complete-prj/documents/boards-shematics/Motor Control/sommotor-assembly-color.pdf

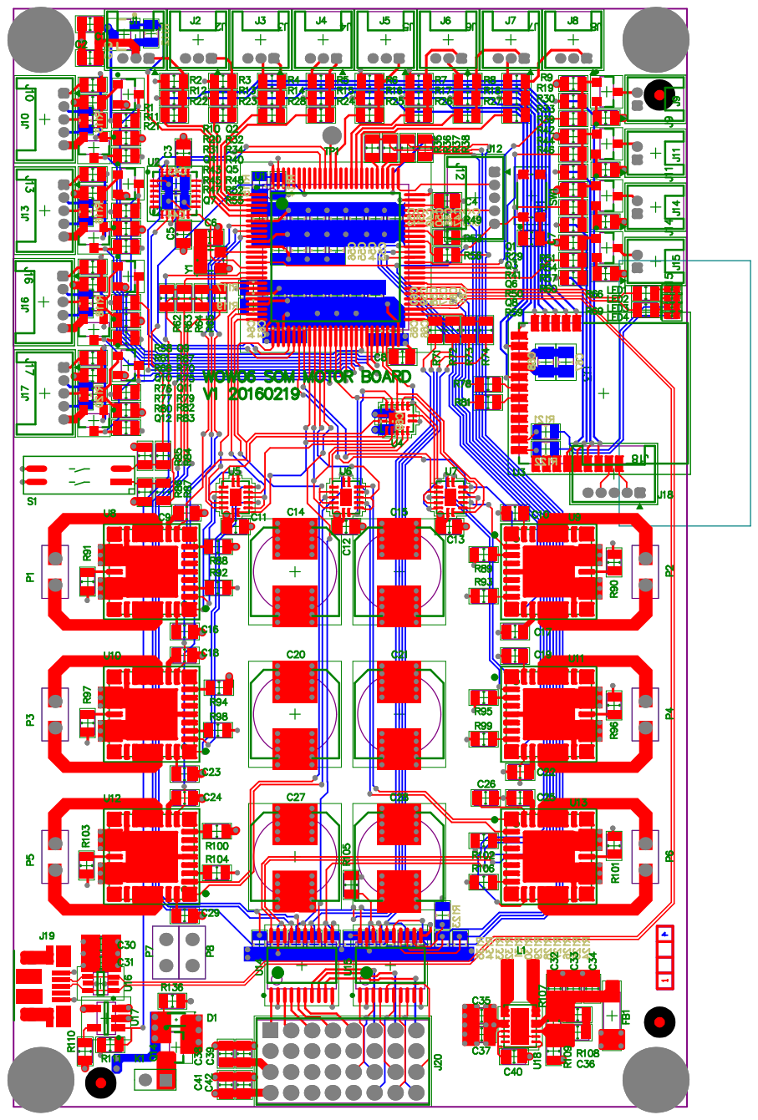
[picture p59: page 1]
