bens-unit01/switchbot-complete-prj/documents/switch bot_lay_V1.1.pdf

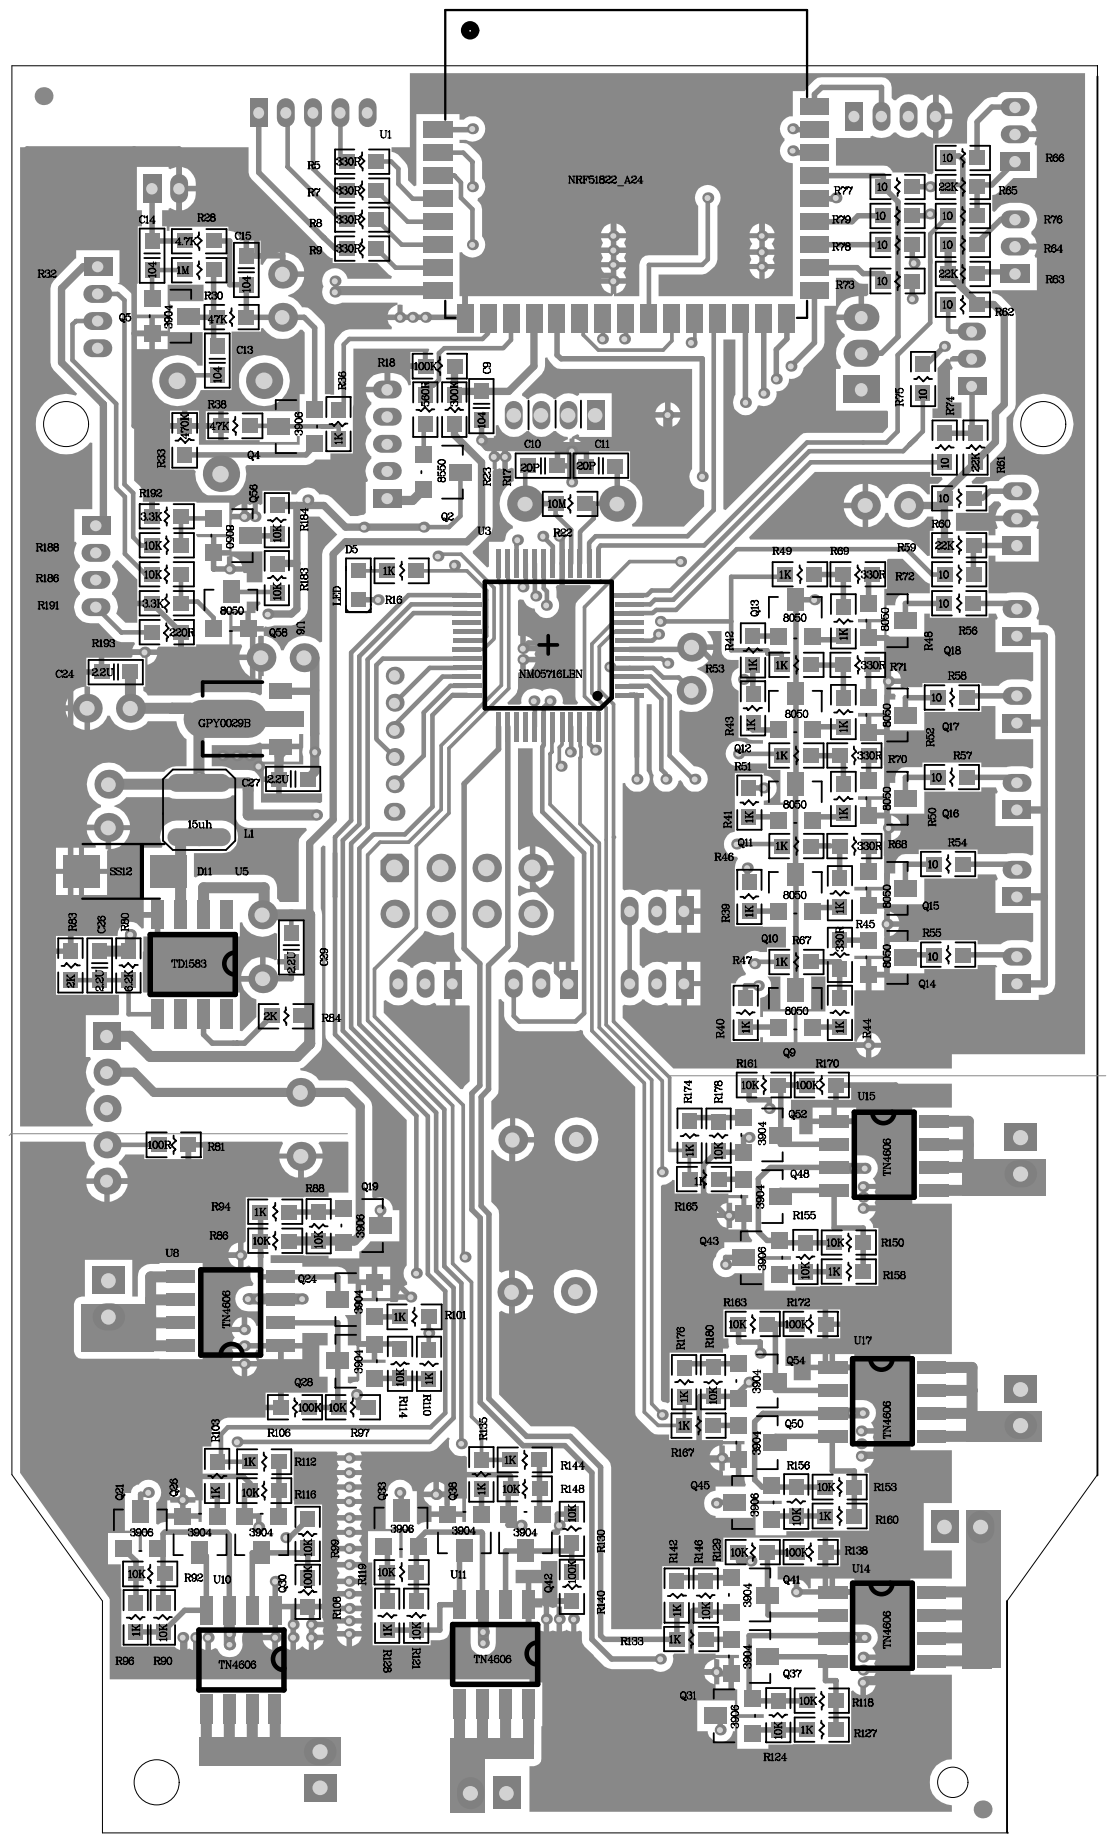
[picture p60: page 1]

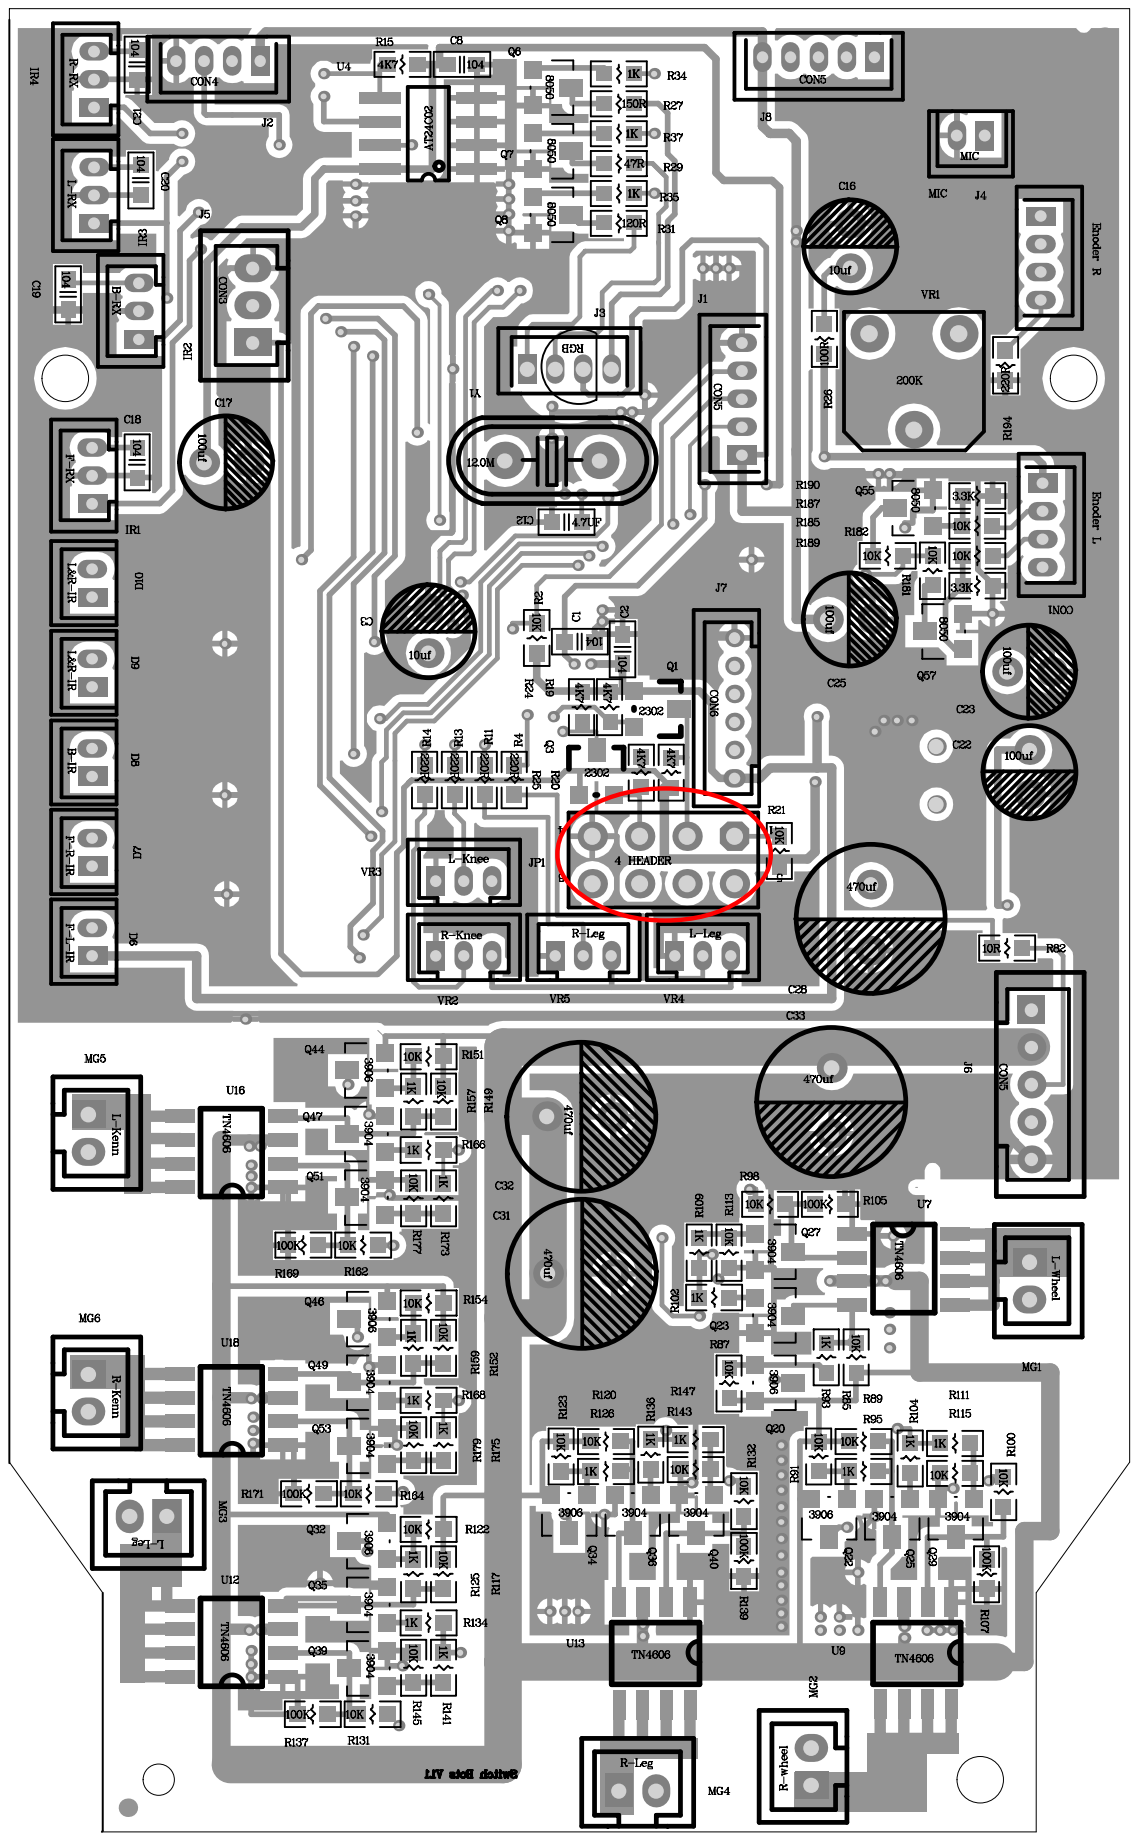
[picture p61: page 2]
