bens-unit01/switchbot-complete-prj/documents/boards-shematics/SOM/Audio-Amplifier.pdf

## SOM ANALOG AUDIO OUT

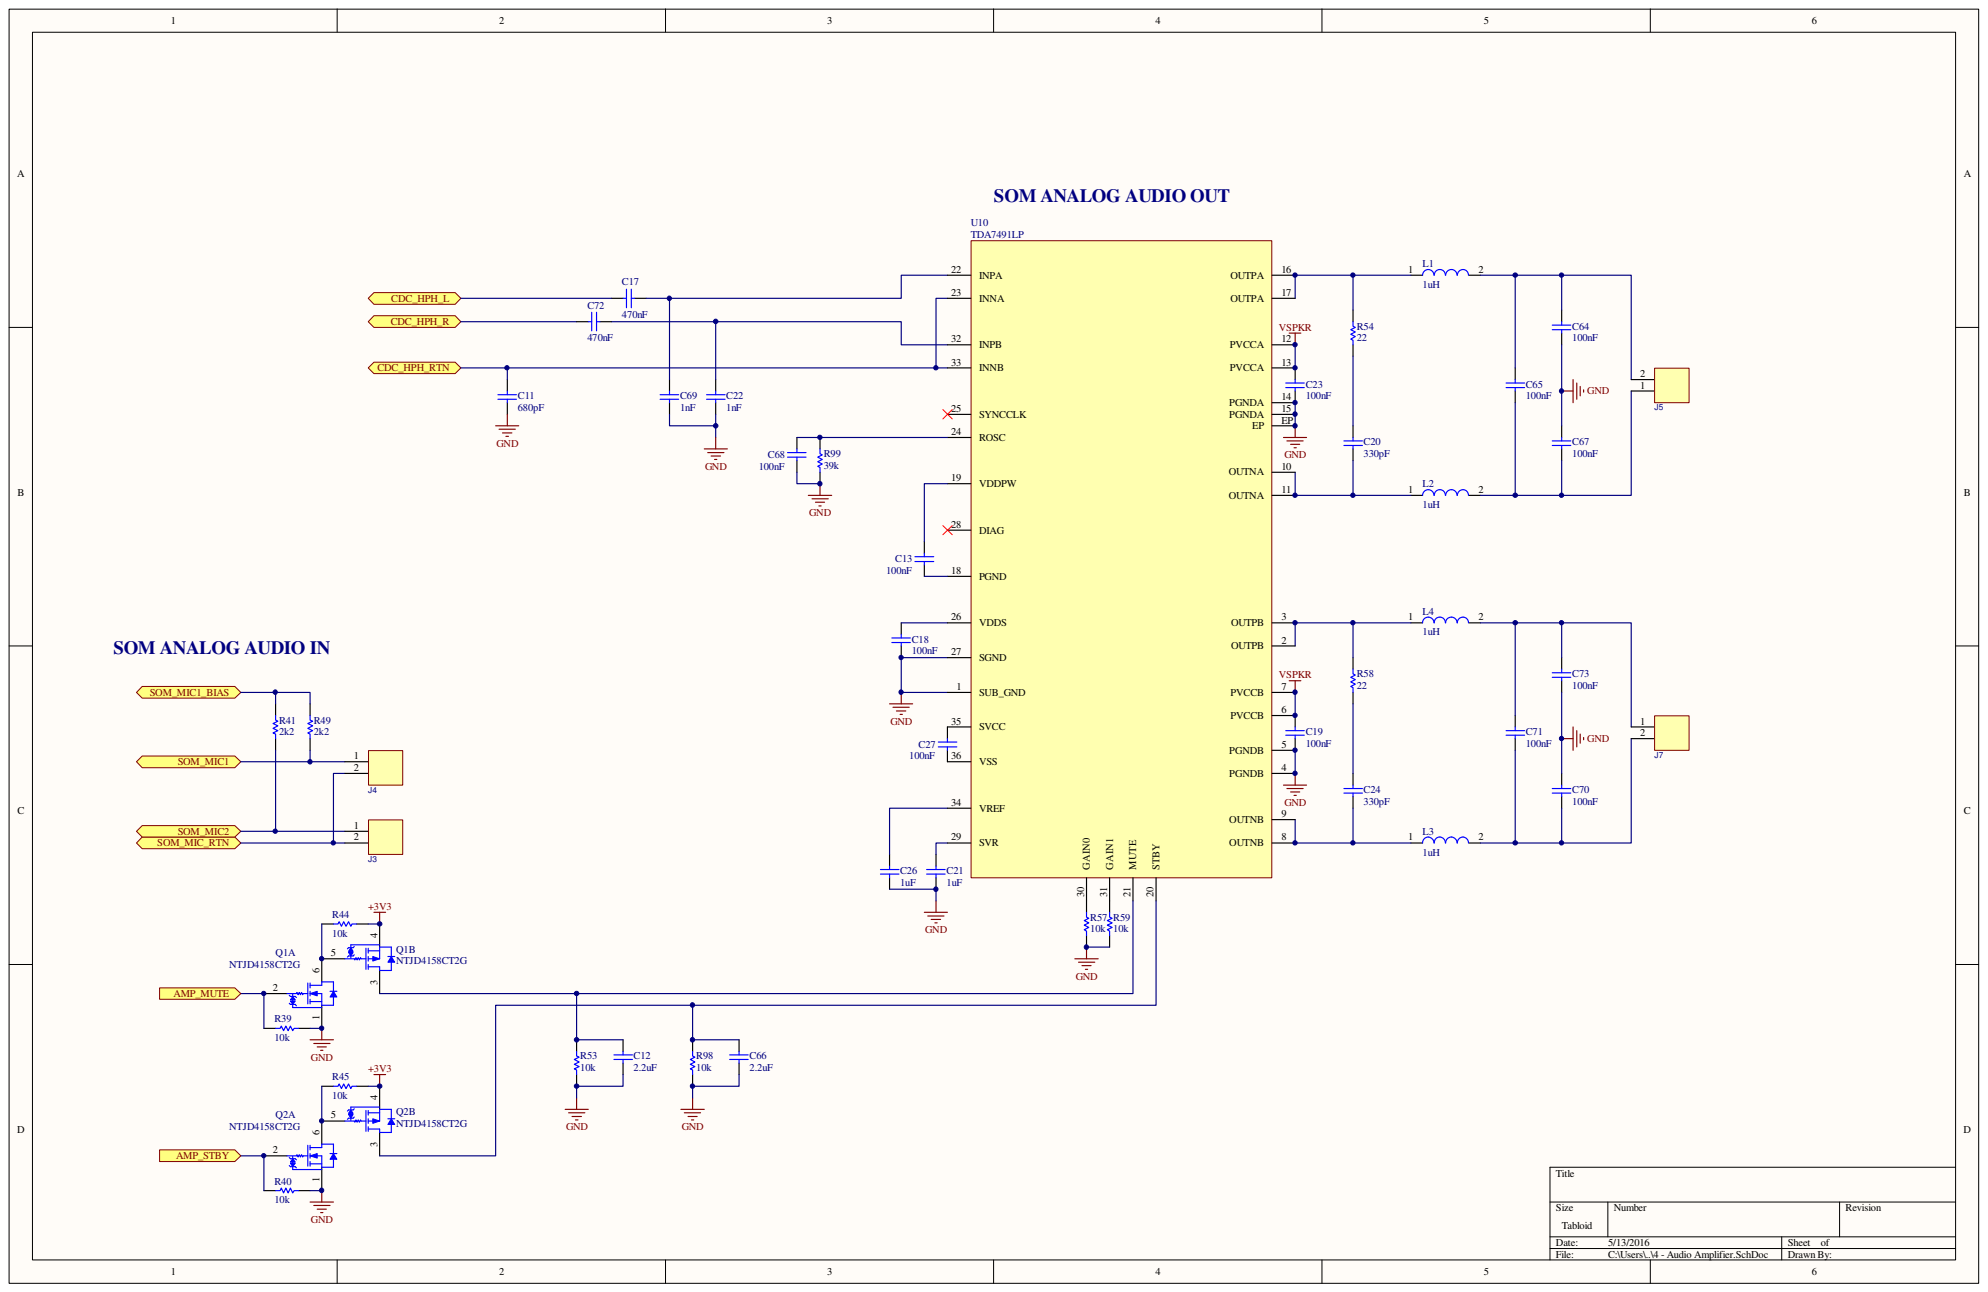
[picture p62: page 1]

SOM ANALOG AUDIO IN
