bens-unit01/switchbot-complete-prj/documents/boards-shematics/SOM/Power.pdf

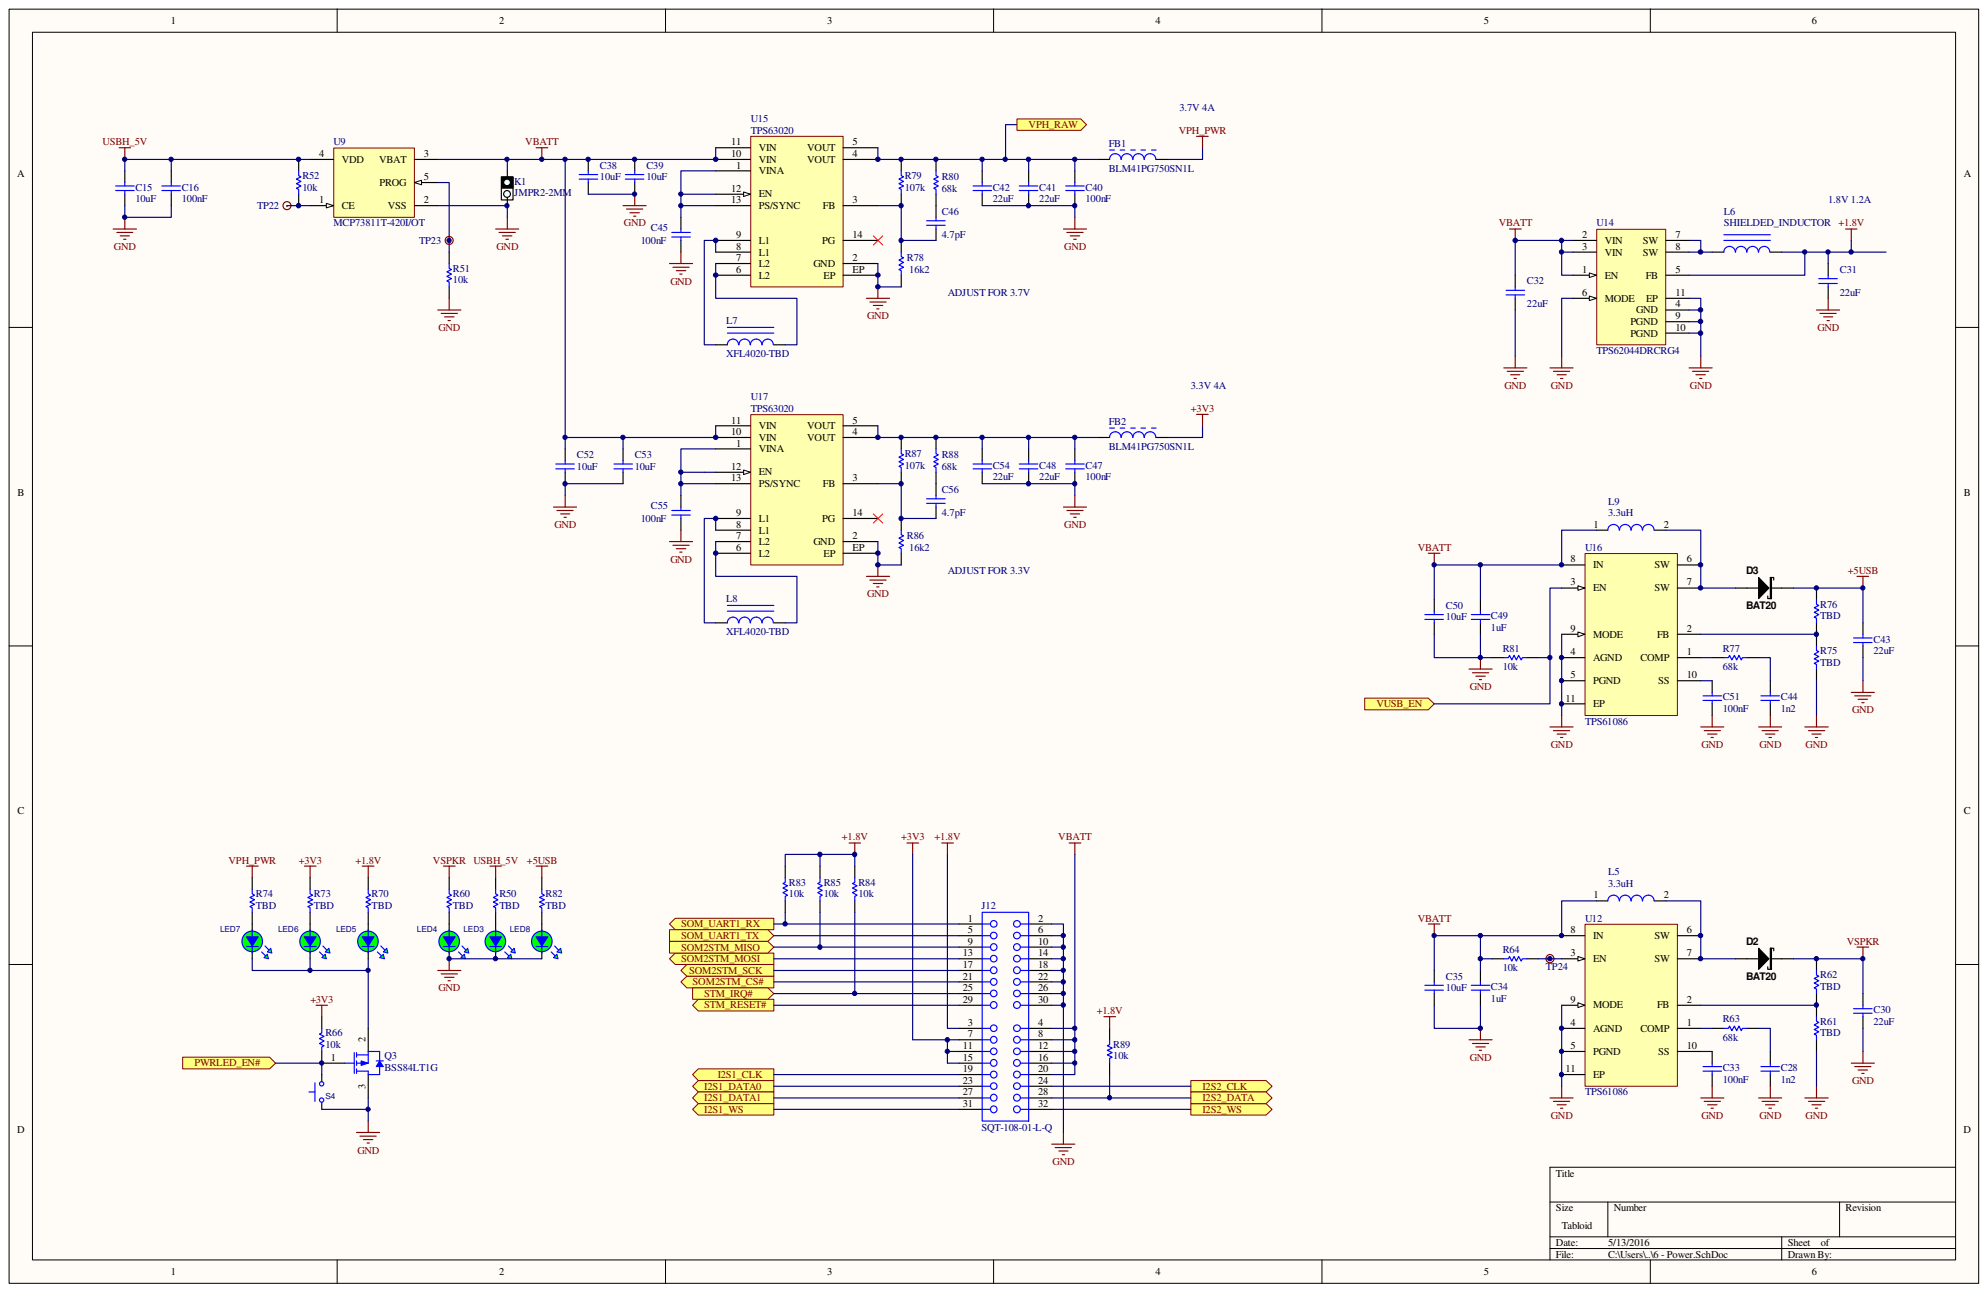
[picture p63: page 1]
