bens-unit01/switchbot-complete-prj/documents/boards-shematics/SOM/Pripherals.pdf

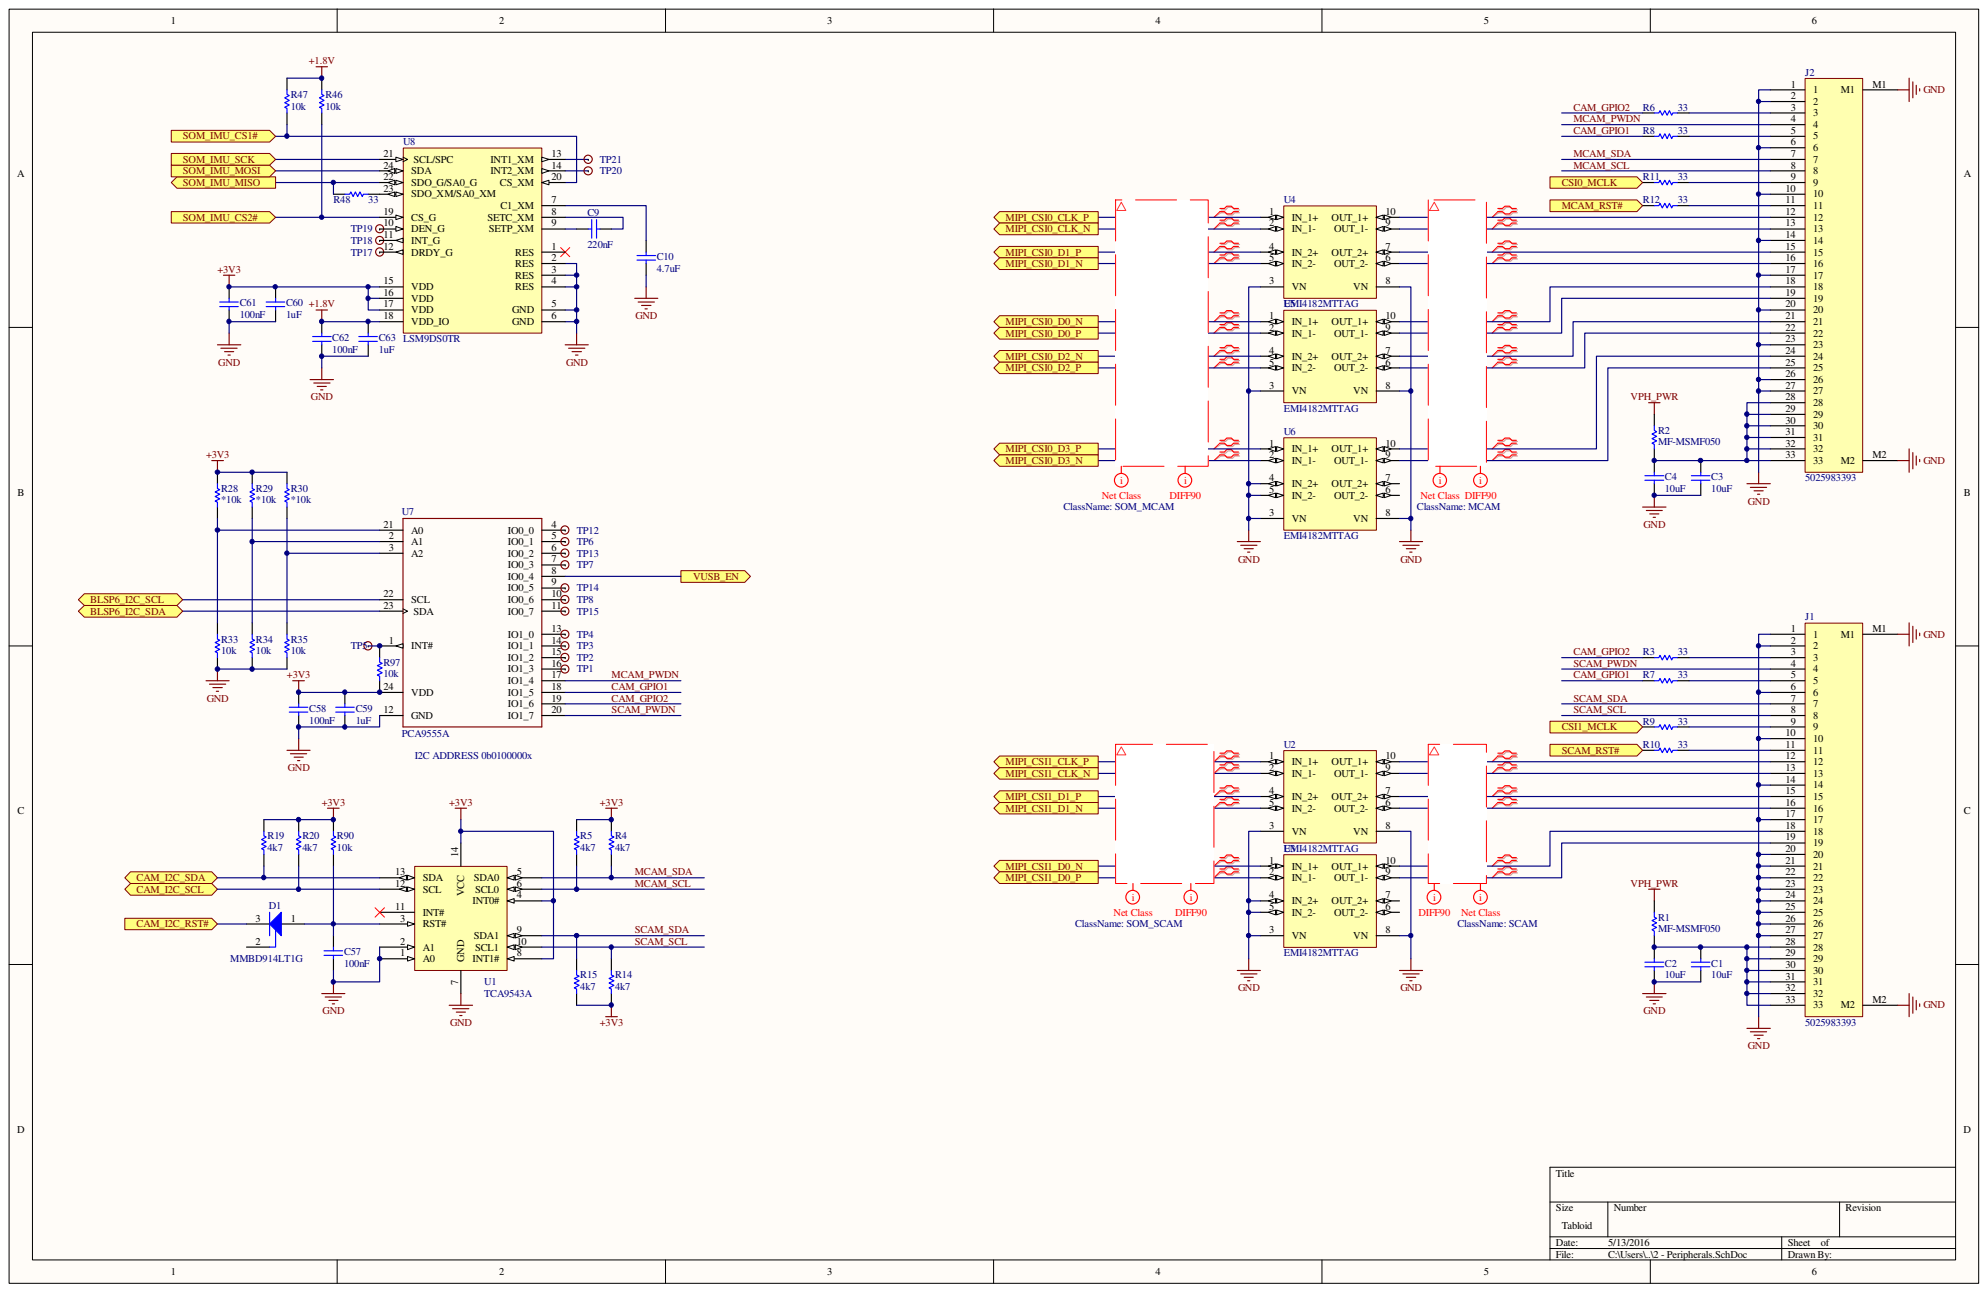
[picture p64: page 1]

A1 2
A2 3
