bens-unit01/switchbot-complete-prj/documents/boards-shematics/SOM/SOM.pdf

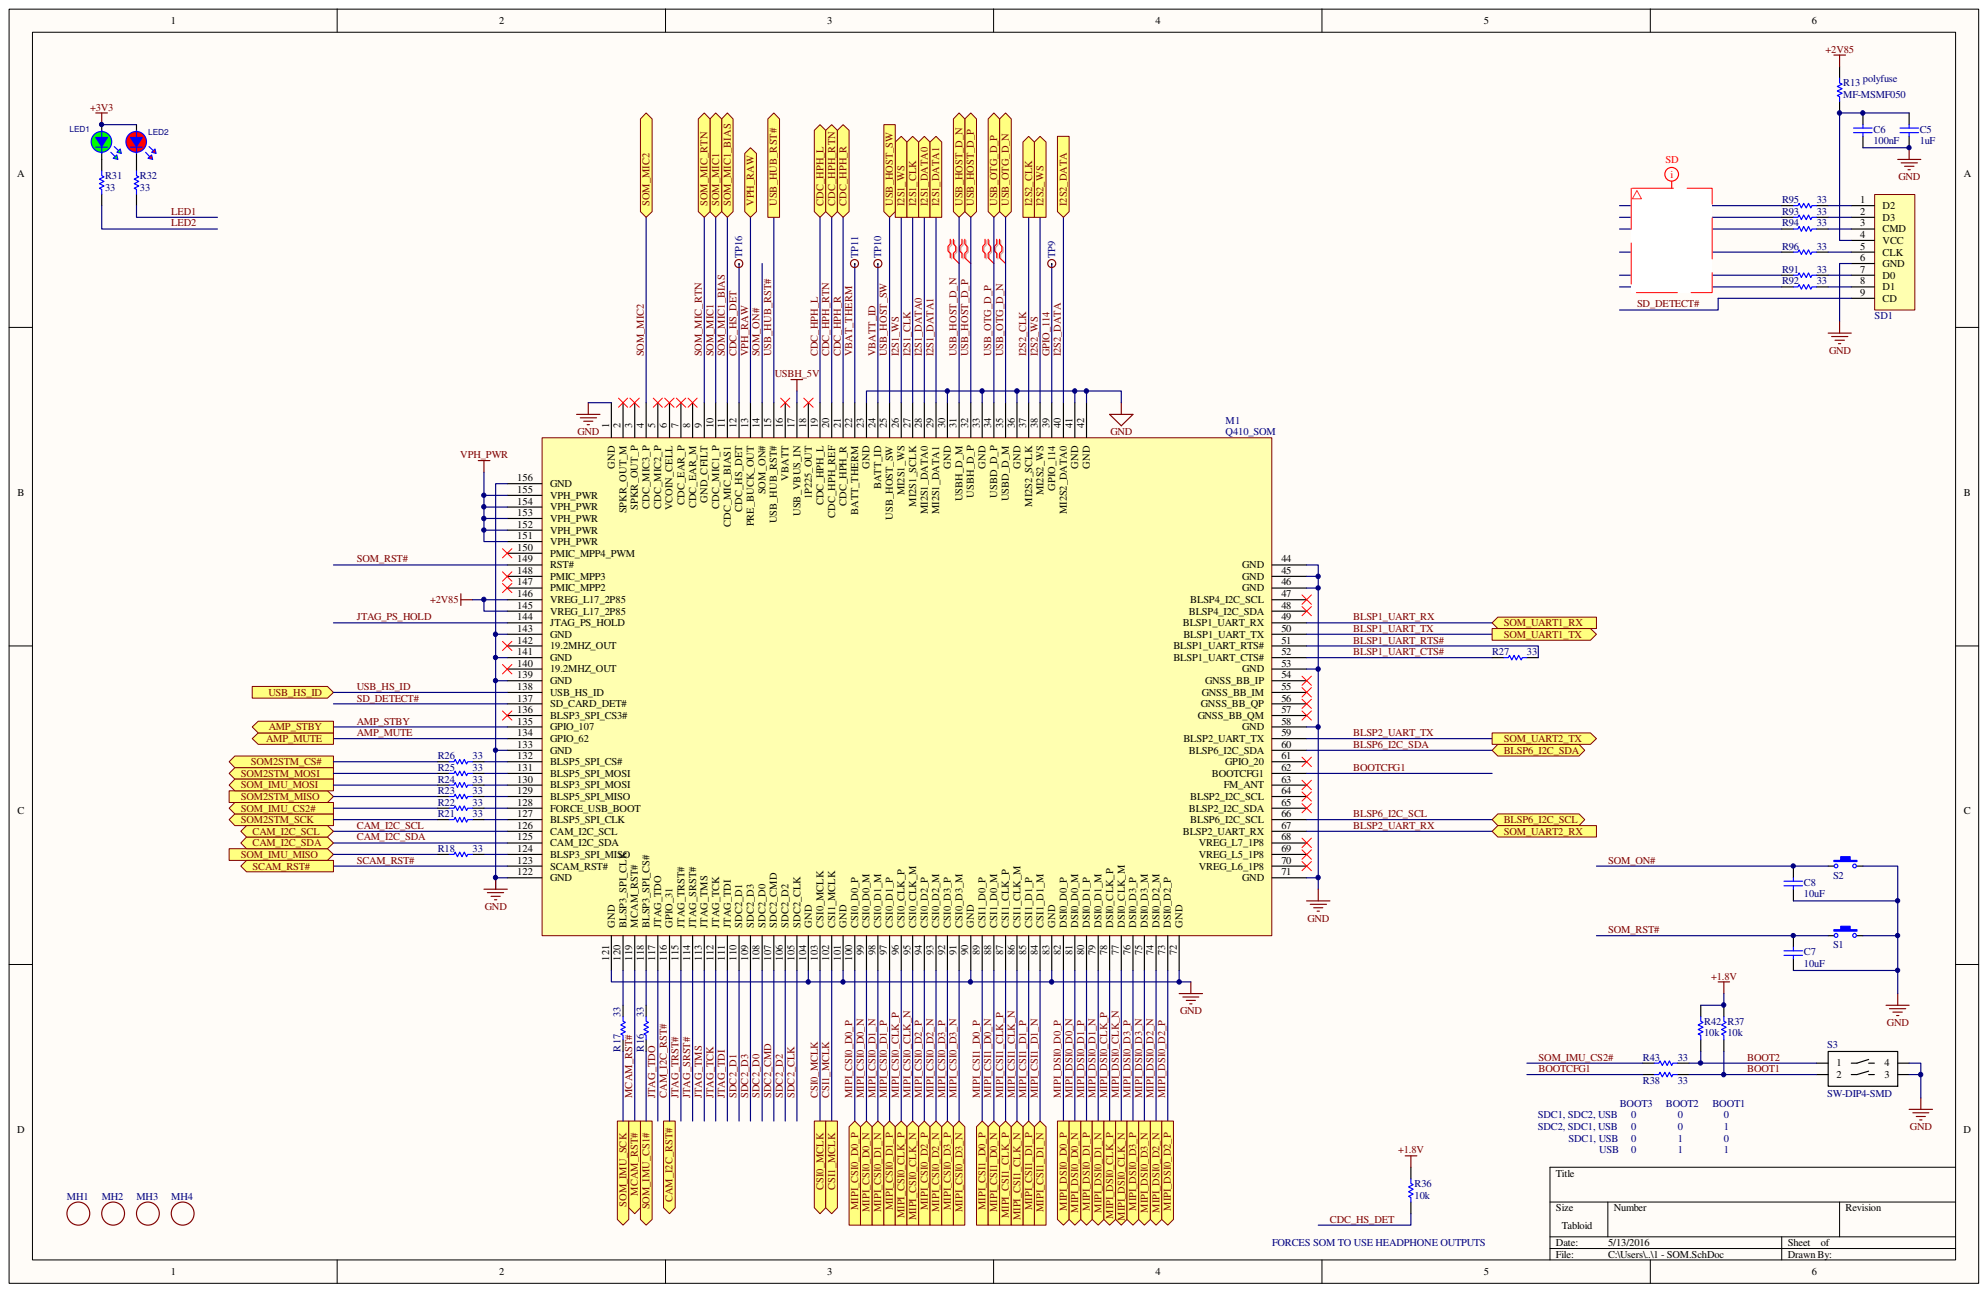
[picture p65: page 1]

FORCES SOM TO USE HEADPHONE OUTPUTS
