bens-unit01/switchbot-complete-prj/documents/boards-shematics/SOM/sombreakout.pdf

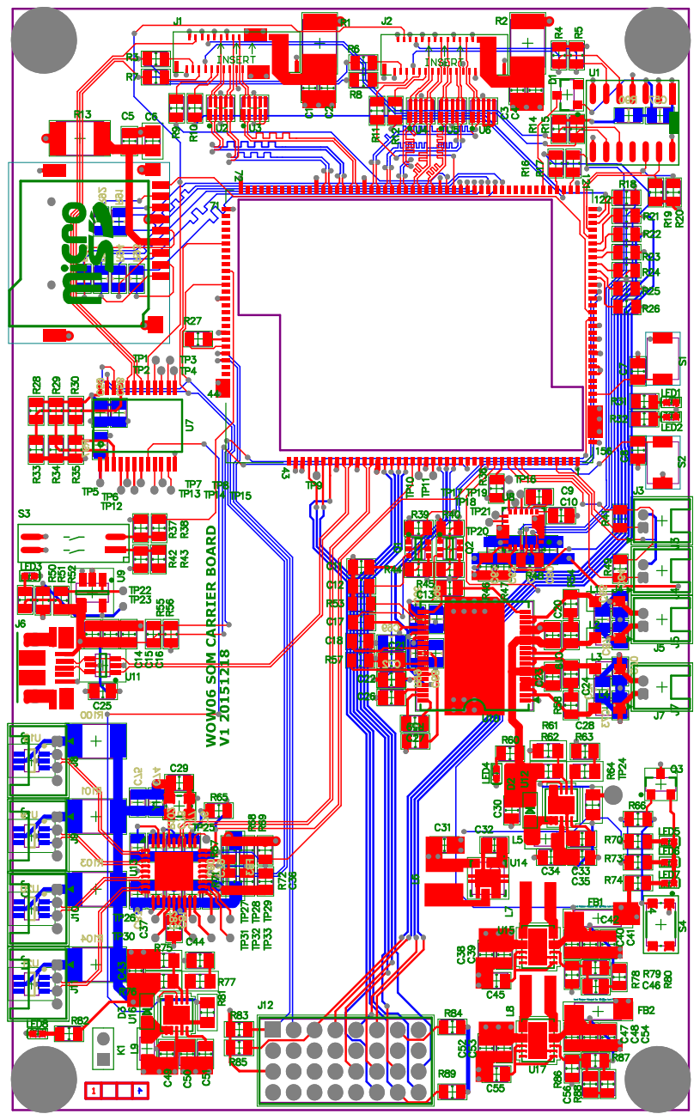
[picture p66: page 1]
