bens-unit01/switchbot-complete-prj/documents/boards-shematics/SOM/USB.pdf

## SOM USB OTG

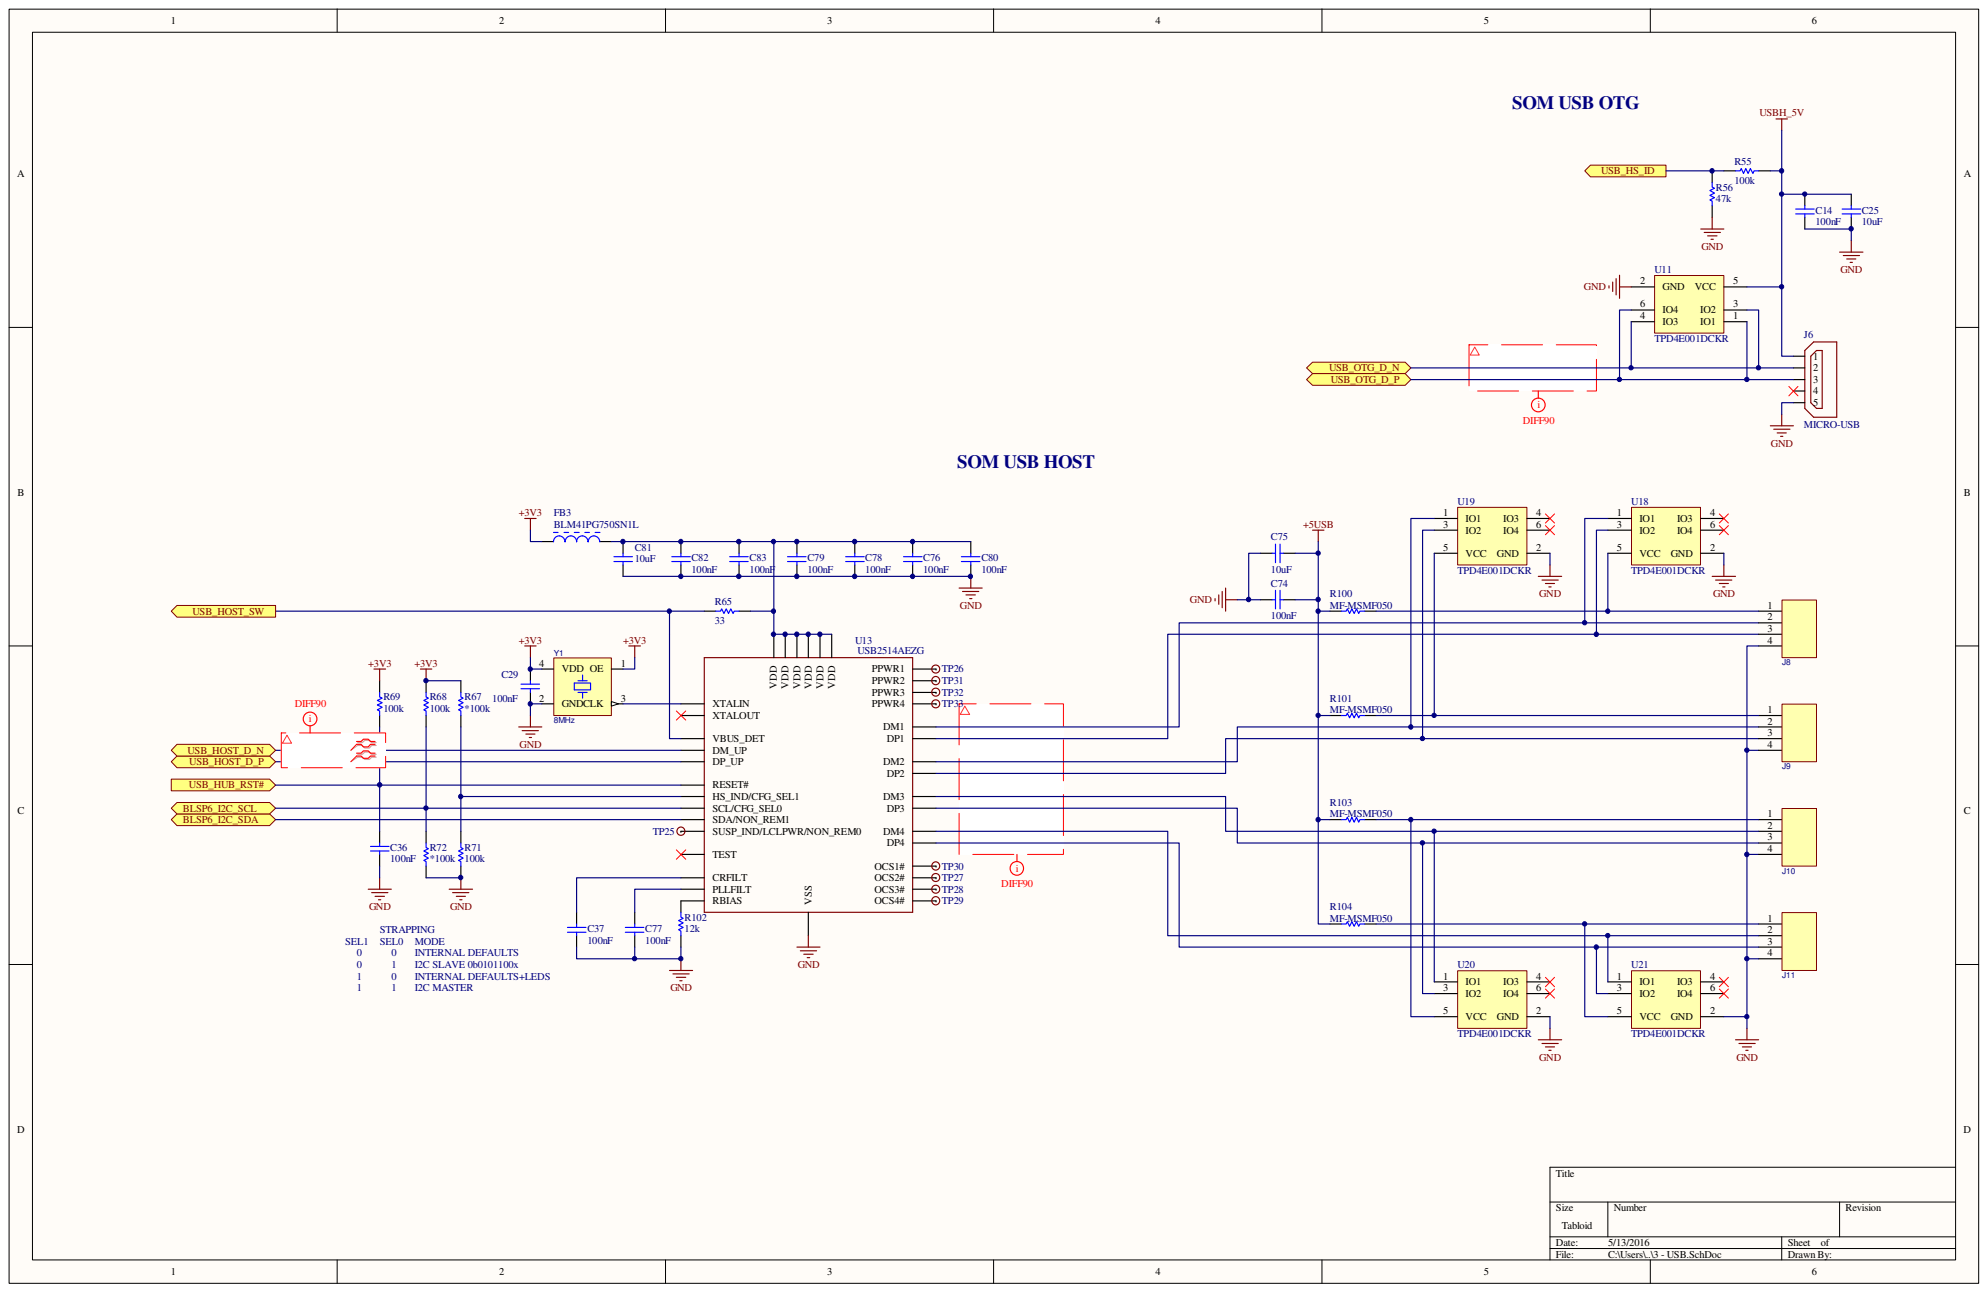
[picture p67: page 1]
