bens-unit01/switchbot-complete-prj/(list of files, drawings)

Other design files:
documents/boards-shematics/Motor Control/Altium-files/1 - STM32.SchDoc
documents/boards-shematics/Motor Control/Altium-files/2 - BLE.SchDoc
documents/boards-shematics/Motor Control/Altium-files/3 - Motor Drivers.SchDoc
documents/boards-shematics/Motor Control/Altium-files/4 - Connectors.SchDoc
documents/boards-shematics/Motor Control/Altium-files/5 - PWM Steering.SchDoc
documents/boards-shematics/Motor Control/Altium-files/sommotor.PrjPcb
documents/boards-shematics/SOM/Altium-files/1 - SOM.SchDoc
documents/boards-shematics/SOM/Altium-files/2 - Peripherals.SchDoc
documents/boards-shematics/SOM/Altium-files/3 - USB.SchDoc
documents/boards-shematics/SOM/Altium-files/4 - Audio Amplifier.SchDoc
documents/boards-shematics/SOM/Altium-files/5 - Connectors.SchDoc
documents/boards-shematics/SOM/Altium-files/6 - Power.SchDoc
documents/boards-shematics/SOM/Altium-files/q410som.PcbLib
documents/boards-shematics/SOM/Altium-files/q410som.SchLib
documents/boards-shematics/SOM/Altium-files/sombreakout.PrjPcb
