bens-unit01/switchbot-complete-prj/microcontrollers/nuveton/Code_with_Libraries/Encoders/Nu_Link_Driver.ini

[Version]
Nu_LinkVersion=V3.0
[Process]
ProcessID=0x0000154c
ProcessCreationTime_L=0xddc43c60
ProcessCreationTime_H=0x01d00f2b
NuLinkID=0x180006e9
NuLinkID0=0x180006e9
NuLinkIDs_Count=0x00000001
[ChipSelect]
;ChipName=<NUC1xx|NUC2xx|M05x|N572|Nano100|N512|Mini51|General>
ChipName=M05x
[NUC4xx]
Reset=Autodetect
MaxClock=1MHz
MemoryVerify=1
IOVoltage=3300
FlashSelect=APROM
Erase=1
Program=1
Verify=1
ResetAndRun=0
EnableFlashBreakpoint=1
EnableLog=0
RAMForAlgorithmStart=0x20000000
RAMForAlgorithmSize=0x4000
ProgramAlgorithm=NUC400_AP_512.FLM
[NUC2xx]
Reset=Autodetect
MaxClock=1MHz
MemoryVerify=1
IOVoltage=3300
FlashSelect=APROM
Erase=1
Program=1
Verify=1
ResetAndRun=0
EnableFlashBreakpoint=1
EnableLog=0
RAMForAlgorithmStart=0x20000000
RAMForAlgorithmSize=0x1000
ProgramAlgorithm=NUC200_AP_128.FLM
[NUC1xx]
Reset=Autodetect
MaxClock=1MHz
MemoryVerify=1
IOVoltage=3300
FlashSelect=APROM
Erase=1
Program=1
Verify=1
ResetAndRun=0
EnableFlashBreakpoint=1
EnableLog=0
RAMForAlgorithmStart=0x20000000
RAMForAlgorithmSize=0x1000
ProgramAlgorithm=NUC100_AP_128.FLM
[NM1500]
Reset=Autodetect
MaxClock=1MHz
MemoryVerify=1
IOVoltage=3300
FlashSelect=APROM
Erase=1
Program=1
Verify=1
ResetAndRun=0
EnableFlashBreakpoint=1
EnableLog=0
RAMForAlgorithmStart=0x20000000
RAMForAlgorithmSize=0x1000
ProgramAlgorithm=NM1500_AP_128.FLM
[Nano100]
Reset=Autodetect
MaxClock=1MHz
MemoryVerify=1
IOVoltage=3300
FlashSelect=APROM
Erase=1
Program=1
Verify=1
ResetAndRun=0
EnableFlashBreakpoint=1
EnableLog=0
RAMForAlgorithmStart=0x20000000
RAMForAlgorithmSize=0x1000
ProgramAlgorithm=Nano100_AP_64.FLM
[N572]
Reset=Autodetect
MaxClock=1MHz
MemoryVerify=1
IOVoltage=3300
Erase=1
Program=1
Verify=1
ResetAndRun=0
EnableFlashBreakpoint=1
EnableLog=0
RAMForAlgorithmStart=0x20000000
RAMForAlgorithmSize=0x2000
ProgramAlgorithm=N572F064.FLM
[N512]
Reset=Autodetect
MaxClock=1MHz
MemoryVerify=1
IOVoltage=3300
FlashSelect=APROM
Erase=1
Program=1
Verify=1
ResetAndRun=0
EnableFlashBreakpoint=1
EnableLog=0
RAMForAlgorithmStart=0x20000000
RAMForAlgorithmSize=0x1000
ProgramAlgorithm=N512_AP_64.FLM
[Mini51]
Reset=Autodetect
MaxClock=1MHz
MemoryVerify=1
IOVoltage=3300
FlashSelect=APROM
Erase=1
Program=1
Verify=1
ResetAndRun=0
EnableFlashBreakpoint=1
EnableLog=0
RAMForAlgorithmStart=0x20000000
RAMForAlgorithmSize=0x800
ProgramAlgorithm=Mini51_AP_16.FLM
[M451]
Reset=Autodetect
MaxClock=1MHz
MemoryVerify=0
IOVoltage=3300
FlashSelect=APROM
Erase=1
Program=1
Verify=1
ResetAndRun=0
EnableFlashBreakpoint=1
EnableLog=0
RAMForAlgorithmStart=0x20000000
RAMForAlgorithmSize=0x4000
ProgramAlgorithm=M451_AP_256.FLM
[M05x]
Reset=Autodetect
MaxClock=1MHz
MemoryVerify=1
IOVoltage=3300
FlashSelect=APROM
Erase=1
Program=1
Verify=1
ResetAndRun=1
EnableFlashBreakpoint=1
EnableLog=0
RAMForAlgorithmStart=0x20000000
RAMForAlgorithmSize=0x800
ProgramAlgorithm=M0516_AP_64.FLM
[ISD9300]
Reset=Autodetect
MaxClock=1MHz
MemoryVerify=1
IOVoltage=3300
FlashSelect=APROM
Erase=1
Program=1
Verify=1
ResetAndRun=0
EnableFlashBreakpoint=0
EnableLog=0
RAMForAlgorithmStart=0x20000000
RAMForAlgorithmSize=0x1000
ProgramAlgorithm=ISD9300_AP_145.FLM 
[ISD9xxx]
Reset=Autodetect
MaxClock=1MHz
MemoryVerify=1
IOVoltage=3300
FlashSelect=APROM
Erase=1
Program=1
Verify=1
ResetAndRun=0
EnableFlashBreakpoint=0
EnableLog=0
RAMForAlgorithmStart=0x20000000
RAMForAlgorithmSize=0x1000
ProgramAlgorithm=ISD9100_AP_145.FLM
[AU9xxx]
Reset=Autodetect
MaxClock=1MHz
MemoryVerify=1
IOVoltage=3300
FlashSelect=APROM
Erase=1
Program=1
Verify=1
ResetAndRun=0
EnableFlashBreakpoint=0
EnableLog=0
RAMForAlgorithmStart=0x20000000
RAMForAlgorithmSize=0x1000
ProgramAlgorithm=AU9100_AP_145.FLM
[General]
Reset=Autodetect
MaxClock=1MHz
MemoryVerify=1
IOVoltage=3300
Erase=1
Program=1
Verify=1
ResetAndRun=0
EnableLog=0
RAMForAlgorithmStart=0x20000000
RAMForAlgorithmSize=0x4000
ProgramAlgorithm=
