bens-unit01/switchbot-complete-prj/microcontrollers/nordic/BLE_BEACON/main.c

/* Copyright (c) 2012 Nordic Semiconductor. All Rights Reserved.
 *
 * The information contained herein is property of Nordic Semiconductor ASA.
 * Terms and conditions of usage are described in detail in NORDIC
 * SEMICONDUCTOR STANDARD SOFTWARE LICENSE AGREEMENT.
 *
 * Licensees are granted free, non-transferable use of the information. NO
 * WARRANTY of ANY KIND is provided. This heading must NOT be removed from
 * the file.
 *
 */

/** @file
 *
 * @defgroup ble_sdk_app_hrs_eval_main main.c
 * @{
 * @ingroup ble_sdk_app_hrs_eval
 * @brief Main file for Heart Rate Service Sample Application for nRF51822 evaluation board
 *
 * This file contains the source code for a sample application using the Heart Rate service
 * (and also Battery and Device Information services) for the nRF51822 evaluation board (PCA10001).
 * This application uses the @ref ble_sdk_lib_conn_params module.
 */

#include <stdint.h>
#include <string.h>
#include "nordic_common.h"
#include "nrf.h"
#include "app_error.h"
#include "nrf51_bitfields.h"
#include "ble.h"
#include "ble_srv_common.h"
#include "ble_advdata.h"
#include "ble_bas.h"
#include "ble_hrs.h"
#include "ble_dis.h"
#include "ble_conn_params.h"
//#include "boards.h"
#include "softdevice_handler.h"
#include "app_timer.h"
#include "nrf_gpio.h"
#include "led.h"
#include "battery.h"
#include "app_util_platform.h"
#include "device_manager.h"
#include "app_gpiote.h"
#include "app_button.h"
#include "ble_debug_assert_handler.h"
#include "pstorage.h"
#include "app_trace.h"
#include "ble_hci.h"
#include "uart_comm2.h"
#include "nrf_gpio.h"

#include "nst_ble_dts.h"
#include "Pram.h"
#include "Ppin.h"
#include "Vehicles.h"
#include "ble_nus.h"
#include "SwitchbotNordic.h"
#include "debug.h"



#define IS_SRVC_CHANGED_CHARACT_PRESENT      0                                          /**< Include or not the service_changed characteristic. if not enabled, the server's database cannot be changed for the lifetime of the device*/
#define BUTTON_0                             24
#define BUTTON_1                             25
#define HR_INC_BUTTON_PIN_NO                 BUTTON_0                                   /**< Button used to increment heart rate. */
#define HR_DEC_BUTTON_PIN_NO                 BUTTON_1                                   /**< Button used to decrement heart rate. */
#define  NB_ROBOTS                            1
#define BOND_DELETE_ALL_BUTTON_ID            HR_DEC_BUTTON_PIN_NO                       /**< Button used for deleting all bonded centrals during startup. */

#define DEVICE_NAME                          "ww_beacon_02"                               /**< Name of device. Will be included in the advertising data. */
#define MANUFACTURER_NAME                    "WowWee"                      /**< Manufacturer. Will be passed to Device Information Service. */
#define APP_ADV_INTERVAL                     40                                         /**< The advertising interval (in units of 0.625 ms. This value corresponds to 25 ms). */
#define APP_ADV_TIMEOUT_IN_SECONDS           180                                        /**< The advertising timeout in units of seconds. */

#define APP_TIMER_PRESCALER                  0                                          /**< Value of the RTC1 PRESCALER register. */
#define APP_TIMER_MAX_TIMERS                 5                                          /**< Maximum number of simultaneously created timers. */
#define APP_TIMER_OP_QUEUE_SIZE              5                                          /**< Size of timer operation queues. */

#define BATTERY_LEVEL_MEAS_INTERVAL          APP_TIMER_TICKS(2000, APP_TIMER_PRESCALER) /**< Battery level measurement interval (ticks). */

#define HEART_RATE_MEAS_INTERVAL             APP_TIMER_TICKS(1000, APP_TIMER_PRESCALER) /**< Heart rate measurement interval (ticks). */
#define MIN_HEART_RATE                       60                                         /**< Minimum heart rate as returned by the simulated measurement function. */
#define MAX_HEART_RATE                       300                                        /**< Maximum heart rate as returned by the simulated measurement function. */
#define HEART_RATE_CHANGE                    2                                          /**< Value by which the heart rate is incremented/decremented during button press. */

#define APP_GPIOTE_MAX_USERS                 1                                          /**< Maximum number of users of the GPIOTE handler. */

#define BUTTON_DETECTION_DELAY               APP_TIMER_TICKS(50, APP_TIMER_PRESCALER)   /**< Delay from a GPIOTE event until a button is reported as pushed (in number of timer ticks). */

#define MIN_CONN_INTERVAL                    MSEC_TO_UNITS(500, UNIT_1_25_MS)           /**< Minimum acceptable connection interval (0.5 seconds). */
#define MAX_CONN_INTERVAL                    MSEC_TO_UNITS(1000, UNIT_1_25_MS)          /**< Maximum acceptable connection interval (1 second). */
#define SLAVE_LATENCY                        0                                          /**< Slave latency. */
#define CONN_SUP_TIMEOUT                     MSEC_TO_UNITS(4000, UNIT_10_MS)            /**< Connection supervisory timeout (4 seconds). */

#define FIRST_CONN_PARAMS_UPDATE_DELAY       APP_TIMER_TICKS(5000, APP_TIMER_PRESCALER) /**< Time from initiating event (connect or start of notification) to first time sd_ble_gap_conn_param_update is called (5 seconds). */
#define NEXT_CONN_PARAMS_UPDATE_DELAY        APP_TIMER_TICKS(30000, APP_TIMER_PRESCALER)/**< Time between each call to sd_ble_gap_conn_param_update after the first call (30 seconds). */
#define MAX_CONN_PARAMS_UPDATE_COUNT         3                                          /**< Number of attempts before giving up the connection parameter negotiation. */

#define SEC_PARAM_TIMEOUT                    30                                         /**< Timeout for Pairing Request or Security Request (in seconds). */
#define SEC_PARAM_BOND                       1                                          /**< Perform bonding. */
#define SEC_PARAM_MITM                       0                                          /**< Man In The Middle protection not required. */
#define SEC_PARAM_IO_CAPABILITIES            BLE_GAP_IO_CAPS_NONE                       /**< No I/O capabilities. */
#define SEC_PARAM_OOB                        0                                          /**< Out Of Band data not available. */
#define SEC_PARAM_MIN_KEY_SIZE               7                                          /**< Minimum encryption key size. */
#define SEC_PARAM_MAX_KEY_SIZE               16                                         /**< Maximum encryption key size. */

//#define APP_ADV_INTERVAL_FAST            MSEC_TO_UNITS(100, UNIT_0_625_MS)               /**< Fast advertising interval (25 ms.). */
//#define APP_ADV_INTERVAL_SLOW            MSEC_TO_UNITS(2000, UNIT_0_625_MS)             /**< Slow advertising interval (2 seconds). */
//#define APP_FAST_ADV_TIMEOUT             180                                             /**< The duration of the fast advertising period (in seconds). */
//#define APP_SLOW_ADV_TIMEOUT             180                                            /**< The duration of the slow advertising period (in seconds). */
//#define APP_DIRECTED_ADV_TIMEOUT         180
#define APP_ADV_INTERVAL_FAST            MSEC_TO_UNITS(25, UNIT_0_625_MS)               /**< Fast advertising interval (25 ms.). */
#define APP_ADV_INTERVAL_SLOW            MSEC_TO_UNITS(2000, UNIT_0_625_MS)             /**< Slow advertising interval (2 seconds). */
#define APP_FAST_ADV_TIMEOUT             30                                             /**< The duration of the fast advertising period (in seconds). */
#define APP_SLOW_ADV_TIMEOUT             180                                            /**< The duration of the slow advertising period (in seconds). */
#define APP_DIRECTED_ADV_TIMEOUT         5


#define DEAD_BEEF                            0xDEADBEEF                                 /**< Value used as error code on stack dump, can be used to identify stack location on stack unwind. */
#define BLE_NUS_MAX_DATA_LEN            (GATT_MTU_SIZE_DEFAULT - 3)
#define NUS_SERVICE_UUID_TYPE           BLE_UUID_TYPE_VENDOR_BEGIN                  /**< UUID type for the Nordic UART Service (vendor specific). */
#define MCLR                            25
#define TX_POWER_LEVEL                  (-12)
typedef enum
{
    BLE_NO_ADV,               /**< No advertising running. */
    BLE_DIRECTED_ADV,         /**< Direct advertising to the latest central. */
    BLE_FAST_ADV_WHITELIST,   /**< Advertising with whitelist. */
    BLE_FAST_ADV,             /**< Fast advertising running. */
    BLE_SLOW_ADV,             /**< Slow advertising running. */
    BLE_SLEEP,                /**< Go to system-off. */
} ble_advertising_mode_t;


static ble_gap_adv_params_t                  m_adv_params;                              /**< Parameters to be passed to the stack when starting advertising. */
ble_bas_t                                    bas;                                       /**< Structure used to identify the battery service. */
static ble_hrs_t                             m_hrs;                                     /**< Structure used to identify the heart rate service. */
static volatile uint16_t                     m_cur_heart_rate;                          /**< Current heart rate value. */

static uint8_t                           m_advertising_mode;                            /**< Variable to keep track of when we are advertising. */
static dm_handle_t                       m_bonded_peer_handle;                          /**< Device reference handle to the current bonded central. */
static app_timer_id_t                        m_battery_timer_id;                        /**< Battery timer. */
static app_timer_id_t                        m_heart_rate_timer_id;                     /**< Heart rate measurement timer. */
static bool                                  m_memory_access_in_progress = false;       /**< Flag to keep track of ongoing operations on persistent memory. */
static dm_application_instance_t             m_app_handle;                              /**< Application identifier allocated by device manager */
static void ble_evt_dispatch(ble_evt_t * p_ble_evt);

static void sys_evt_dispatch(uint32_t sys_evt);

//----------------------

static uint8_t                           m_direct_adv_cnt;                              /**< Counter of direct advertisements. */
static ble_gap_addr_t                    m_ble_addr;                                    /**< Variable for getting and setting of BLE device address. */
static uint16_t           m_conn_handle;

static ble_nus_t          m_nus;                                      /**< Structure to identify the Nordic UART Service. */
static uint8_t    UART_data_index = 3;
int16_t	 fwd_bwd;
int16_t  lft_rgt;
uint8_t  command;







/*****************************************************************************
* Error Handling Functions
*****************************************************************************/


/**@brief Function for error handling, which is called when an error has occurred.
 *
 * @warning This handler is an example only and does not fit a final product. You need to analyze
 *          how your product is supposed to react in case of error.
 *
 * @param[in] error_code  Error code supplied to the handler.
 * @param[in] line_num    Line number where the handler is called.
 * @param[in] p_file_name Pointer to the file name.
 */
void app_error_handler(uint32_t error_code, uint32_t line_num, const uint8_t * p_file_name)
{
    // This call can be used for debug purposes during application development.
    // @note CAUTION: Activating this code will write the stack to flash on an error.
    //                This function should NOT be used in a final product.
    //                It is intended STRICTLY for development/debugging purposes.
    //                The flash write will happen EVEN if the radio is active, thus interrupting
    //                any communication.
    //                Use with care. Un-comment the line below to use.
    // ble_debug_assert_handler(error_code, line_num, p_file_name);

    // On assert, the system can only recover with a reset.
    NVIC_SystemReset();
}



/**@brief Callback function for asserts in the SoftDevice.
 *
 * @details This function will be called in case of an assert in the SoftDevice.
 *
 * @warning This handler is an example only and does not fit a final product. You need to analyze
 *          how your product is supposed to react in case of Assert.
 * @warning On assert from the SoftDevice, the system can only recover on reset.
 *
 * @param[in]   line_num   Line number of the failing ASSERT call.
 * @param[in]   file_name  File name of the failing ASSERT call.
 */
void assert_nrf_callback(uint16_t line_num, const uint8_t * p_file_name)
{
    app_error_handler(DEAD_BEEF, line_num, p_file_name);
}


/**@brief Function for handling a Connection Parameters error.
 *
 * @param[in]   nrf_error   Error code containing information about what went wrong.
 */
static void conn_params_error_handler(uint32_t nrf_error)
{
    APP_ERROR_HANDLER(nrf_error);
}


static void on_conn_params_evt(ble_conn_params_evt_t * p_evt)
{
    uint32_t err_code;

    if(p_evt->evt_type == BLE_CONN_PARAMS_EVT_FAILED)
    {
        err_code = sd_ble_gap_disconnect(m_conn_handle, BLE_HCI_CONN_INTERVAL_UNACCEPTABLE);
        APP_ERROR_CHECK(err_code);
    }

}


/*****************************************************************************
* Static Timeout Handling Functions
*****************************************************************************/

/**@brief Function for handling the Battery measurement timer timeout.
 *
 * @details This function will be called each time the battery level measurement timer expires.
 *          This function will start the ADC.
 *
 * @param[in]   p_context   Pointer used for passing some arbitrary information (context) from the
 *                          app_start_timer() call to the timeout handler.
 */
static void battery_level_meas_timeout_handler(void * p_context)
{
    UNUSED_PARAMETER(p_context);
    battery_start();
}


/**@brief Function for handling the Heart rate measurement timer timeout.
 *
 * @details This function will be called each time the heart rate measurement timer expires.
 *          It will exclude RR Interval data from every third measurement.
 *
 * @param[in]   p_context   Pointer used for passing some arbitrary information (context) from the
 *                          app_start_timer() call to the timeout handler.
 */
static void heart_rate_meas_timeout_handler(void * p_context)
{
    uint32_t err_code;

    UNUSED_PARAMETER(p_context);

    err_code = ble_hrs_heart_rate_measurement_send(&m_hrs, m_cur_heart_rate);

    if (
        (err_code != NRF_SUCCESS)
        &&
        (err_code != NRF_ERROR_INVALID_STATE)
        &&
        (err_code != BLE_ERROR_NO_TX_BUFFERS)
        &&
        (err_code != BLE_ERROR_GATTS_SYS_ATTR_MISSING)
    )
    {
        APP_ERROR_HANDLER(err_code);
    }
}


/**@brief Function for handling button events.
 *
 * @param[in]   pin_no   The pin number of the button pressed.
 */
static void button_event_handler(uint8_t pin_no, uint8_t button_action)
{
    if (button_action == APP_BUTTON_PUSH)
    {
        switch (pin_no)
        {
            case HR_INC_BUTTON_PIN_NO:
                // Increase Heart Rate measurement
                m_cur_heart_rate += HEART_RATE_CHANGE;
                if (m_cur_heart_rate > MAX_HEART_RATE)
                {
                    m_cur_heart_rate = MIN_HEART_RATE; // Loop back
                }
                break;

            case HR_DEC_BUTTON_PIN_NO:
                // Decrease Heart Rate measurement
                m_cur_heart_rate -= HEART_RATE_CHANGE;
                if (m_cur_heart_rate < MIN_HEART_RATE)
                {
                    m_cur_heart_rate = MAX_HEART_RATE; // Loop back
                }
                break;

            default:
                APP_ERROR_HANDLER(pin_no);
                break;
        }
    }
}


// uart init

/**@brief  Function for initializing the UART module.
 */

static void uart_init(void)
{
    /**@snippet [UART Initialization] */
    simple_uart_config(RTS_PIN_NUMBER, TX_PIN_NUMBER, CTS_PIN_NUMBER, RX_PIN_NUMBER, HWFC);

//  NRF_UART0->INTENSET = UART_INTENSET_RXDRDY_Enabled << UART_INTENSET_RXDRDY_Pos;

//    NVIC_SetPriority(UART0_IRQn, APP_IRQ_PRIORITY_LOW);
//    NVIC_EnableIRQ(UART0_IRQn);
    /**@snippet [UART Initialization] */
}

void UART0_IRQHandler(void)
{


  static uint8_t data_array[BLE_NUS_MAX_DATA_LEN];
   static uint8_t index = 0;
   uint32_t err_code;

   /**@snippet [Handling the data received over UART] */

   data_array[index] = simple_uart_get();
   index++;

   /**@snippet [Handling the data received over UART] */
				ParseCommandUART(data_array[index - 1]);
		        index = 0;
}

void ParseCommandUART(uint8_t cr)
{
    uint32_t err_code;

                //If waiting for a new command
                if (UART_data_index == 3)
                {
                    //Figure out which tyoe of command it is:
                    switch (cr)
                    {
                    	case 0x61: //standup
                    	case 0x62: //kneel
                    	case 0x63: // lean (one parameter)
                    	case 0x65: //estop
                    	case 0x66: //clear estop
                        case 'x'        :
                //        case NOTF_SET_STATUS:
                //        case DP_GOTO_BEACON:
                //        case DP_STOP:

                        				command = cr;
                                        UART_data_index = 0;

                                        /*
                                        err_code = ble_nus_send_string(&m_nus, "X", 1);
                                        if (err_code != NRF_ERROR_INVALID_STATE)
                                        {
                                                APP_ERROR_CHECK(err_code);
                                        }
                                        */

                                        break;


                        default         :                           //do nothinh

                                    //    err_code = ble_nus_send_string(&m_nus, "?", 1);
                                        if (err_code != NRF_ERROR_INVALID_STATE)
                                        {
                                                APP_ERROR_CHECK(err_code);
                                        }
                                        break;

                    }

                }   else { //its an ongoing command


                    //Ready for the data
                    if (UART_data_index == 0) //its the fwd_bwd byte
                    {
                         fwd_bwd = cr;
                         UART_data_index = 1;
                        //simple_uart_put('F');
                    } else {
                            if (UART_data_index == 1) //its the lft_rgt byte
                            {
                                lft_rgt = cr;

                                //all data received, time to calculate and drive
                                UART_data_index = 3;
                        /*

                               if(command == NOTF_SET_STATUS){
                        	//Send data over bluetooth
                                 uint8_t data[3] = {command, fwd_bwd, lft_rgt};
                           //      err_code = ble_nus_send_string(&m_nus, data, 3);

                              }else{
                                //Send data over the uart
                                simple_uart_put(command);
                                simple_uart_put(fwd_bwd);
                                simple_uart_put(lft_rgt);

                                // send data over bluetooth
                                uint8_t data[3] = {command, fwd_bwd, lft_rgt};
                               // err_code = ble_nus_send_string(&m_nus, data, 3);


                              }
                            */

                  uint32_t  err_code;

	          switch (command)
	   	    {

		      default:
		      break;
		    }

                }
            }

         }

}

/*****************************************************************************
* Static Initialization Functions
*****************************************************************************/

/**@brief Function for the Timer initialization.
 *
* @details Initializes the timer module. This creates and starts application timers.
*/
static void timers_init(void)
{
    uint32_t err_code;

    // Initialize timer module.
    APP_TIMER_INIT(APP_TIMER_PRESCALER, APP_TIMER_MAX_TIMERS, APP_TIMER_OP_QUEUE_SIZE, false);

    // Create timers.
    err_code = app_timer_create(&m_battery_timer_id,
                                APP_TIMER_MODE_REPEATED,
                                battery_level_meas_timeout_handler);
    APP_ERROR_CHECK(err_code);

    err_code = app_timer_create(&m_heart_rate_timer_id,
                                APP_TIMER_MODE_REPEATED,
                                heart_rate_meas_timeout_handler);
    APP_ERROR_CHECK(err_code);
}


/**@brief Function for the GAP initialization.
 *
 * @details This function sets up all the necessary GAP (Generic Access Profile) parameters of the
 *          device including the device name, appearance, and the preferred connection parameters.
 */
static void gap_params_init(void)
{
    uint32_t                err_code;
    ble_gap_conn_params_t   gap_conn_params;
    ble_gap_conn_sec_mode_t sec_mode;

    BLE_GAP_CONN_SEC_MODE_SET_OPEN(&sec_mode);

    err_code = sd_ble_gap_device_name_set(&sec_mode,
                                          (const uint8_t *)DEVICE_NAME,
                                          strlen(DEVICE_NAME));
    APP_ERROR_CHECK(err_code);

   // err_code = sd_ble_gap_appearance_set(BLE_APPEARANCE_HEART_RATE_SENSOR_HEART_RATE_BELT);
   // APP_ERROR_CHECK(err_code);

    memset(&gap_conn_params, 0, sizeof(gap_conn_params));

    gap_conn_params.min_conn_interval = MIN_CONN_INTERVAL;
    gap_conn_params.max_conn_interval = MAX_CONN_INTERVAL;
    gap_conn_params.slave_latency     = SLAVE_LATENCY;
    gap_conn_params.conn_sup_timeout  = CONN_SUP_TIMEOUT;


    err_code = sd_ble_gap_ppcp_set(&gap_conn_params);
    APP_ERROR_CHECK(err_code);

  //  err_code = sd_ble_gap_tx_power_set(TX_POWER_LEVEL);
  //  APP_ERROR_CHECK(err_code);
}


/**@brief Function for initializing the Advertising functionality.
 *
 * @details Encodes the required advertising data and passes it to the stack.
 *          Also builds a structure to be passed to the stack when starting advertising.
 */
static void advertising_init(uint8_t adv_flags)
{
    uint32_t      err_code;
    ble_advdata_t advdata;
    ble_advdata_t scanrsp;

    int8_t tx_power_level = TX_POWER_LEVEL;
   // uint8_t       flags = BLE_GAP_ADV_FLAGS_LE_ONLY_LIMITED_DISC_MODE;

    ble_uuid_t adv_uuids[] = {{BLE_UUID_NUS_SERVICE, m_nus.uuid_type}};

    err_code = sd_ble_gap_address_get(&m_ble_addr);
     APP_ERROR_CHECK(err_code);

     err_code = sd_ble_gap_address_set(BLE_GAP_ADDR_CYCLE_MODE_NONE, &m_ble_addr);
     APP_ERROR_CHECK(err_code);

    memset(&advdata, 0, sizeof(advdata));
    advdata.name_type               = BLE_ADVDATA_FULL_NAME;
    advdata.p_tx_power_level        = &tx_power_level;
    advdata.include_appearance      = false;
    advdata.flags.size              = sizeof(adv_flags);
    advdata.flags.p_data            = &adv_flags;
   // advdata.uuids_complete.uuid_cnt = sizeof(adv_uuids) / sizeof(adv_uuids[0]);
   // advdata.uuids_complete.p_uuids  = adv_uuids;

    memset(&scanrsp, 0, sizeof(scanrsp));
    scanrsp.uuids_complete.uuid_cnt = sizeof(adv_uuids) / sizeof(adv_uuids[0]);
    scanrsp.uuids_complete.p_uuids  = adv_uuids;

    err_code = ble_advdata_set(&advdata, &scanrsp);
    APP_ERROR_CHECK(err_code);
}

/**@brief    Function for handling the data from the Nordic UART Service.
 *
 * @details  This function will process the data received from the Nordic UART BLE Service and send
 *           it to the UART module.
 */
/**@snippet [Handling the data received over BLE] */
void nus_data_handler(ble_nus_t * p_nus, uint8_t * p_data, uint16_t length)
{
 //LOG("[nus_data_handler]: --");
	if(length >= 2 && p_data[0] == IR_CTRL){
		switch (p_data[1]) {
			case IR_HEAD_ON:
                 RGB_8color_set(clr_Blue);
        	     nrf_gpio_pin_set(IR_head);
        	     nrf_gpio_pin_clear(IR_gun);
        	     nrf_gpio_pin_clear(IR_back);
                 break;

			case IR_GUN_ON:
                RGB_8color_set(clr_Cyan);
       	        nrf_gpio_pin_clear(IR_head);
       	        nrf_gpio_pin_set(IR_gun);
       	        nrf_gpio_pin_clear(IR_back);
                 break;

			case IR_BACK_ON:
                RGB_8color_set(clr_Magenta);
       	        nrf_gpio_pin_clear(IR_head);
       	        nrf_gpio_pin_clear(IR_gun);
       	        nrf_gpio_pin_set(IR_back);
                 break;

			case IR_ALL_ON:
                RGB_8color_set(clr_Yollow);
       	        nrf_gpio_pin_set(IR_head);
       	        nrf_gpio_pin_set(IR_gun);
       	        nrf_gpio_pin_set(IR_back);
                 break;

			case IR_ALL_OFF:
                RGB_8color_set(clr_White);
       	        nrf_gpio_pin_clear(IR_head);
       	        nrf_gpio_pin_clear(IR_gun);
       	        nrf_gpio_pin_clear(IR_back);
                 break;
			default:
				break;
		}
	}

}

/**@brief Function for initializing services that will be used by the application.
 */
static void services_init(void)
{
    uint32_t         err_code;
    ble_nus_init_t   nus_init;

    memset(&nus_init, 0, sizeof(nus_init));

    nus_init.data_handler = nus_data_handler;

    err_code = ble_nus_init(&m_nus, &nus_init);
    APP_ERROR_CHECK(err_code);
}


/**@brief Function for initializing the services that will be used by the application.
 *
 * @details Initialize the Heart Rate, Battery and Device Information services.
 */
static void services_init_old(void)
{
    uint32_t       err_code;
    ble_hrs_init_t hrs_init;
    ble_bas_init_t bas_init;
    ble_dis_init_t dis_init;
    uint8_t        body_sensor_location;

    // Initialize Heart Rate Service.
    body_sensor_location = BLE_HRS_BODY_SENSOR_LOCATION_FINGER;

    memset(&hrs_init, 0, sizeof(hrs_init));

    hrs_init.is_sensor_contact_supported = false;
    hrs_init.p_body_sensor_location      = &body_sensor_location;

    // Here the sec level for the Heart Rate Service can be changed/increased.
    BLE_GAP_CONN_SEC_MODE_SET_OPEN(&hrs_init.hrs_hrm_attr_md.cccd_write_perm);
    BLE_GAP_CONN_SEC_MODE_SET_NO_ACCESS(&hrs_init.hrs_hrm_attr_md.read_perm);
    BLE_GAP_CONN_SEC_MODE_SET_NO_ACCESS(&hrs_init.hrs_hrm_attr_md.write_perm);

    BLE_GAP_CONN_SEC_MODE_SET_OPEN(&hrs_init.hrs_bsl_attr_md.read_perm);
    BLE_GAP_CONN_SEC_MODE_SET_NO_ACCESS(&hrs_init.hrs_bsl_attr_md.write_perm);

    err_code = ble_hrs_init(&m_hrs, &hrs_init);
    APP_ERROR_CHECK(err_code);

    // Initialize Battery Service.
    memset(&bas_init, 0, sizeof(bas_init));

    // Here the sec level for the Battery Service can be changed/increased.
    BLE_GAP_CONN_SEC_MODE_SET_OPEN(&bas_init.battery_level_char_attr_md.cccd_write_perm);
    BLE_GAP_CONN_SEC_MODE_SET_OPEN(&bas_init.battery_level_char_attr_md.read_perm);
    BLE_GAP_CONN_SEC_MODE_SET_NO_ACCESS(&bas_init.battery_level_char_attr_md.write_perm);

    BLE_GAP_CONN_SEC_MODE_SET_OPEN(&bas_init.battery_level_report_read_perm);

    bas_init.evt_handler          = NULL;
    bas_init.support_notification = true;
    bas_init.p_report_ref         = NULL;
    bas_init.initial_batt_level   = 100;

    err_code = ble_bas_init(&bas, &bas_init);
    APP_ERROR_CHECK(err_code);

    // Initialize Device Information Service
    memset(&dis_init, 0, sizeof(dis_init));

    ble_srv_ascii_to_utf8(&dis_init.manufact_name_str, MANUFACTURER_NAME);

    BLE_GAP_CONN_SEC_MODE_SET_OPEN(&dis_init.dis_attr_md.read_perm);
    BLE_GAP_CONN_SEC_MODE_SET_NO_ACCESS(&dis_init.dis_attr_md.write_perm);



    err_code = ble_dis_init(&dis_init);
    APP_ERROR_CHECK(err_code);
}




/**@brief Function for initializing the Connection Parameters module.
 */
static void conn_params_init(void)
{
    uint32_t               err_code;
    ble_conn_params_init_t cp_init;

    memset(&cp_init, 0, sizeof(cp_init));

    cp_init.p_conn_params                  = NULL;
    cp_init.first_conn_params_update_delay = FIRST_CONN_PARAMS_UPDATE_DELAY;
    cp_init.next_conn_params_update_delay  = NEXT_CONN_PARAMS_UPDATE_DELAY;
    cp_init.max_conn_params_update_count   = MAX_CONN_PARAMS_UPDATE_COUNT;
    cp_init.start_on_notify_cccd_handle    = m_hrs.hrm_handles.cccd_handle;
   // cp_init.disconnect_on_fail             = true;
    cp_init.disconnect_on_fail             = false;
//    cp_init.evt_handler                    = on_conn_params_evt;
    cp_init.evt_handler                    = NULL;
    cp_init.error_handler                  = conn_params_error_handler;

    err_code = ble_conn_params_init(&cp_init);
    APP_ERROR_CHECK(err_code);
}


/**@brief Function for handling the Device Manager events.
 *
 * @param[in]   p_evt   Data associated to the device manager event.
 */
static uint32_t device_manager_evt_handler(dm_handle_t const    * p_handle,
                                           dm_event_t const     * p_event,
                                           api_result_t           event_result)
{
    APP_ERROR_CHECK(event_result);
    return NRF_SUCCESS;
}


/**@brief Function for the Device Manager initialization.
 */
static void device_manager_init(void)
{
    uint32_t                err_code;
    dm_init_param_t         init_data;
    dm_application_param_t  register_param;

    // Initialize peer device handle.
    err_code = dm_handle_initialize(&m_bonded_peer_handle);
    APP_ERROR_CHECK(err_code);

    // Initialize persistent storage module.
    err_code = pstorage_init();
    APP_ERROR_CHECK(err_code);

    // Clear all bonded centrals if the Bonds Delete button is pushed.
    //init_data.clear_persistent_data = (nrf_gpio_pin_read(BOND_DELETE_ALL_BUTTON_ID) == 0);

    err_code = dm_init(&init_data);
    APP_ERROR_CHECK(err_code);

    memset(&register_param.sec_param, 0, sizeof(ble_gap_sec_params_t));

    register_param.sec_param.timeout      = SEC_PARAM_TIMEOUT;
    register_param.sec_param.bond         = SEC_PARAM_BOND;
    register_param.sec_param.mitm         = SEC_PARAM_MITM;
    register_param.sec_param.io_caps      = SEC_PARAM_IO_CAPABILITIES;
    register_param.sec_param.oob          = SEC_PARAM_OOB;
    register_param.sec_param.min_key_size = SEC_PARAM_MIN_KEY_SIZE;
    register_param.sec_param.max_key_size = SEC_PARAM_MAX_KEY_SIZE;
    register_param.evt_handler            = device_manager_evt_handler;
    register_param.service_type           = DM_PROTOCOL_CNTXT_GATT_SRVR_ID;

    err_code = dm_register(&m_app_handle, &register_param);
    APP_ERROR_CHECK(err_code);
}


/**@brief Function for initializing the BLE stack.
 *
 * @details Initializes the SoftDevice and the BLE event interrupt.
 */
static void ble_stack_init(void)
{
    uint32_t err_code;

    // Initialize the SoftDevice handler module.
   // SOFTDEVICE_HANDLER_INIT(NRF_CLOCK_LFCLKSRC_XTAL_20_PPM, false);

    SOFTDEVICE_HANDLER_INIT(NRF_CLOCK_LFCLKSRC_RC_250_PPM_4000MS_CALIBRATION, false);
    // Enable BLE stack
    ble_enable_params_t ble_enable_params;
    memset(&ble_enable_params, 0, sizeof(ble_enable_params));
    ble_enable_params.gatts_enable_params.service_changed = IS_SRVC_CHANGED_CHARACT_PRESENT;
    err_code = sd_ble_enable(&ble_enable_params);
    APP_ERROR_CHECK(err_code);

    // Register with the SoftDevice handler module for BLE events.
    err_code = softdevice_ble_evt_handler_set(ble_evt_dispatch);
    APP_ERROR_CHECK(err_code);

    // Register with the SoftDevice handler module for BLE events.
    err_code = softdevice_sys_evt_handler_set(sys_evt_dispatch);
    APP_ERROR_CHECK(err_code);
}


/**@brief Function for initializing the GPIOTE module.
 */
static void gpiote_init(void)
{
    APP_GPIOTE_INIT(APP_GPIOTE_MAX_USERS);
}


/**@brief Function for initializing the button module.
 */
static void buttons_init(void)
{
    // Configure HR_INC_BUTTON_PIN_NO and HR_DEC_BUTTON_PIN_NO as wake up buttons and also configure
    // for 'pull up' because the eval board does not have external pull up resistors connected to
    // the buttons.
/*    static app_button_cfg_t buttons[] =
    {
        {HR_INC_BUTTON_PIN_NO, false, BUTTON_PULL, button_event_handler},
        {HR_DEC_BUTTON_PIN_NO, false, BUTTON_PULL, button_event_handler}  // Note: This pin is also BONDMNGR_DELETE_BUTTON_PIN_NO
    };

    APP_BUTTON_INIT(buttons, sizeof(buttons) / sizeof(buttons[0]), BUTTON_DETECTION_DELAY, false);

*/
}


/*****************************************************************************
* Static Start Functions
*****************************************************************************/

/**@brief Function for starting the application timers.
 */
static void application_timers_start(void)
{
    uint32_t err_code;

    // Start application timers
    err_code = app_timer_start(m_battery_timer_id, BATTERY_LEVEL_MEAS_INTERVAL, NULL);
    APP_ERROR_CHECK(err_code);

    err_code = app_timer_start(m_heart_rate_timer_id, HEART_RATE_MEAS_INTERVAL, NULL);
    APP_ERROR_CHECK(err_code);
}


/**@brief Function for starting advertising.
 */
static void advertising_start(void)
{
    uint32_t             err_code;
    ble_gap_adv_params_t adv_params;
    ble_gap_whitelist_t  whitelist;
    ble_gap_addr_t       peer_address;
    uint32_t             count;


    err_code = pstorage_access_status_get(&count);
    APP_ERROR_CHECK(err_code);

    if (count != 0)
    {
        m_memory_access_in_progress = true;
        return;
    }

    // Start advertising
    memset(&adv_params, 0, sizeof(adv_params));

    adv_params.type        = BLE_GAP_ADV_TYPE_ADV_IND;
    adv_params.p_peer_addr = NULL;
    adv_params.fp          = BLE_GAP_ADV_FP_ANY;

   // adv_params.interval    = APP_ADV_INTERVAL;
   // adv_params.timeout     = APP_ADV_TIMEOUT_IN_SECONDS;
    adv_params.p_whitelist = NULL;

    if (m_advertising_mode == BLE_DIRECTED_ADV)
       {
           err_code = dm_peer_addr_get(&m_bonded_peer_handle, &peer_address);

           //-----------------------
           LOG("advertising_start#BLE_DIRECT_ADV  ");
           LOG( " peer_addres:  %d %d %d %d %d %d",
           		peer_address.addr[0], peer_address.addr[1], peer_address.addr[2],
           		peer_address.addr[3], peer_address.addr[4], peer_address.addr[5] );
           LOG(" type: %d \r\n", peer_address.addr_type);

           if (err_code != NRF_SUCCESS)
           {
               m_advertising_mode = BLE_FAST_ADV_WHITELIST;
           }
       }


    switch (m_advertising_mode)
      {
          case BLE_NO_ADV:
              m_advertising_mode = BLE_FAST_ADV_WHITELIST;
              // Fall through.

          case BLE_FAST_ADV_WHITELIST:
          {
              ble_gap_addr_t       * p_whitelist_addr[BLE_GAP_WHITELIST_ADDR_MAX_COUNT];
  //            ble_gap_addr_t       * p_whitelist_addr[1];
              ble_gap_irk_t        * p_whitelist_irk[BLE_GAP_WHITELIST_IRK_MAX_COUNT];
             // ble_gap_irk_t        * p_whitelist_irk[1];

             // whitelist.addr_count = BLE_GAP_WHITELIST_ADDR_MAX_COUNT;
              whitelist.addr_count = NB_ROBOTS;
             // whitelist.irk_count  = BLE_GAP_WHITELIST_IRK_MAX_COUNT;
              whitelist.irk_count  =  NB_ROBOTS;
              whitelist.pp_addrs   = p_whitelist_addr;
              whitelist.pp_irks    = p_whitelist_irk;
              err_code = dm_whitelist_create(&m_app_handle, &whitelist);
              APP_ERROR_CHECK(err_code);
               LOG( "BLE_FAST_ADV_WHITELIST   %d  %d", whitelist.addr_count, whitelist.irk_count);
              if ((whitelist.addr_count != 0) || (whitelist.irk_count != 0))
              {
                  adv_params.fp          = BLE_GAP_ADV_FP_FILTER_CONNREQ;
                  adv_params.p_whitelist = &whitelist;

                  advertising_init(BLE_GAP_ADV_FLAG_BR_EDR_NOT_SUPPORTED);
#ifdef BOND_MODE
                  m_advertising_mode = BLE_FAST_ADV;
               //   nrf_gpio_pin_set(ADV_WHITELIST_LED_PIN_NO);
              }
              else
              {
                 m_advertising_mode = BLE_SLOW_ADV;
#endif
              }

              adv_params.interval = APP_ADV_INTERVAL_FAST;
              adv_params.timeout  = APP_FAST_ADV_TIMEOUT;
              break;
          }

          case BLE_DIRECTED_ADV:
              adv_params.p_peer_addr = &peer_address;
              adv_params.type        = BLE_GAP_ADV_TYPE_ADV_DIRECT_IND;
              adv_params.timeout     = 0;

              m_direct_adv_cnt--;
              if (m_direct_adv_cnt == 0)
              {
                  m_advertising_mode = BLE_FAST_ADV_WHITELIST;
              }
  //            nrf_gpio_pin_set(ADV_DIRECTED_LED_PIN_NO);
              break;

          case BLE_FAST_ADV:
              advertising_init(BLE_GAP_ADV_FLAGS_LE_ONLY_LIMITED_DISC_MODE);

              adv_params.interval = APP_ADV_INTERVAL_FAST;
              adv_params.timeout  = APP_FAST_ADV_TIMEOUT;
              m_advertising_mode  = BLE_SLOW_ADV;
              break;

          case BLE_SLOW_ADV:
              advertising_init(BLE_GAP_ADV_FLAGS_LE_ONLY_LIMITED_DISC_MODE);

              adv_params.interval = APP_ADV_INTERVAL_SLOW;
              adv_params.timeout  = APP_SLOW_ADV_TIMEOUT;
              m_advertising_mode  = BLE_SLEEP;

            //  nrf_gpio_pin_set(ADV_INTERVAL_SLOW_LED_PIN_NO);
              break;

          default:
              // No implementation needed.
              break;
      }

    LOG( " advertising start mode: %d \r\n", m_advertising_mode);
    err_code = sd_ble_gap_adv_start(&adv_params);
    APP_ERROR_CHECK(err_code);
}


/**@brief Function for putting the chip in System OFF Mode
 */
static void system_off_mode_enter(void)
{
    uint32_t err_code;
    uint32_t count;

    // Verify if there is any flash access pending, if yes delay starting advertising until
    // it's complete.
    err_code = pstorage_access_status_get(&count);
    APP_ERROR_CHECK(err_code);

    if (count != 0)
    {
        m_memory_access_in_progress = true;
        return;
    }

    err_code = sd_power_system_off();
    APP_ERROR_CHECK(err_code);
}


/*****************************************************************************
* Static Event Handling Functions
*****************************************************************************/

/**@brief Function for handling the Application's BLE Stack events.
 *
 * @param[in]   p_ble_evt   Bluetooth stack event.
 */
static void on_ble_evt(ble_evt_t * p_ble_evt)
{
    uint32_t        err_code;

   	uint8_t p_is_nested_critical_region;
    switch (p_ble_evt->header.evt_id)
    {
        case BLE_GAP_EVT_CONNECTED:
         //   led_stop();

            // Initialize the current heart rate to the average of max and min values. So that
            // everytime a new connection is made, the heart rate starts from the same value.
          //  m_cur_heart_rate = (MAX_HEART_RATE + MIN_HEART_RATE) / 2;

            // Start timers used to generate battery and HR measurements.
          //  application_timers_start();

            // Start handling button presses
           // err_code = app_button_enable();
            //APP_ERROR_CHECK(err_code);
           // simple_uart_put(0x3E);
           // simple_uart_put('M');
           // simple_uart_put(0x0A);
         //   nrf_gpio_pin_set(MCLR);
            //RGB_show_color(clr_Green);
            m_conn_handle      = p_ble_evt->evt.gap_evt.conn_handle;
            m_advertising_mode = BLE_NO_ADV;

//        	 RGB_8color_set(clr_Green);
//        	 nrf_gpio_pin_set(IR_head);
//        	 nrf_gpio_pin_set(IR_gun);
//        	 nrf_gpio_pin_set(IR_back);
            nrf_gpio_pin_set(MCLR);
             LOG( "connected ...\r\n");
        	break;

        case BLE_GAP_EVT_DISCONNECTED:
            // @note Flash access may not be complete on return of this API. System attributes are now
            // stored to flash when they are updated to ensure flash access on disconnect does not
            // result in system powering off before data was successfully written.

            // Go to system-off mode, should not return from this function, wakeup will trigger
            // a reset.
      //      system_off_mode_enter();
        	sd_nvic_critical_region_enter(&p_is_nested_critical_region);
        	//	 nrf_gpio_pin_clear(MCLR);
//         	 nrf_gpio_pin_clear(IR_head);
//        	 nrf_gpio_pin_clear(IR_gun);
//        	 nrf_gpio_pin_clear(IR_back);
//        	 RGB_8color_set(clr_Red);

        	 //nrf_gpio_pin_clear(IR_head);
        	 //nrf_gpio_pin_clear(IR_gun);

             nrf_gpio_pin_clear(MCLR);
             sd_nvic_critical_region_exit(p_is_nested_critical_region);

            m_conn_handle = BLE_CONN_HANDLE_INVALID;
            m_advertising_mode = BLE_DIRECTED_ADV;
                        m_direct_adv_cnt   = APP_DIRECTED_ADV_TIMEOUT;
             advertising_start();
             LOG( "disconnected ...\r\n");
            //simple_uart_put(0x3E);
            //simple_uart_put('S');
            //simple_uart_put(0x0A);

            break;

        case BLE_GAP_EVT_TIMEOUT:
        	LOG("BLE_GAP_EVT_TIMEOUT \r\n");
             nrf_gpio_pin_clear(MCLR);
            if (p_ble_evt->evt.gap_evt.params.timeout.src == BLE_GAP_TIMEOUT_SRC_ADVERTISEMENT)
            {
               // led_stop();
            	//advertising_init();
            	advertising_start();

//                nrf_gpio_cfg_sense_input(HR_INC_BUTTON_PIN_NO,
 //                                        BUTTON_PULL,
  //                                       NRF_GPIO_PIN_SENSE_LOW);

   //             nrf_gpio_cfg_sense_input(HR_DEC_BUTTON_PIN_NO,
    //                                     BUTTON_PULL,
     //                                    NRF_GPIO_PIN_SENSE_LOW);

      //          system_off_mode_enter();
            }
            break;
        case BLE_GAP_EVT_SEC_PARAMS_REQUEST:
        	 LOG("BLE_GAP_EVT_SEC_PARAMS_REQUEST \r\n");
        	 break;
        case BLE_GAP_EVT_CONN_SEC_UPDATE:
        	LOG("BLE_GAP_EVT_CONN_SEC_UPDATE \r\n");
        	break;
        case BLE_GAP_EVT_AUTH_STATUS:
        	LOG("BLE_GAP_EVT_AUTH_STATUS \r\n");
        	break;
        default:
            // No implementation needed.
        	LOG("default: %d \r\n",p_ble_evt->header.evt_id );
            break;
    }
}


/**@brief Function for handling the Application's system events.
 *
 * @param[in]   sys_evt   system event.
 */
static void on_sys_evt(uint32_t sys_evt)
{
    switch(sys_evt)
    {
        case NRF_EVT_FLASH_OPERATION_SUCCESS:
        case NRF_EVT_FLASH_OPERATION_ERROR:
            if (m_memory_access_in_progress)
            {
                m_memory_access_in_progress = false;
                system_off_mode_enter();
            }
            break;
        default:
            // No implementation needed.
            break;
    }
}


/**@brief Function for dispatching a BLE stack event to all modules with a BLE stack event handler.
 *
 * @details This function is called from the BLE Stack event interrupt handler after a BLE stack
 *          event has been received.
 *
 * @param[in]   p_ble_evt   Bluetooth stack event.
 */
static void ble_evt_dispatch(ble_evt_t * p_ble_evt)
{
    dm_ble_evt_handler(p_ble_evt);
    ble_hrs_on_ble_evt(&m_hrs, p_ble_evt);
    ble_bas_on_ble_evt(&bas, p_ble_evt);
    ble_conn_params_on_ble_evt(p_ble_evt);
    ble_nus_on_ble_evt(&m_nus, p_ble_evt);

    on_ble_evt(p_ble_evt);
}


/**@brief Function for dispatching a system event to interested modules.
 *
 * @details This function is called from the System event interrupt handler after a system
 *          event has been received.
 *
 * @param[in]   sys_evt   System stack event.
 */
static void sys_evt_dispatch(uint32_t sys_evt)
{
    pstorage_sys_event_handler(sys_evt);
    on_sys_evt(sys_evt);
}


/*****************************************************************************
* Main Function
*****************************************************************************/

/**@brief Function for the application main entry.
 */
int main(void)
{
    uint32_t err_code;
    uart_init();
    timers_init();
    gpiote_init();
    buttons_init();
    ble_stack_init();
    device_manager_init();

    // Initialize Bluetooth Stack parameters.
    gap_params_init();
    services_init();
//    advertising_init();
    advertising_init(BLE_GAP_ADV_FLAGS_LE_ONLY_LIMITED_DISC_MODE);
    conn_params_init();
//    REV_main_initialize();
    advertising_start();

    // xyz board init
     nrf_gpio_cfg_output(MCLR);
     nrf_delay_ms(200);
     nrf_gpio_pin_clear(MCLR);

   LOG("Beacon - setup completed ... \n");



    // Enter main loop.
    for (;;)
    {
        // Switch to a low power state until an event is available for the application
        nrf_delay_ms(50);
    	err_code = sd_app_evt_wait();
        APP_ERROR_CHECK(err_code);
    }
}

/**
 * @}
 */
