bens-unit01/switchbot-complete-prj/microcontrollers/stm32f4/Inc/motors.h

/**
  ******************************************************************************
  * File Name          : USART.h
  * Description        : This file provides code for the configuration
  *                      of the USART instances.
  ******************************************************************************
  *
  * COPYRIGHT(c) 2015 STMicroelectronics
  *
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
  ******************************************************************************
  */
/* Define to prevent recursive inclusion -------------------------------------*/
#ifndef __motors_H
#define __motors_H
#ifdef __cplusplus
 extern "C" {
#endif

/* Includes ------------------------------------------------------------------*/
#include "stm32f4xx_hal.h"

//#define MaxPWM 200 
#define MaxPWM 140 
#define ULIM						1.0	
static const double UDIR[] = {-1.0, -1.0, 1.0, -1.0, 1.0, -1.0};	



void enableMotors(void);
void disableMotors(void);
void driveMotors(float u[]); 

#ifdef __cplusplus
}
#endif
#endif /*__motors_H */

/**
  * @}
  */

/**
  * @}
  */

/************************ (C) COPYRIGHT STMicroelectronics *****END OF FILE****/
