bens-unit01/switchbot-complete-prj/microcontrollers/nordic/BLE_BEACON/car_driver/TIMER2.h

//=======================================================================
//.T		包含文件.
//=======================================================================
#include <stdbool.h>
#include <stdint.h>
//-----------------------
#ifndef		__JC_TIMER2_H__
#define		__JC_TIMER2_H__

//=======================================================================
//.T		全局函数声明.
//=======================================================================
void TIMER2_init(void);
void IR_gpio_init(void);
void IRM_calc_coord(void);

//=======================================================================
#endif	//__JC_TIMER2_H__.

//********************************* end *********************************//
