bens-unit01/switchbot-complete-prj/microcontrollers/nordic/BLE_BEACON/nrf51_service/nst_ble_bls.h

//=====================================================================================================================
/*---------------------------------------------------------------------------------------------------------*/
/* Battery Level Service(0x180F)                                                                           */
/* --Battery Level Report Characteristic(0x2A19)                       RN   1                              */
/*---------------------------------------------------------------------------------------------------------*/
#ifndef __NST_BLE_BLS_H__
#define __NST_BLE_BLS_H__

void ble_bls_on_ble_evt(ble_evt_t * p_ble_evt);
void ble_bls_init(void);

#endif // __NST_BLE_BLS_H__
//=====================================================================================================================
